nicedreamzapp/sitka/cad/renders/stoop_34.png

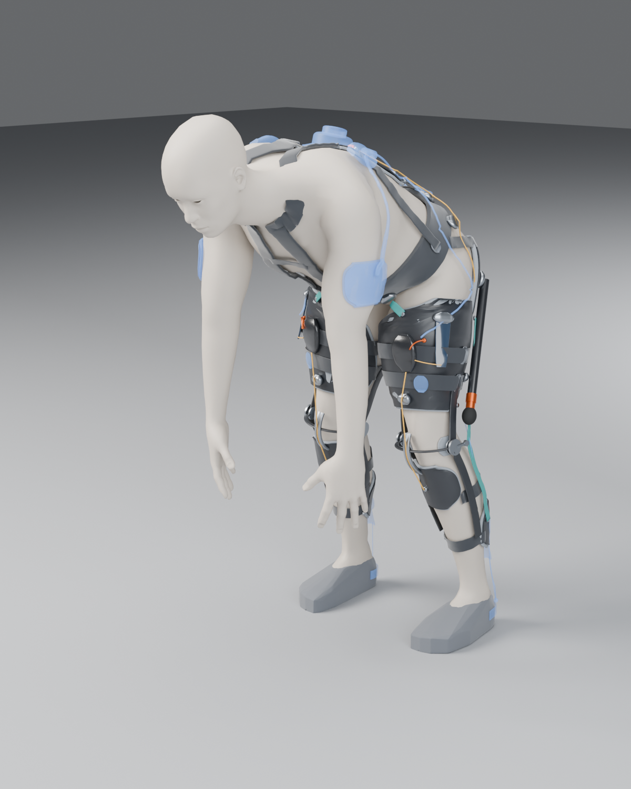
cad/renders/stoop_34.png
