nicedreamzapp/sitka/cad/renders/walk_34.png

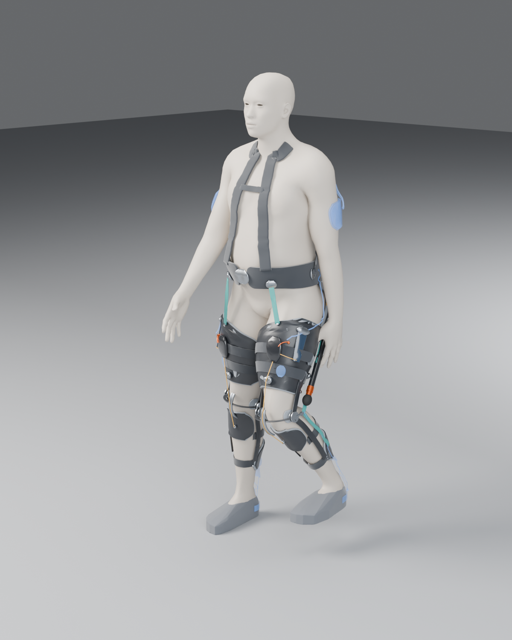
cad/renders/walk_34.png
