nicedreamzapp/sitka/cad/build/fit_report.txt

stand  strut_l: length 0.282 m (stowed)
stand  strut_r: length 0.282 m (stowed)
stand  T1 l: wrap 2 deg, phi 14..16, on arc: True
stand  T1 r: wrap 2 deg, phi 14..16, on arc: True
stand  CABLE calf_band_r: enters body by 3 mm
stand  PART knee_arc_l: into body 3.7 mm at (0.174, -0.065, 0.497)
stand  PART knee_arc_r: into body 3.7 mm at (-0.174, -0.065, 0.497)
walk   strut_l: length 0.282 m (stowed)
walk   strut_r: length 0.282 m (stowed)
walk   T1 l: wrap 59 deg, phi -15..44, on arc: True
walk   T1 r: wrap 10 deg, phi 10..20, on arc: True
walk   PART thigh_shell_l: into body 4.9 mm at (0.217, -0.01, 0.905)
walk   PART thigh_liner_l: into body 2.7 mm at (0.214, -0.02, 0.883)
run    strut_l: length 0.282 m (stowed)
run    strut_r: length 0.282 m (stowed)
run    T1 l: wrap 107 deg, phi -39..68, on arc: False
run    T1 r: wrap 42 deg, phi -6..35, on arc: True
run    FLOAT knee_arc_l: nearest skin 34 mm, at (0.145, -0.432, 0.705)
chair  strut_l: length 0.455 m (deployed)
chair  strut_r: length 0.455 m (deployed)
chair  T1 l: wrap 91 deg, phi -31..60, on arc: True
chair  T1 r: wrap 91 deg, phi -31..60, on arc: True
stoop  strut_l: length 0.282 m (stowed)
stoop  strut_r: length 0.282 m (stowed)
stoop  T1 l: wrap 24 deg, phi 3..27, on arc: True
stoop  T1 r: wrap 24 deg, phi 3..27, on arc: True
stoop  PART back_panel_liner: into body 3.8 mm at (-0.037, -0.302, 1.273)
stand  PANEL off the chest bone 0.5 deg / 0.4 mm, liner-gap change max 2.1 mm, spine link length error 0.00 mm
walk   PANEL off the chest bone 0.4 deg / 0.2 mm, liner-gap change max 2.4 mm, spine link length error 0.00 mm
run    PANEL off the chest bone 0.4 deg / 0.1 mm, liner-gap change max 2.7 mm, spine link length error 0.00 mm
chair  PANEL off the chest bone 0.4 deg / 0.3 mm, liner-gap change max 2.4 mm, spine link length error 0.00 mm
stoop  PANEL off the chest bone 2.8 deg / 43.0 mm, liner-gap change max 8.1 mm, spine link length error 0.01 mm
