nicedreamzapp/sitka/cad/renders/chair_34.png

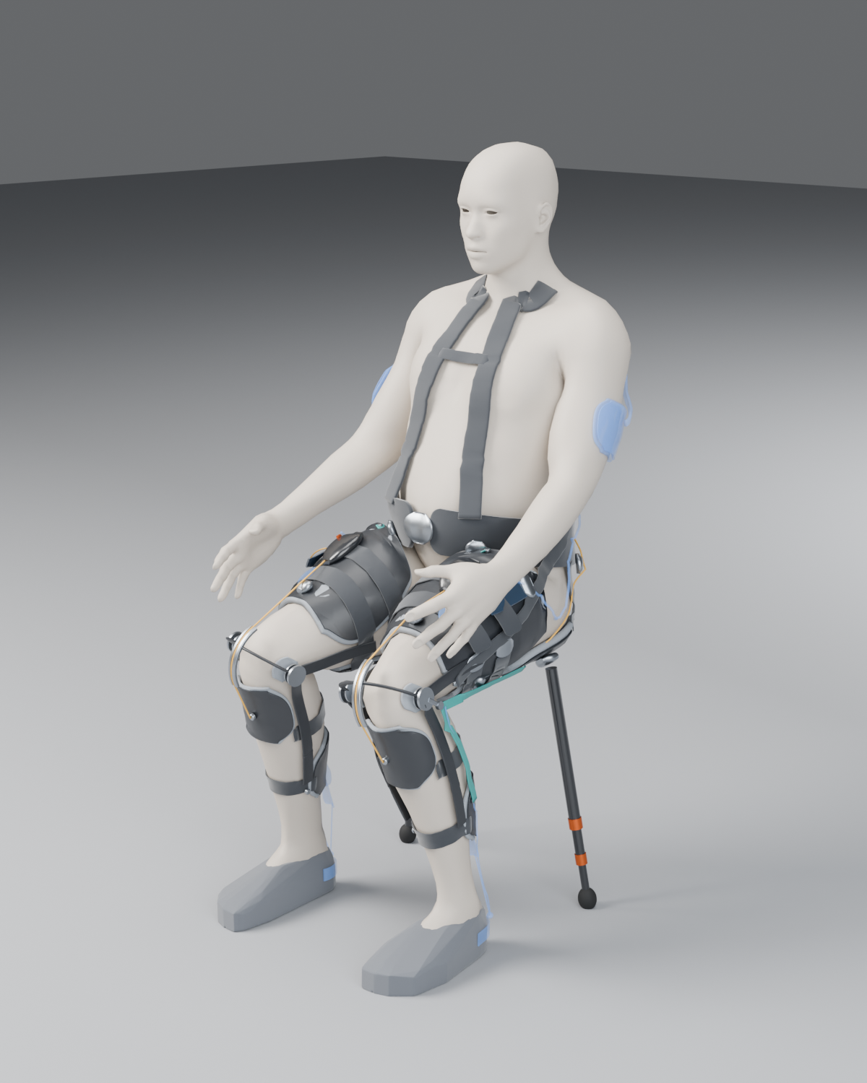
cad/renders/chair_34.png
