nicedreamzapp/sitka/cad/renders/chair_back.png

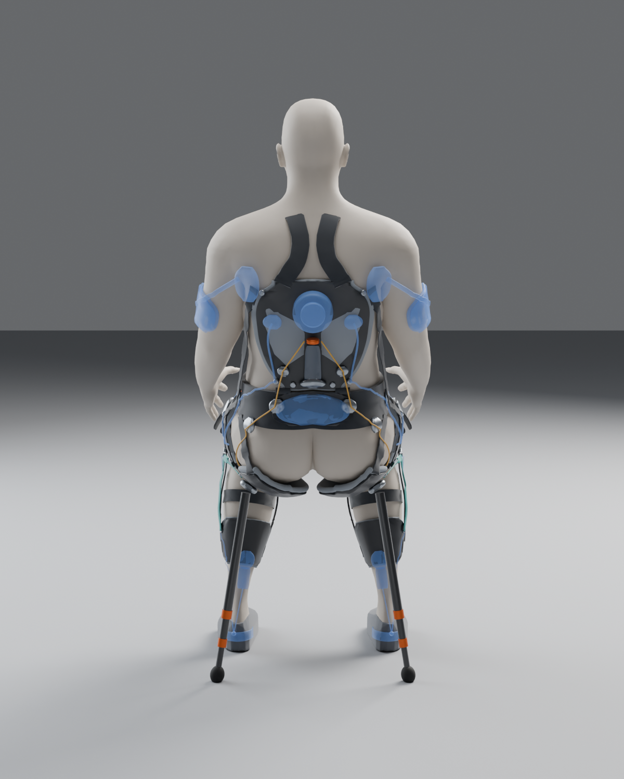
cad/renders/chair_back.png
