nicedreamzapp/sitka/cad/renders/chair_front.png

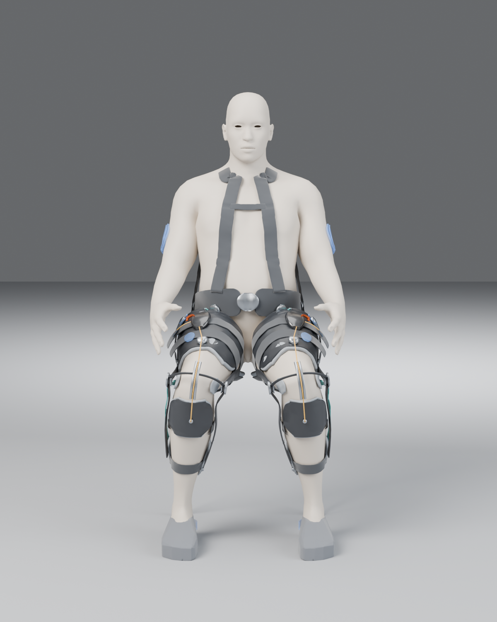
cad/renders/chair_front.png
