nicedreamzapp/sitka/cad/renders/chair_side.png

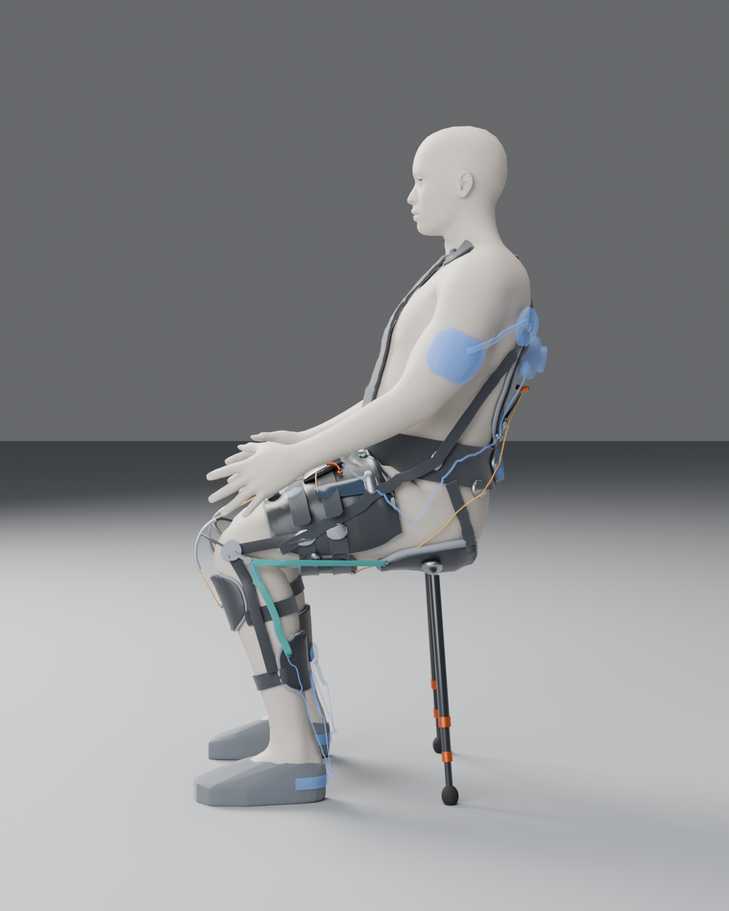
cad/renders/chair_side.png
