nicedreamzapp/sitka/cad/renders/run_34.png

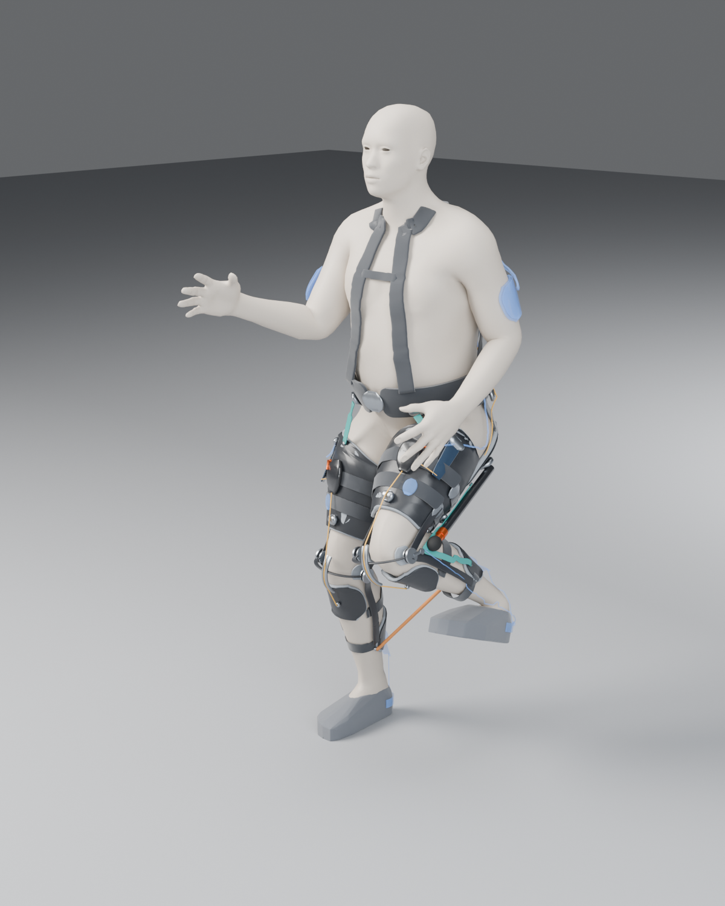
cad/renders/run_34.png
