nicedreamzapp/sitka/cad/renders/run_back.png

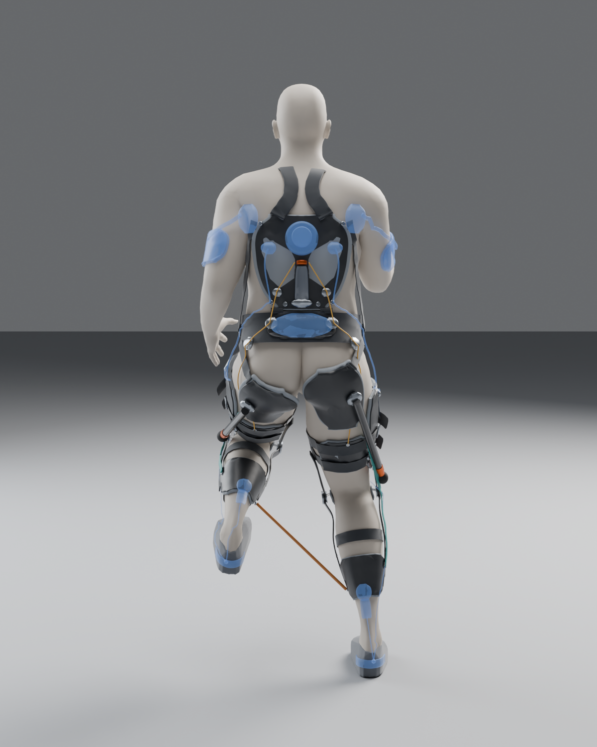
cad/renders/run_back.png
