nicedreamzapp/sitka/cad/renders/run_front.png

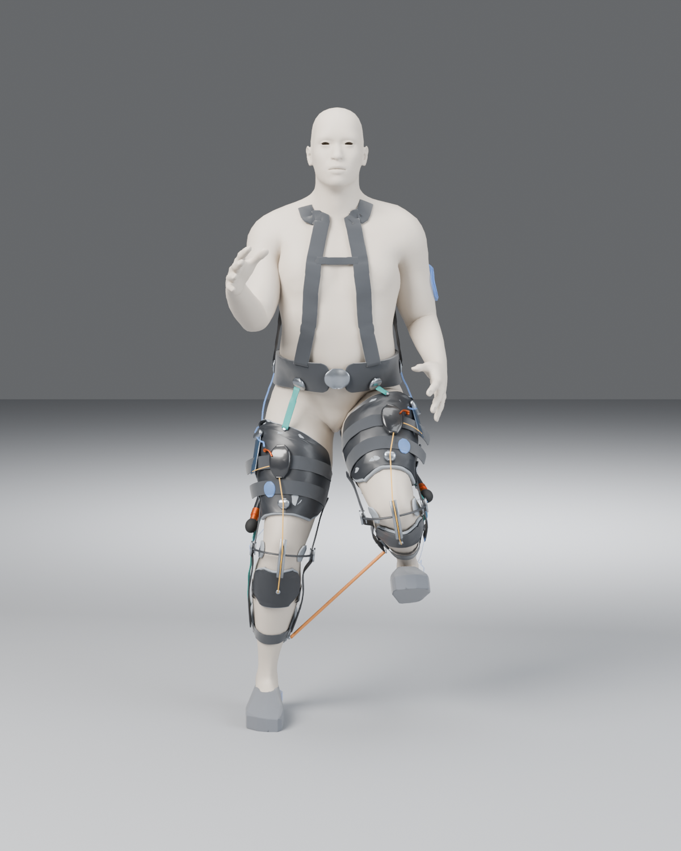
cad/renders/run_front.png
