nicedreamzapp/sitka/cad/renders/run_side.png

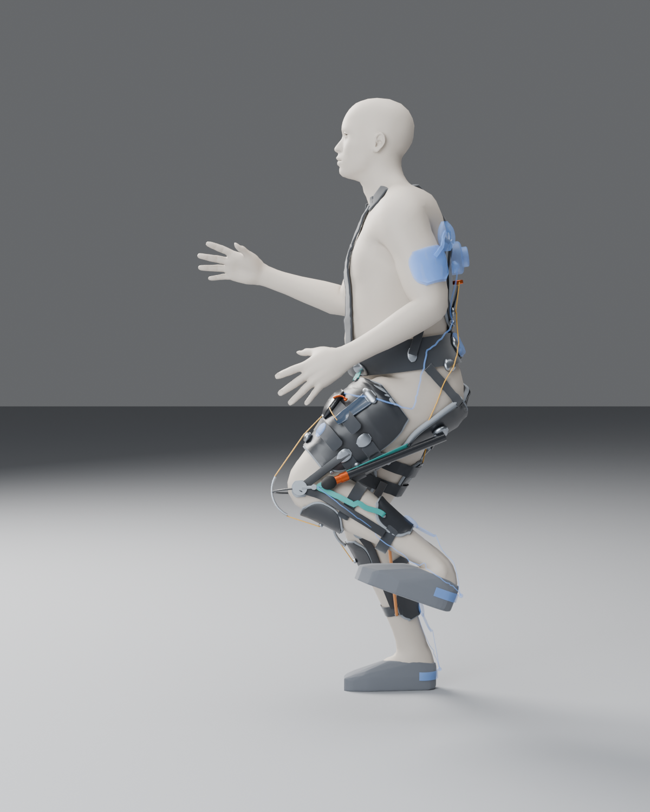
cad/renders/run_side.png
