nicedreamzapp/sitka/cad/renders/stand_34.png

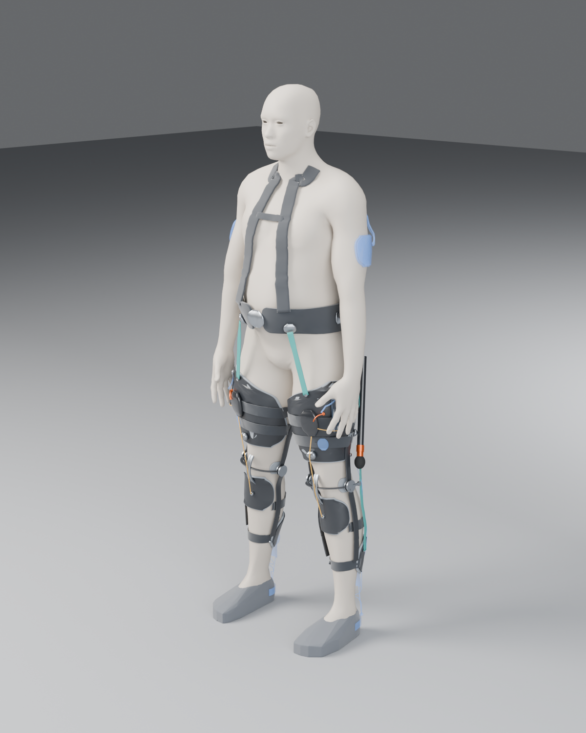
cad/renders/stand_34.png
