nicedreamzapp/sitka/cad/renders/stand_back.png

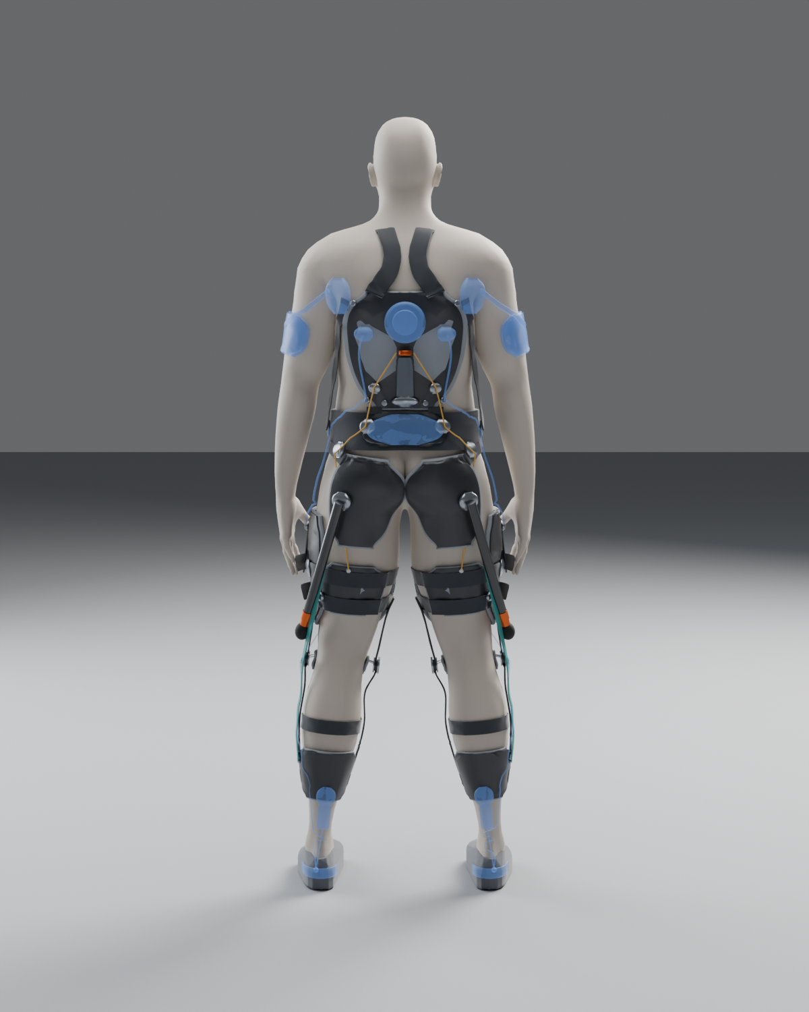
cad/renders/stand_back.png
