nicedreamzapp/sitka/cad/renders/stand_front.png

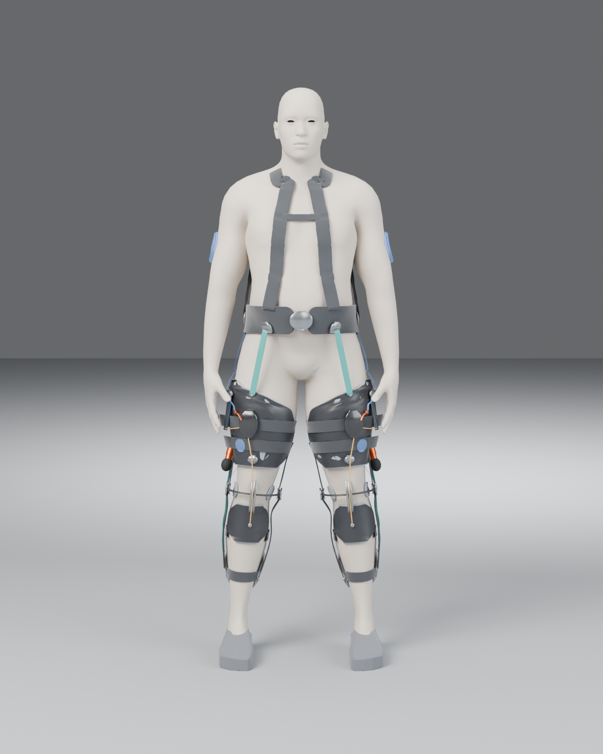
cad/renders/stand_front.png
