nicedreamzapp/sitka/cad/renders/stand_side.png

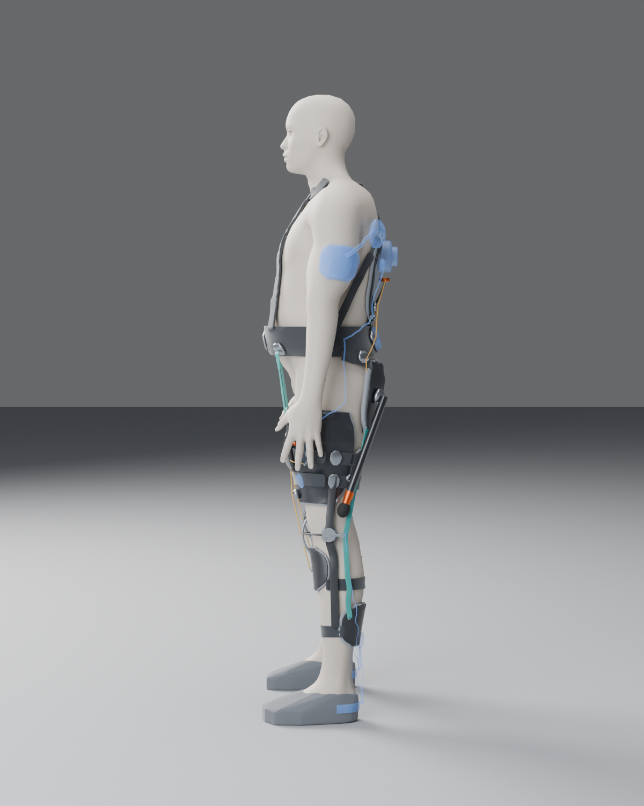
cad/renders/stand_side.png
