nicedreamzapp/sitka/cad/renders/stoop_back.png

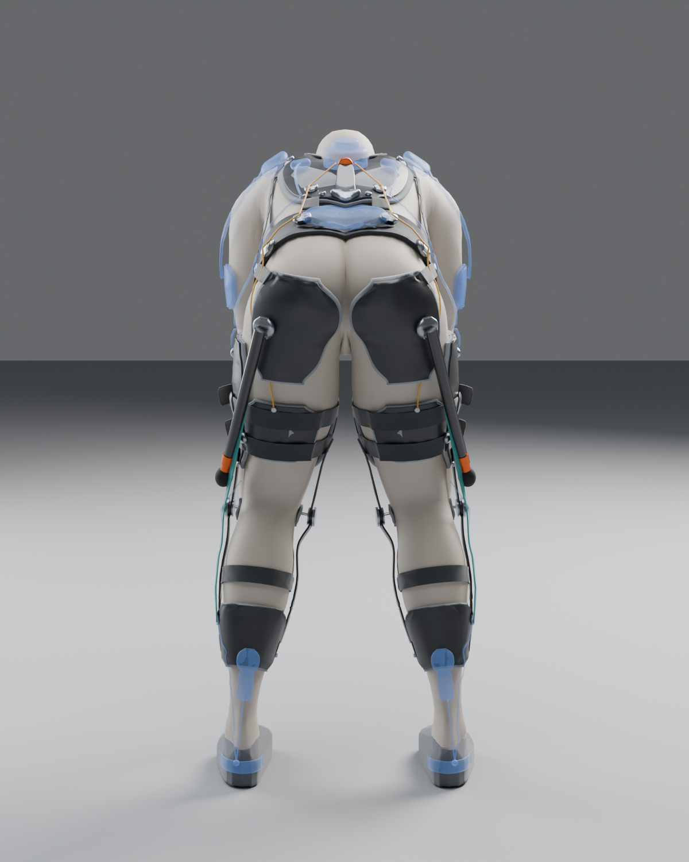
cad/renders/stoop_back.png
