nicedreamzapp/sitka/cad/renders/stoop_front.png

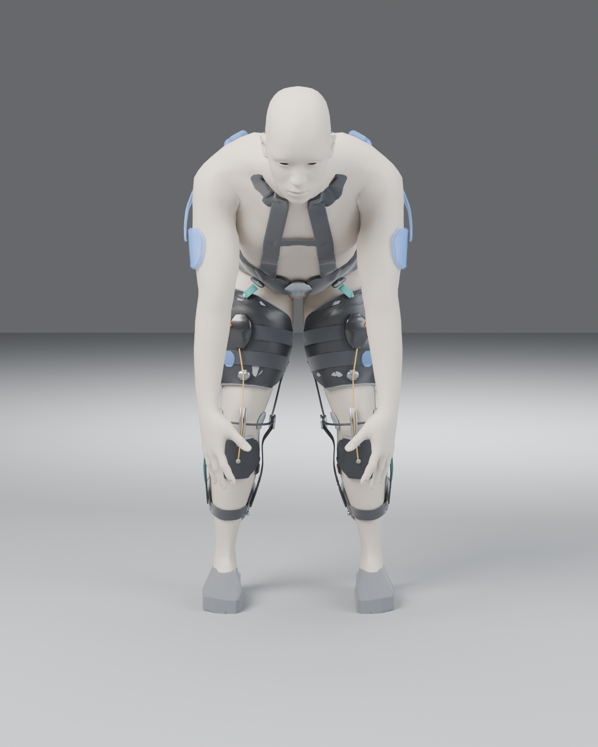
cad/renders/stoop_front.png
