nicedreamzapp/sitka/cad/renders/stoop_side.png

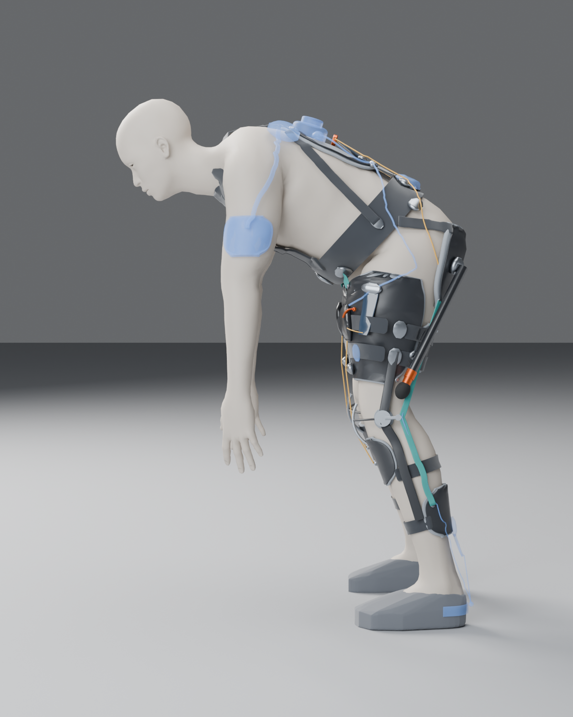
cad/renders/stoop_side.png
