nicedreamzapp/sitka/cad/renders/walk_front.png

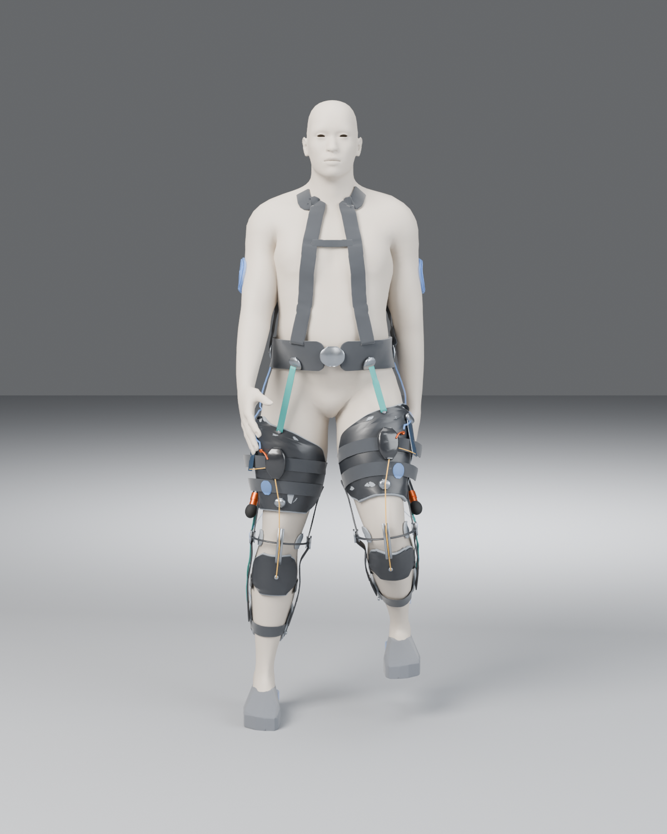
cad/renders/walk_front.png
