nicedreamzapp/sitka/cad/renders/walk_side.png

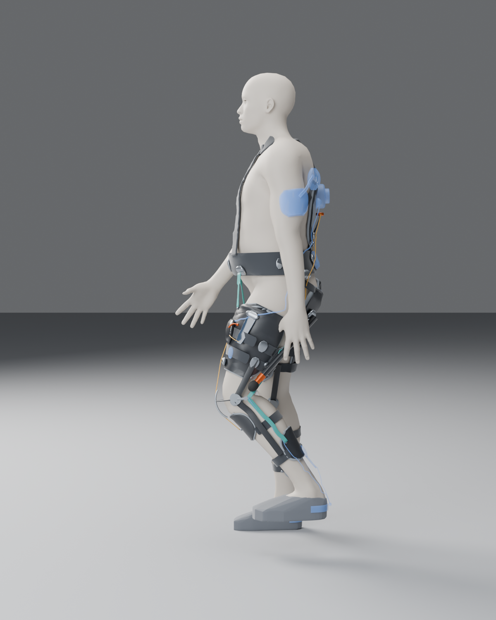
cad/renders/walk_side.png
