nicedreamzapp/sitka/docs/sitka_video_thumbnail.png

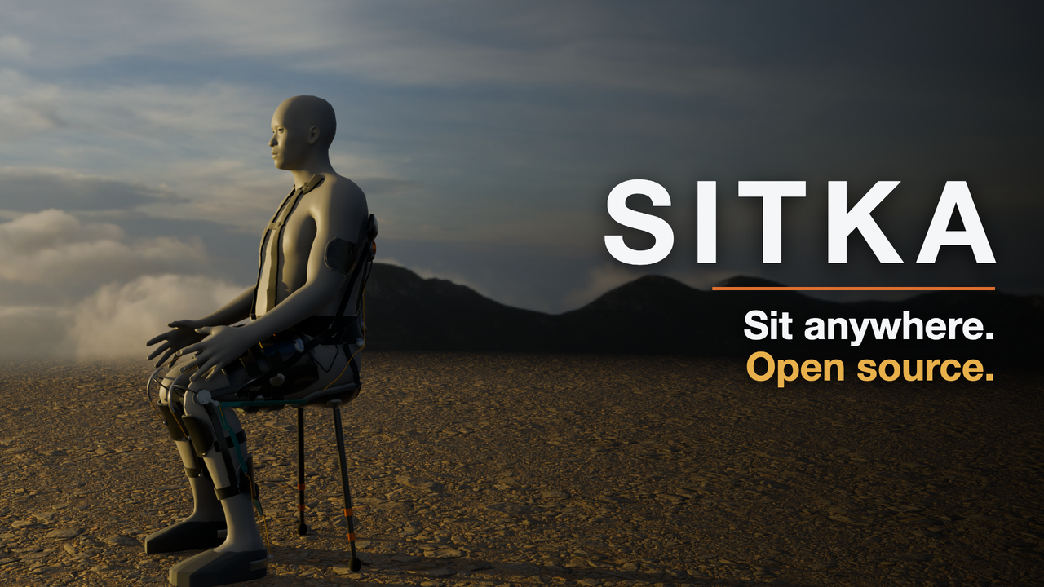
docs/sitka_video_thumbnail.png
