nicedreamzapp/sitka/PARTS_LIST.md

# Sitka parts list and cost (current design: kinetics-first, render two)

**Generated by `python3 parts_list.py` on 2026-10-22. Do not hand-edit; edit `parts_list.py`.** The same rows are in [parts.csv](parts.csv). The retired rigid v2 list is in [legacy/](legacy/PARTS_LIST_BOM.md).

Sources of truth: [KINETICS.md](KINETICS.md) (modules, tiers, loads), [TENDON_CONCEPT.md](TENDON_CONCEPT.md) (seat physics), and the build123d CAD in `cad/` (part names, and every printed and metal mass is the CAD solid volume times a density).

How to read it:

- **PRINT** = 3D-printed on a Bambu X1C / P1S class printer. **METAL** = cut or machined by a job shop. **BUY** = off the shelf, or made from bought stock (glass leaves, line, webbing).
- **EST** in a mass or cost column means an estimate, not a weighed part or a quote. Prices are USD, seen 2026-10-22 at the linked seller.
- Printed masses use 1.06 g/cm3 for PAHT-CF and 1.22 g/cm3 for TPU, with a fill factor per part (solid thin shells, 60 to 80% for chunky brackets, 15 to 25% for lattice pads). Printed cost is filament only, plus 15% for waste. Metal cost is a one-off job-shop guess.
- Prototype one prints the shells in PAHT-CF. The CAD and renders show carbon; a carbon layup (using the print as the plug) is the v2 weight and stiffness upgrade, not needed to prove the physics.
- Not included: the printer, tools, shipping, tax, your time, the bench rigs and the pressure-mapping liner (see the old `project_cost.mjs` for those).

## 1. Totals per tier

| Tier | What you get | Mass | Cost, prototype one | of which EST | Cost, batch of 10 sets (EST) | Earlier top-down target (KINETICS.md) |
|---|---|---|---|---|---|---|
| **Seat + Back starter (Dock + M1 + M2)** | Sit anywhere, stand-up help, passive lift | **6.66 kg** | **$2,850** | $2,214 | $2,071 | ~3.9 kg, ~$1,200 (Dock 0.7 + M1 2.9 + M2 0.35) |
| **B: Basic passive (+ Hip + running band)** | Adds the walking and running bands | **6.87 kg** | **$2,909** | $2,250 | $2,131 | ~4.4 kg, ~$1,300 |
| **S: Smart (+ EA clutches, sensors)** | Springs switch on at the right moment, fail open | **7.30 kg** | **$3,476** | $2,702 | $2,697 | ~4.7 kg, ~$1,900 |
| **P1: One motor** | Stairs, hills, heavy lifts | **9.29 kg** | **$4,750** | $3,225 | $3,906 | ~6.7 kg, ~$3,000 |
| **Full body (+ ankle, shoulder, couplings)** | Everything | **10.58 kg** | **$5,227** | $3,672 | $4,283 | ~9.4 kg, ~$4,100 |

Batch of 10 = metal parts at 45% of the one-off price (setup spread over 10 sets, EST); everything else unchanged.

## 2. Totals per module

| Module | Tier | Parts | Mass | Cost | of which EST | Printed PAHT-CF | Printed TPU | Print time (EST) |
|---|---|---|---|---|---|---|---|---|
| Dock (hub) | Basic | 40 | 2.15 kg | $554 | $486 | 504 g | 300 g | 49 h |
| Knee + Seat (M1) | Basic | 63 | 4.10 kg | $2,169 | $1,631 | 1039 g | 520 g | 95 h |
| Back / Lift (M2) | Basic | 15 | 0.41 kg | $126 | $97 | 188 g | 94 g | 17 h |
| Hip (M3) | Basic | 5 | 0.16 kg | $38 | $36 | 22 g | 0 g | 1 h |
| Couplings (bands) | Basic, Full body | 14 | 0.16 kg | $57 | $33 | 5 g | 0 g | 0 h |
| Smart-clutch upgrade | Smart | 21 | 0.44 kg | $567 | $452 | 0 g | 0 g | 2 h |
| One-motor power (P1) | Power (P1) | 17 | 1.99 kg | $1,275 | $523 | 2 g | 0 g | 0 h |
| Ankle (M4) | Full body | 13 | 0.53 kg | $252 | $244 | 55 g | 0 g | 4 h |
| Shoulder (M5) | Full body | 12 | 0.64 kg | $188 | $170 | 155 g | 32 g | 12 h |
| **All modules** | | 200 | **10.58 kg** | **$5,227** | $3,672 | 1970 g | 945 g | 181 h |

## 3. Did it reconcile with the README? No, and here is why

The README and KINETICS.md said the starter costs **about $1,300** and weighs **about 4.4 kg**. Counting every part in the CAD gives:

- **Seat + Back starter (Dock + Knee/Seat + Back/Lift): 6.66 kg, $2,850** for prototype one, about **$2,071** per set in a batch of 10 (EST).
- **Full body (every module, one motor): 10.58 kg, $5,227** for prototype one, about **$4,283** in a batch of 10.

Three honest reasons for the gap:

1. **The label was wrong.** The 4.4 kg / $1,300 figure in KINETICS.md is the Basic tier (Dock + Knee/Seat + Back/Lift + Hip + running band), not "Seat + Back". Seat + Back alone was about 3.9 kg / $1,200 in that same plan.
2. **The old numbers were top-down targets, this list is bottom-up.** KINETICS.md budgeted the padding at +0.15 kg and the Dock at 0.7 kg. The CAD's pads alone (graded lattice, gel and spacer mesh on every contact, sized for 15 kPa) come to about 1.2 kg, and a real padded belt, harness and webbing are another 1.1 kg.
3. **Prototype one pays one-off prices.** About $2,214 of the starter cost is estimate, mostly one-off CNC of the knee metal (hinges, arcs, spool, strut fork). The branded sprag clutches chosen for the power-off seat lock are a real price, about $300 a pair (budget ones are about $20 each, fine for the bench).

| Where the starter's mass is | Mass |
|---|---|
| Printed shells, cups and brackets (PAHT-CF) | 1.73 kg |
| Metal: hinges, arcs, arms, clamps, clevises, ports | 1.29 kg |
| Pads: TPU lattice, gel sheet, spacer mesh | 1.24 kg |
| Belt, harness, webbing, buckles | 1.22 kg |
| Struts (carbon tube, lock, foot) | 0.65 kg |
| Clutches, cleats, lines, leaves, fasteners | 0.52 kg |

**Path back down (EST, not designed yet):** carbon layup shells at 1.5 mm instead of 3 mm printed PAHT-CF (about -0.45 kg), lighter lattice or EVA in the short-hold pads (about -0.5 kg), pocketed metal (about -0.3 kg) and a lighter belt and harness (about -0.3 kg) would bring the starter to roughly **4.8 kg**. Batch pricing brings it to roughly **$1,900**. The README now quotes this list, not the old target.

## 4. Print vs metal vs buy

| Make | Parts (pieces) | Mass, full body | Cost, full body |
|---|---|---|---|
| **PRINT** | 62 | 2.98 kg | $259 |
| **METAL** | 38 | 1.53 kg | $1,715 |
| **BUY** | 100 | 6.08 kg | $3,253 |

**What must be metal, and the load that decides it.** The rule: anything the knee tendon load passes through, anything a line turns on, and anything that holds a spring root. Those parts see the 426 N sitting tension every sit, and they are sized for the **3.6 kN proof load** (the 190 Nm strut-lost catch times 1.5, from TENDON_CONCEPT.md). PAHT-CF creeps under constant load and a cable groove in plastic wears and cuts.

| Part | Module | Material | Why it must be metal (the load) |
|---|---|---|---|
| Cable ports, ball-end into keyhole (6 per Dock) | Dock (hub) | 17-4PH H900 stainless | carries the full tendon proof load of 3.6 kN |
| Spine link pivot brackets (panel and belt) | Dock (hub) | 7075-T6 aluminium | up to 770 N per link at the P1 lift peak |
| Hinge arms, thigh side | Knee + Seat (M1) | 7075-T6 aluminium | carries the knee couple, 34 Nm sitting and up to 190 Nm if the strut is lost (205 MPa, SF 2.5) |
| Hinge arms, shin side | Knee + Seat (M1) | 7075-T6 aluminium | same couple as the thigh arms |
| Geared bicentric knee hinge (hub pair per knee) | Knee + Seat (M1) | 7075-T6 aluminium | carries the arc reaction of 602 N sitting and about 3.4 kN in a strut-lost catch |
| 80 mm grooved arc (artificial kneecap) with its yoke | Knee + Seat (M1) | 7075-T6 aluminium | sees sqrt2 x T = 602 N sitting, 3.4 kN catch; a groove in plastic would creep and cut |
| Clutch spool, shaft and release dog | Knee + Seat (M1) | 7075-T6 aluminium | the tendon load passes straight through it |
| Tendon fairlead | Knee + Seat (M1) | 7075-T6 aluminium | metal preferred: 426 N line turning on it |
| Leaf root clamp with preload knob (250 to 400 N) | Knee + Seat (M1) | 7075-T6 aluminium | the leaf's root bending moment and the preload screw |
| Strut hinge under the sit bone: fork, 8 mm pin, cone spacers | Knee + Seat (M1) | 7075-T6 aluminium | the strut's 483 N push goes through it into the sit bone |
| Lift leaf root clamp + ON/OFF switch | Back / Lift (M2) | 7075-T6 aluminium | leaf root bending, 600 N total line pull |
| Hub drum, 25 mm spool | One-motor power (P1) | 7075-T6 aluminium | 720 N line pull at rated torque |
| Ankle clutch ratchet, pawl and spring set | Ankle (M4) | 17-4PH H900 stainless | the calf spring load passes through the pawl |
| Arm lever | Shoulder (M5) | 7075-T6 aluminium | arm support torque at the pivot |

**What prints:** every shell and pad (they spread pressure and do not carry the column), every housing and bracket where a metal pin or bearing takes the actual line load, and the jigs. The glute guide and heel clip are printed for prototype one but flagged: if they creep on the bench they become 7075.

**What you buy:** the carbon strut tubes, the sprag clutches, the line (Dyneema for the bench, Vectran or SK99 for wear, to keep creep under the 0.7 deg of sag per sit in TENDON_CONCEPT.md), the glass for the leaf springs, webbing, buckles, gel sheet, spacer mesh, the motor, cells and electronics.

## 5. Print time and filament (Bambu X1C / P1S class)

| Module | PAHT-CF | TPU 95A HF | PETG | Filament cost | Printer hours (EST) | Parts over 256 mm |
|---|---|---|---|---|---|---|
| Dock (hub) | 504 g | 300 g | 0 g | $68 | 49 h | back panel + pad (split or H2D) |
| Knee + Seat (M1) | 1039 g | 520 g | 0 g | $137 | 95 h | thigh shells + pads (split or H2D) |
| Back / Lift (M2) | 188 g | 94 g | 0 g | $25 | 17 h | none |
| Hip (M3) | 22 g | 0 g | 0 g | $2 | 1 h | none |
| Couplings (bands) | 5 g | 0 g | 0 g | $1 | 0 h | none |
| Smart-clutch upgrade | 0 g | 0 g | 60 g | $1 | 2 h | none |
| One-motor power (P1) | 2 g | 0 g | 0 g | $0 | 0 h | none |
| Ankle (M4) | 55 g | 0 g | 0 g | $6 | 4 h | none |
| Shoulder (M5) | 155 g | 32 g | 0 g | $18 | 12 h | none |
| **All** | **1970 g** | **945 g** | 60 g | **$259** | **181 h** | |

- **Seat + Back starter: about 1.7 kg of PAHT-CF and 0.9 kg of TPU, about 161 printer hours** (about a week on one printer). The whole body is about 181 hours.
- Hours are EST at about 15 g/h for PAHT-CF on strong settings and 20 g/h for TPU lattice.
- **Print sets** used in the tables:
  - **A (shell):** PAHT-CF (or PA12-CF), 0.4 hardened nozzle, 0.2 mm layers, wall printed solid (6 to 8 perimeters), filament dried 80 C for 8 h.
  - **B (bracket):** PAHT-CF, 0.2 mm, 5 walls, 40% gyroid, layers laid across the load, heat-set inserts.
  - **C (lattice pad):** TPU 95A HF, 0.2 mm, graded gyroid from about 12% at the skin to 25% at the shell, no supports, spacer mesh or gel glued on. KINETICS.md asks for 85A at the skin to 95A at the shell; prototype one grades the density on one material instead (VERIFY on the pressure map).
  - **D (PETG):** 0.2 mm, 3 walls, 20% infill (enclosures and jigs).
- **Too big for a 256 mm bed:** the thigh shells and pads (289 mm) and the back panel and pad (279 mm). Split them with a bolted lap joint, or print them whole on a larger bed (Bambu H2D class).
- STLs for every printed part are in `cad/stl/`. Shells are not exported as STL yet because the CAD marks them carbon; export them from `cad/step/` until the CAD gets a print variant.

## 6. The build story (prototype one)

1. **Scan and fit.** Scan the wearer's legs, hips and back with a phone. Fit the shells in `cad/parts/` to the scan and rebuild, so every pad lands where the physics says.
2. **Order the long-lead parts first:** the metal (send the STEP files from the release to three job shops), the sprag clutches, carbon tubes, line and gel sheet.
3. **Print** the shells, cups, pads and brackets while the metal is out (about 161 hours for the starter).
4. **Make the springs.** Laminate the glass leaves, then bench-test the sit leaf's force curve and 10^5 cycles before it goes on a person (gate 2 in KINETICS.md).
5. **Build one knee on the bench:** hinge, arms, arc and yoke, clutch in its housing, then splice the T1 line from the clutch over the arc to the anchor below the kneecap. **Proof-test it to 3.6 kN of line pull.** Then the second knee.
6. **Build the Dock:** belt, panel, harness, seat cups laced to the thigh cuffs, strut forks and rod ends, struts, the spine links and the Crazy Creek straps.
7. **First sits:** pressure-map the seat cup and the pad below the kneecap, then sit 10, 30 and 60 minutes with shifts (gate 1).
8. **Add the back:** lift leaf, whiffletree and the two lift lines to the thigh cuffs; stoop and squat lifts with 15 kg (gate 3).
9. **Then upgrade one module at a time:** hip bands and the running band, then the smart clutches (bench them wet and dry at 375 N first), then the motor, then ankle and shoulder.

Every gate before a part is worn is in [BUILD_RIGHT_FIRST_TIME.md](BUILD_RIGHT_FIRST_TIME.md).

## 7. Every part, by module

### Dock (hub): 2.15 kg, $554

| Part (plain name) | Technical / CAD | Qty | Make | Material | Process | Mass ea (g) | Unit | Line | Source |
|---|---|---|---|---|---|---|---|---|---|
| Back panel (carries the straps, ports and later the motor) | back_panel, 600 cm2 contoured plate | 1 | **PRINT** | PAHT-CF (or PA12-CF) | print set A (shell); 279 x 277 mm: print as two halves with a bolted lap joint on a 256 mm bed, one piece on an H2D | 250 EST | $27.27 | $27.27 | filament: [link](https://www.gigaparts.com/bambu-lab-paht-cf-black-carbon-fiber-reinforced-paht-3d-printer-filament-1-75mm-1kg-spool.html) |
| Back panel pad | back_panel_liner, spacer mesh + 6 mm lattice | 1 | **PRINT** | TPU 95A HF | print set C (lattice pad); split like the panel | 99 EST | $4.44 | $4.44 | filament: [link](https://3dprintingusa.com/collections/bambu-lab-tpu) |
| Lumbar plate (stiffens the belt at the spine) | lumbar_plate | 1 | **PRINT** | PAHT-CF (or PA12-CF) | print set A (shell) | 46 EST | $4.99 | $4.99 | filament: [link](https://www.gigaparts.com/bambu-lab-paht-cf-black-carbon-fiber-reinforced-paht-3d-printer-filament-1-75mm-1kg-spool.html) |
| Seat cup under each sit bone (242 cm2 seated footprint) | seat_cup_l/r, 16 x 19 cm seated, takes 614 N | 2 | **PRINT** | PAHT-CF (or PA12-CF) | print set A (shell); bench-proof at 1.5 x 614 N before wearing; v2 = carbon layup using the print as the plug | 100 EST | $10.88 | $21.77 | filament: [link](https://www.gigaparts.com/bambu-lab-paht-cf-black-carbon-fiber-reinforced-paht-3d-printer-filament-1-75mm-1kg-spool.html) |
| Seat cup cushion (gel + lattice; 25 kPa average, needs an air-cell insert under the sit bone) | seat_cup_liner_l/r, 15 mm graded lattice under a 3 mm gel sheet | 2 | **PRINT** | TPU 95A HF | print set C (lattice pad); air-cell insert under the sit bone to be proven on a pressure map (SEAT_SITBONE.md) | 100 EST | $4.50 | $9.00 | filament: [link](https://3dprintingusa.com/collections/bambu-lab-tpu) |
| Belt side clips | belt_sideclip_l/r | 2 | **PRINT** | PAHT-CF (or PA12-CF) | print set B (bracket) | 5 EST | $0.50 | $1.00 | filament: [link](https://www.gigaparts.com/bambu-lab-paht-cf-black-carbon-fiber-reinforced-paht-3d-printer-filament-1-75mm-1kg-spool.html) |
| Cable ports, ball-end into keyhole (6 per Dock) | port_knee/hip/shoulder_l/r, quick-release terminal, 3.6 kN proof | 6 | **METAL** | 17-4PH H900 stainless | waterjet or wire-EDM keyhole plate, then pocket; must be metal: carries the full tendon proof load of 3.6 kN | 8 EST | $18.00 EST | $108.00 | EST: one-off job-shop price, get 3 quotes |
| Hip belt, padded (backpack replacement belt) | hip_belt, 300 cm2 contact, < 10 kPa | 1 | **BUY** | nylon + EVA foam | off the shelf, e.g. a Granite Gear or Osprey replacement hip belt; add the side clips | 300 EST | $60.00 EST | $60.00 | EST: backpack replacement belts sell for about $40 to $80 |
| Belt buckle, aluminium cobra type | belt_buckle, 38 mm | 1 | **BUY** | aluminium | off the shelf (AustriAlpin Cobra style) | 55 EST | $30.00 EST | $30.00 | EST: cobra buckles sell for about $25 to $35 |
| Shoulder harness with sternum strap | harness_l/r + sternum_strap, 7 cm wide, 17 kPa at lift peak | 1 | **BUY** | nylon + spacer mesh | off the shelf backpack harness, sewn to the panel | 250 EST | $40.00 EST | $40.00 | EST: replacement backpack harness |
| Webbing: Crazy Creek straps | crazycreek_l/r (94 N at 10 deg); 25 mm polyester, low stretch | 1 | **BUY** | polyester webbing | about 3 m, cut, heat-sealed, bar-tacked | 80 EST | $20.00 EST | $20.00 | EST: polyester webbing about $1.5 to $3 per yard |
| Spine link pair, panel to belt (replaces the panel straps) | spine_link_l/r: 25 mm between centres, 11 mm carbon tube, M6 ball joint each end; 300 N per link passive lift, 770 N at the P1 peak | 2 | **BUY** | carbon tube + steel ball joints | tube bonded into two M6 ball joints (angle joints, DIN 71802 style) | 40 EST | $14.00 EST | $28.00 | EST: M6 ball joints about $4 to $8 each; rating VERIFY (typically several kN) |
| Spine link pivot brackets (panel and belt) | spine_pivot_panel_l/r + spine_pivot_belt_l/r, M6 pin each | 4 | **METAL** | 7075-T6 aluminium | CNC 7075 or a bought aluminium clevis bracket; must be metal: up to 770 N per link at the P1 lift peak | 9 EST | $15.00 EST | $60.00 | EST: one-off job-shop price, get 3 quotes |
| Seat-cup lacing kit: grommets, cord, webbing tab | cup_eyelets/cuff_eyelets/shell_eyelets (9 grommets per side), cup_lacing (3 mm cord), cup_bridge (18 mm tab) | 2 | **BUY** | brass grommets + polyester cord + webbing | set 9 mm grommets in the printed cup, cuff and shell; zigzag lace the cup to the cuff, bar-tack the tab | 30 EST | $9.00 EST | $18.00 | EST: grommet kit about $10, 3 mm cord about $0.30 per ft; 41 N per cord run at stand-up drag (SEAT_SITBONE.md) |
| Cam buckles and ladder locks for the Dock straps | 8 pieces | 8 | **BUY** | aluminium / acetal | off the shelf | 12 EST | $3.50 EST | $28.00 | EST |
| D-rings for the Crazy Creek strap at the thigh | dring_cc_l/r | 2 | **BUY** | aluminium | off the shelf, 25 mm | 6 EST | $1.50 EST | $3.00 | EST |
| Silicone gel sheet, 3 mm, fabric backed (seat cups) | skin layer of the seat-cup stack | 1 | **BUY** | silicone gel | Silipos Soft Sheer type sheet, cut to the cup outline | 120 EST | $60.00 EST | $60.00 | EST (no public price): [link](https://ortoped.ca/Silipos-Soft-Sheer-Sheeting/family-844) |
| 3D spacer mesh, 3 to 4 mm (all pad covers) | breathable skin layer for every pad | 1 | **BUY** | polyester spacer fabric | about 2 yd, sewn into washable covers | 150 EST | $16.00 EST | $16.00 | EST: about $5 to $8 per yd (eBay spacer-mesh listings) |
| Fasteners, heat-set inserts, thread-locker (Dock) | M4/M5 stainless, brass inserts | 1 | **BUY** | stainless / brass | kit | 60 EST | $15.00 EST | $15.00 | EST |
| **Subtotal** | | | | | | **2.15 kg** | | **$554** | |

### Knee + Seat (M1): 4.10 kg, $2,169

| Part (plain name) | Technical / CAD | Qty | Make | Material | Process | Mass ea (g) | Unit | Line | Source |
|---|---|---|---|---|---|---|---|---|---|
| Thigh shell, laced | thigh_shell_l/r, contoured from a 3D scan | 2 | **PRINT** | PAHT-CF (or PA12-CF) | print set A (shell); 289 mm long: split above the knee on a 256 mm bed, one piece on an H2D; v2 = carbon layup on the print as a plug | 313 EST | $34.18 | $68.35 | filament: [link](https://www.gigaparts.com/bambu-lab-paht-cf-black-carbon-fiber-reinforced-paht-3d-printer-filament-1-75mm-1kg-spool.html) |
| Thigh pad | thigh_liner_l/r, spacer mesh + 10 mm lattice | 2 | **PRINT** | TPU 95A HF | print set C (lattice pad); split like the shell | 166 EST | $7.45 | $14.89 | filament: [link](https://3dprintingusa.com/collections/bambu-lab-tpu) |
| Below-kneecap pad shell (PTB, 100 cm2) | ptb_shell_l/r, patellar-tendon-bearing pad | 2 | **PRINT** | PAHT-CF (or PA12-CF) | print set A (shell) | 73 EST | $7.95 | $15.90 | filament: [link](https://www.gigaparts.com/bambu-lab-paht-cf-black-carbon-fiber-reinforced-paht-3d-printer-filament-1-75mm-1kg-spool.html) |
| Calf pad shell (120 cm2) | calf_cuff_l/r | 2 | **PRINT** | PAHT-CF (or PA12-CF) | print set A (shell) | 77 EST | $8.45 | $16.89 | filament: [link](https://www.gigaparts.com/bambu-lab-paht-cf-black-carbon-fiber-reinforced-paht-3d-printer-filament-1-75mm-1kg-spool.html) |
| Shin pad (gel + lattice) | shin_liner_l/r, 12 mm lattice under 3 mm gel | 2 | **PRINT** | TPU 95A HF | print set C (lattice pad) | 39 EST | $1.74 | $3.49 | filament: [link](https://3dprintingusa.com/collections/bambu-lab-tpu) |
| Calf pad lattice | calf_liner_l/r | 2 | **PRINT** | TPU 95A HF | print set C (lattice pad) | 42 EST | $1.88 | $3.77 | filament: [link](https://3dprintingusa.com/collections/bambu-lab-tpu) |
| Knee side pads | condyle_pad_lat/med_l/r | 4 | **PRINT** | TPU 95A HF | print set C (lattice pad) | 6 EST | $0.29 | $1.15 | filament: [link](https://3dprintingusa.com/collections/bambu-lab-tpu) |
| Hinge arms, thigh side | thigh_arm_lat/med_l/r, 24 x 4.8 mm strip | 4 | **METAL** | 7075-T6 aluminium | laser cut flat from 0.190 in 7075-T6 (SendCutSend lists it), the CAD joggle taken up by a printed spacer at the shell; must be metal: carries the knee couple, 34 Nm sitting and up to 190 Nm if the strut is lost (205 MPa, SF 2.5) | 61 EST | $22.00 EST | $88.00 | EST: one-off job-shop price, get 3 quotes |
| Hinge arms, shin side | shin_arm_lat/med_l/r, 24 x 4.8 mm strip | 4 | **METAL** | 7075-T6 aluminium | laser cut flat from 0.190 in 7075-T6, same as the thigh arms; must be metal: same couple as the thigh arms | 95 EST | $26.00 EST | $104.00 | EST: one-off job-shop price, get 3 quotes |
| Geared bicentric knee hinge (hub pair per knee) | knee_hub_lat/med_l/r, two geared plates + cover | 4 | **METAL** | 7075-T6 aluminium | CNC 7075, gear segments milled or wire-EDM; must be metal: carries the arc reaction of 602 N sitting and about 3.4 kN in a strut-lost catch | 23 EST | $70.00 EST | $280.00 | EST: one-off job-shop price, get 3 quotes |
| 80 mm grooved arc (artificial kneecap) with its yoke | knee_arc_l/r + knee_yoke_l/r, r = 80 mm, 93 deg sector | 2 | **METAL** | 7075-T6 aluminium | CNC 7075 as one piece, groove polished for the line; must be metal: sees sqrt2 x T = 602 N sitting, 3.4 kN catch; a groove in plastic would creep and cut | 78 EST | $160.00 EST | $320.00 | EST: one-off job-shop price, get 3 quotes |
| Cam clutch housing + mode lever mount | knee_manifold_l/r, WALK / SIT-LIFT / FREE | 2 | **PRINT** | PAHT-CF (or PA12-CF) | print set B (bracket); the housing only positions the clutch; the load path is the metal spool, shaft and pins | 49 EST | $5.39 | $10.78 | filament: [link](https://www.gigaparts.com/bambu-lab-paht-cf-black-carbon-fiber-reinforced-paht-3d-printer-filament-1-75mm-1kg-spool.html) |
| One-way sprag clutch (the power-off seat lock) | CSK20-PP, 20 x 47 x 14 mm, 50 Nm rated | 2 | **BUY** | bearing steel | off the shelf, pressed into a 7075 spool of 14 mm radius: 50 Nm = 3.57 kN line pull, right at the 3.6 kN proof, so proof-test or step up to CSK25 | 110 EST | $150.00 | $300.00 | [link](https://uk.rs-online.com/web/p/sprag-clutch-bearings/1465256) |
| Clutch spool, shaft and release dog | inside knee_manifold: spool r = 14 mm, the mode lever frees or grounds the outer race | 2 | **METAL** | 7075-T6 aluminium | CNC 7075 spool, 17-4PH shaft and dog; must be metal: the tendon load passes straight through it | 60 EST | $70.00 EST | $140.00 | EST: one-off job-shop price, get 3 quotes |
| Mode lever | mode_lever_l/r | 2 | **PRINT** | PAHT-CF (or PA12-CF) | print set B (bracket) | 2 EST | $0.18 | $0.35 | filament: [link](https://www.gigaparts.com/bambu-lab-paht-cf-black-carbon-fiber-reinforced-paht-3d-printer-filament-1-75mm-1kg-spool.html) |
| Tendon fairlead | tendon_fairlead_l/r, turns T1 onto the arc | 2 | **METAL** | 7075-T6 aluminium | CNC 7075 with a polished radius (or a printed body with a stainless sheave); metal preferred: 426 N line turning on it | 19 EST | $35.00 EST | $70.00 | EST: one-off job-shop price, get 3 quotes |
| Sit leaf spring (350 N near-constant, 44 J) | sit_leaf_l/r, tapered glass leaf, 126 mm stroke | 2 | **BUY** | unidirectional E-glass laminate (bow-limb glass) | laminate 5 to 6 strips of 0.030 in bow glass with epoxy, taper-ground, bench-tested to 10^5 cycles | 34 EST | $15.00 EST | $30.00 | glass strips: [link](https://bigjimsbowcompany.com/?p=8861) ($13 to $15 per 72 in strip); leaf price EST |
| Leaf root clamp with preload knob (250 to 400 N) | sit_leaf_root_l/r | 2 | **METAL** | 7075-T6 aluminium | CNC 7075; must be metal: the leaf's root bending moment and the preload screw | 27 EST | $40.00 EST | $80.00 | EST: one-off job-shop price, get 3 quotes |
| Telescoping carbon strut, 5 sections, one-way lock, rubber foot | strut_tube0..4 24/21/18/15/12 x 1.2 mm, 0.28 m stowed to 0.87 m; 483 N, buckles at 2.8 kN at 0.65 m | 2 | **BUY** | roll-wrapped 3K carbon tube | five tubes cut to 0.20 m, bushed, four twist-lock collars, pivoting rubber cane tip; stowed short so it clears the calf in a running swing | 290 EST | $95.00 EST | $190.00 | tubes about $10 to $20 each ([link](https://aws.robu.in/?p=894416) lists 24 x 22 x 1000 mm); cane tip $18.95 (legacy list); locks EST |
| Strut hinge under the sit bone: fork, 8 mm pin, cone spacers | strut_fork_l/r + strut_hingepin_l/r; fold about the pin, 9 deg splay in the rod end | 2 | **METAL** | 7075-T6 aluminium | CNC 7075 fork on the cup, 17-4PH pin; must be metal: the strut's 483 N push goes through it into the sit bone | 48 EST | $60.00 EST | $120.00 | EST: one-off job-shop price, get 3 quotes |
| High-misalignment rod end on the strut top | strut_rodend_l/r, 8 mm bore, +-16 deg (the gate checks the swing stays inside it) | 2 | **BUY** | steel / PTFE liner | threaded into the top tube's bonded insert | 35 EST | $25.00 EST | $50.00 | EST: high-misalignment rod ends about $15 to $35 (VERIFY angle and load) |
| Strut stow clips, top (on the cup) and bottom (on the cuff) | strut_clip_hi_l/r + strut_clip_l/r, C-saddles | 4 | **PRINT** | PAHT-CF (or PA12-CF) | print set B (bracket) | 3 EST | $0.32 | $1.27 | filament: [link](https://www.gigaparts.com/bambu-lab-paht-cf-black-carbon-fiber-reinforced-paht-3d-printer-filament-1-75mm-1kg-spool.html) |
| Knee seat tendon T1 + backup strap line | t1_tendon_l/r: 1/8 in (3.2 mm) 12-strand Dyneema; production: Vectran or SK99 (low creep) | 1 | **BUY** | Dyneema SK75 (bench) / Vectran | spliced eyes; about 25 ft covers T1, the backup lines and practice splices | 15 EST | $11.75 | $11.75 | [link](https://www.fisheriessupply.com/samson-rope-blue-amsteel-blue/872007006030) ($0.47/ft, 1/8 in) |
| Backup strap cleat (catches if the clutch slips) | own cleat, set 3 mm slacker than T1, nylon line for a soft catch | 2 | **BUY** | aluminium + composite | Harken 150 Cam-Matic on 6 mm nylon double braid; VERIFY its working load against the 1.2 kN catch | 30 EST | $44.95 | $89.90 | [link](https://defender.com/en_us/harken-150-standard-cam-matic-cleat) |
| Tendon anchor below the kneecap | shin_anchor_l/r, 3.6 kN proof | 2 | **BUY** | 316 stainless | off the shelf stainless pad eye, through-bolted with a backing plate | 12 EST | $12.00 EST | $24.00 | EST: small marine pad eyes $8 to $15 |
| Thigh and shin straps + buckles | thigh_strap0/1, shin_strap0/1, thigh_buckle0/1 (L and R) | 2 | **BUY** | nylon webbing + aluminium cam buckles | 38 mm webbing, cut and bar-tacked; lacing for the shells | 90 EST | $25.00 EST | $50.00 | EST |
| Silicone gel sheet, 3 mm (below-kneecap pads) | skin layer on the shear-loaded pads | 1 | **BUY** | silicone gel | cut to the PTB pad outline | 60 EST | $60.00 EST | $60.00 | EST (no public price): [link](https://ortoped.ca/Silipos-Soft-Sheer-Sheeting/family-844) |
| Fasteners, inserts, bushings (knee) | M4/M5 12.9 and stainless, oilite bushings | 1 | **BUY** | steel / bronze | kit | 80 EST | $25.00 EST | $25.00 | EST |
| **Subtotal** | | | | | | **4.10 kg** | | **$2,169** | |

### Back / Lift (M2): 0.41 kg, $126

| Part (plain name) | Technical / CAD | Qty | Make | Material | Process | Mass ea (g) | Unit | Line | Source |
|---|---|---|---|---|---|---|---|---|---|
| Lift leaf spring (3.1 N/mm, slack below 35 deg) | m2_leaf, tapered glass leaf at the panel | 1 | **BUY** | unidirectional E-glass laminate | laminated like the sit leaf; 300 N per side at a 90 deg stoop | 34 EST | $15.00 EST | $15.00 | glass strips: [link](https://bigjimsbowcompany.com/?p=8861); leaf price EST |
| Lift leaf root clamp + ON/OFF switch | m2_leaf_root; OFF when sitting | 1 | **METAL** | 7075-T6 aluminium | CNC 7075; must be metal: leaf root bending, 600 N total line pull | 31 EST | $45.00 EST | $45.00 | EST: one-off job-shop price, get 3 quotes |
| Whiffletree (floating pulley, equal left/right share) | whiffletree | 1 | **BUY** | aluminium + stainless | small sailing block, about 20 mm sheave | 25 EST | $25.00 EST | $25.00 | EST: micro blocks $15 to $35 |
| Lumbar standoff | lumbar_standoff_l/r | 2 | **PRINT** | PAHT-CF (or PA12-CF) | print set B (bracket); line runs over a 6 mm stainless pin pressed in, not over the plastic | 11 EST | $1.16 | $2.33 | filament: [link](https://www.gigaparts.com/bambu-lab-paht-cf-black-carbon-fiber-reinforced-paht-3d-printer-filament-1-75mm-1kg-spool.html) |
| Glute guide (100 mm lever) | glute_guide_l/r, takes the lift tendon wrap | 2 | **PRINT** | PAHT-CF (or PA12-CF) | print set B (bracket); stainless pin insert; bench-proof at 1.2 kN (the P1 peak is 800 N per side): VERIFY, CNC 7075 if it creeps | 11 EST | $1.17 | $2.35 | filament: [link](https://www.gigaparts.com/bambu-lab-paht-cf-black-carbon-fiber-reinforced-paht-3d-printer-filament-1-75mm-1kg-spool.html) |
| Panel line guides | panel_guide_l/r | 2 | **PRINT** | PAHT-CF (or PA12-CF) | print set B (bracket) | 4 EST | $0.43 | $0.86 | filament: [link](https://www.gigaparts.com/bambu-lab-paht-cf-black-carbon-fiber-reinforced-paht-3d-printer-filament-1-75mm-1kg-spool.html) |
| Posterior thigh cuff (lift anchor, 200 cm2) | thigh_cuff_l/r | 2 | **PRINT** | PAHT-CF (or PA12-CF) | print set A (shell) | 69 EST | $7.52 | $15.04 | filament: [link](https://www.gigaparts.com/bambu-lab-paht-cf-black-carbon-fiber-reinforced-paht-3d-printer-filament-1-75mm-1kg-spool.html) |
| Thigh cuff pad | thigh_cuff_liner_l/r, gel + 12 mm lattice | 2 | **PRINT** | TPU 95A HF | print set C (lattice pad) | 47 EST | $2.10 | $4.20 | filament: [link](https://3dprintingusa.com/collections/bambu-lab-tpu) |
| Lift tendon T3 line | t3_tendon_l/r, 1/8 in Dyneema, about 1 m each | 1 | **BUY** | Dyneema SK75 | spliced eyes | 10 EST | $3.76 | $3.76 | [link](https://www.fisheriessupply.com/samson-rope-blue-amsteel-blue/872007006030) |
| Stainless roller pins and D-rings | 6 mm pins for the standoffs, dring_t3_l/r | 1 | **BUY** | 316 stainless / aluminium | off the shelf | 30 EST | $12.00 EST | $12.00 | EST |
| **Subtotal** | | | | | | **0.41 kg** | | **$126** | |

### Hip (M3): 0.16 kg, $38

| Part (plain name) | Technical / CAD | Qty | Make | Material | Process | Mass ea (g) | Unit | Line | Source |
|---|---|---|---|---|---|---|---|---|---|
| Hip-flexor standoff (60 mm lever) | m3_standoff_l/r | 2 | **PRINT** | PAHT-CF (or PA12-CF) | print set B (bracket); stainless pin insert | 11 EST | $1.22 | $2.44 | filament: [link](https://www.gigaparts.com/bambu-lab-paht-cf-black-carbon-fiber-reinforced-paht-3d-printer-filament-1-75mm-1kg-spool.html) |
| Hip-flexor spring element (14 N/mm, 300 N at 20 deg) | m3_band_l/r: webbing in series with a steel extension spring | 2 | **BUY** | music-wire spring + polyester webbing | a 14 N/mm, 30 mm-travel extension spring sewn into a 20 mm webbing band; latex is far too soft for this rate | 60 EST | $15.00 EST | $30.00 | EST: industrial extension springs $5 to $12 |
| D-rings and slides for the hip bands | dring_m3_l/r | 1 | **BUY** | aluminium | off the shelf | 15 EST | $6.00 EST | $6.00 | EST |
| **Subtotal** | | | | | | **0.16 kg** | | **$38** | |

### Couplings (bands): 0.16 kg, $57

| Part (plain name) | Technical / CAD | Qty | Make | Material | Process | Mass ea (g) | Unit | Line | Source |
|---|---|---|---|---|---|---|---|---|---|
| Running band (shoe to shoe or shin to shin, RUN only) | running_band, latex tube about 0.25 m, Simpson 2019 exotendon | 1 | **BUY** | latex tubing | cut to length, knotted or crimped to the clips; tune stiffness on the treadmill | 50 EST | $21.00 | $21.00 | [link](https://www.walmart.com/ip/20969124) (TheraBand heavy tubing, 25 ft, about $21) |
| Running band clips | runband_clip_l/r | 2 | **PRINT** | PAHT-CF (or PA12-CF) | print set B (bracket) | 0 EST | $0.06 | $0.12 | filament: [link](https://www.gigaparts.com/bambu-lab-paht-cf-black-carbon-fiber-reinforced-paht-3d-printer-filament-1-75mm-1kg-spool.html) |
| Hamstring band (hip + knee coupling, 3 N/mm) | hamstring_band_l/r, 126 N at 42 mm, OFF in SIT | 2 | **BUY** | latex (speargun-type rubber) + webbing | cut to length and tuned; a TheraBand strand is about 50 times too soft | 40 EST | $12.00 EST | $24.00 | EST: speargun rubber about $3 to $5 per ft |
| Band guide 40 mm behind the knee axis | knee_guide_l/r, with a 623 bearing pulley | 2 | **PRINT** | PAHT-CF (or PA12-CF) | print set B (bracket) | 2 EST | $0.21 | $0.42 | filament: [link](https://www.gigaparts.com/bambu-lab-paht-cf-black-carbon-fiber-reinforced-paht-3d-printer-filament-1-75mm-1kg-spool.html) |
| Coupling D-rings | dring_ham_l/r, dring_ham_calf_l/r | 4 | **BUY** | aluminium | off the shelf | 3 EST | $1.50 EST | $6.00 | EST |
| Calf band line (knee + ankle, needs M4) | calf_band_l/r, from a D-ring on the thigh cuff (dring_calf_l/r) | 1 | **BUY** | Dyneema SK75 | spliced | 5 EST | $2.82 | $2.82 | [link](https://www.fisheriessupply.com/samson-rope-blue-amsteel-blue/872007006030) |
| Calf band D-rings on the thigh cuff | dring_calf_l/r | 2 | **BUY** | aluminium | off the shelf, riveted to the cuff | 6 EST | $1.50 EST | $3.00 | EST |
| **Subtotal** | | | | | | **0.16 kg** | | **$57** | |

### Smart-clutch upgrade: 0.44 kg, $567

| Part (plain name) | Technical / CAD | Qty | Make | Material | Process | Mass ea (g) | Unit | Line | Source |
|---|---|---|---|---|---|---|---|---|---|
| Electroadhesive stance clutch (fails open) | ea_clutch_l/r, about 8 electrode pairs for 375 N at SF 2, 26 g element | 2 | **BUY** | PET film electrodes, dielectric film | built from film to the Diller/Collins ICRA 2016 recipe; bench-test wet and dry at 375 N | 30 EST | $100.00 EST | $200.00 | EST: KINETICS.md target of about $200 a pair |
| Stance leaf (15.6 N/mm, 330 N breakaway stop) | T1b branch | 2 | **BUY** | glass laminate | laminated like the sit leaf | 25 EST | $15.00 EST | $30.00 | EST |
| High-voltage driver for the EA clutches | about 300 V, mW level | 1 | **BUY** | electronics | small HV DC-DC module + switching | 30 EST | $90.00 EST | $90.00 | EST |
| Microcontroller, Teensy 4.1 | 600 MHz, native CAN | 1 | **BUY** | electronics | off the shelf | 10 | $31.50 | $31.50 | [link](https://www.sparkfun.com/teensy-4-1.html) (legacy list price) |
| Shank IMU, Adafruit BNO085 | gait phase | 2 | **BUY** | electronics | off the shelf | 5 | $29.50 | $59.00 | [link](https://www.adafruit.com/product/4754) (legacy list price) |
| Insole pressure sensors, Interlink FSR 402 | 4 per foot | 8 | **BUY** | electronics | taped into a thin insole | 2 | $2.99 | $23.92 | [link](https://www.interlinkelectronics.com/products/fsr-model-402) (legacy list price) |
| Tendon load cell + HX711 | reads T1 tension, coaches the recline (warns at about 500 N) | 2 | **BUY** | electronics | inline mini load cell | 25 EST | $35.00 EST | $70.00 | EST |
| Small battery, 1 cell 21700 (16 Wh) + charger board | Molicel P45B | 1 | **BUY** | Li-ion | with a protection/charge board | 90 EST | $20.75 EST | $20.75 | [link](https://www.batteryjunction.com/molicel-inr21700-p45b) ($8.75) + board EST |
| Wiring, connectors, haptic buzzers | JST-GH, braided sleeve, 2 haptic discs | 1 | **BUY** | electronics | kit | 60 EST | $40.00 EST | $40.00 | EST |
| Controller enclosure | on the back panel, about 60 g | 1 | **PRINT** | PETG | print set D (PETG) | 60 EST | $1.38 EST | $1.38 | filament: EST (Bambu PETG HF, about $20/kg) |
| **Subtotal** | | | | | | **0.44 kg** | | **$567** | |

### One-motor power (P1): 1.99 kg, $1,275

| Part (plain name) | Technical / CAD | Qty | Make | Material | Process | Mass ea (g) | Unit | Line | Source |
|---|---|---|---|---|---|---|---|---|---|
| Motor, CubeMars AK10-9 V3 (one, on the back) | p1_motor, 9:1 QDD, 18 Nm rated, CAN | 1 | **BUY** | actuator | off the shelf | 960 EST | $698.90 | $698.90 | [link](https://aifitlab.com/collections/cubemars-motor/products/cubemars-ak10-9-v3-0-motor) ($698.90, motor; $935 with driver at OpenELAB) |
| Hub drum, 25 mm spool | p1_drum | 1 | **METAL** | 7075-T6 aluminium | CNC 7075; must be metal: 720 N line pull at rated torque | 71 EST | $120.00 EST | $120.00 | EST: one-off job-shop price, get 3 quotes |
| Dog clutches pick left, right or both (solenoid + steel dogs) | p1_dogclutch_l/r | 2 | **BUY** | 17-4PH dogs + bistable solenoid | CNC dogs (EST $60) + Intertec ITS-LX-2218 latching solenoid (about $54) | 80 EST | $114.00 EST | $228.00 | solenoid: [link](https://rapidonline.com/intertec-its-lx-2218-12vdc-10mm-4n-de-energised-20n-bi-directional-solenoid-50-2909); dogs EST |
| Bowden end stop on the clutch housing | bowden_stop_l/r, the housing ferrule seats in it | 2 | **PRINT** | PAHT-CF (or PA12-CF) | print set B (bracket); brass ferrule cup pressed in | 1 EST | $0.11 | $0.22 | filament: [link](https://www.gigaparts.com/bambu-lab-paht-cf-black-carbon-fiber-reinforced-paht-3d-printer-filament-1-75mm-1kg-spool.html) |
| Bowden cables, hub to knee manifold | bowden_l/r, efficiency 0.68 to 0.79, 551 N motor side | 2 | **BUY** | PTFE-lined housing + 7x19 stainless inner | motorcycle-clutch style housing, swaged ends | 80 EST | $30.00 EST | $60.00 | EST |
| Battery, 97 Wh (under the FAA 100 Wh line), 6S1P Molicel P45B | p1_battery | 6 | **BUY** | Li-ion 21700 cell | spot-welded pack | 70 | $8.75 | $52.50 | [link](https://www.batteryjunction.com/molicel-inr21700-p45b) ($8.75 each) |
| 6S BMS, nickel strip, pack case, fuse | for the 97 Wh pack | 1 | **BUY** | electronics | kit + printed case | 100 EST | $25.00 EST | $25.00 | EST |
| 6S balance charger | one-time | 1 | **BUY** | electronics | off the shelf | 0 EST | $45.00 EST | $45.00 | EST (legacy list) |
| CAN transceiver + power wiring + E-stop | SN65HVD230, XT30, big red stop on the belt | 1 | **BUY** | electronics | kit | 120 EST | $45.00 EST | $45.00 | EST |
| **Subtotal** | | | | | | **1.99 kg** | | **$1,275** | |

### Ankle (M4): 0.53 kg, $252

| Part (plain name) | Technical / CAD | Qty | Make | Material | Process | Mass ea (g) | Unit | Line | Source |
|---|---|---|---|---|---|---|---|---|---|
| Heel clip | m4_heelclip_l/r | 2 | **PRINT** | PAHT-CF (or PA12-CF) | print set B (bracket); prototype only; CNC 7075 if the bench shows creep under the 15 to 25 Nm ankle torque | 13 EST | $1.40 | $2.80 | filament: [link](https://www.gigaparts.com/bambu-lab-paht-cf-black-carbon-fiber-reinforced-paht-3d-printer-filament-1-75mm-1kg-spool.html) |
| Ankle clutch housing (Collins type, no power) | m4_clutch_l/r | 2 | **PRINT** | PAHT-CF (or PA12-CF) | print set B (bracket) | 15 EST | $1.60 | $3.20 | filament: [link](https://www.gigaparts.com/bambu-lab-paht-cf-black-carbon-fiber-reinforced-paht-3d-printer-filament-1-75mm-1kg-spool.html) |
| Ankle clutch ratchet, pawl and spring set | inside m4_clutch: engages at foot-flat, releases at push-off | 2 | **METAL** | 17-4PH H900 stainless | CNC / wire-EDM 17-4PH; must be metal: the calf spring load passes through the pawl | 35 EST | $60.00 EST | $120.00 | EST: one-off job-shop price, get 3 quotes |
| Calf spring leaf | m4_spring_l/r | 2 | **BUY** | unidirectional E-glass laminate | laminated like the sit leaf | 12 EST | $10.00 EST | $20.00 | EST |
| Ankle frame, shin pad to heel clip (not in the CAD yet) | carbon strip pair per side, after the Collins 2015 device | 2 | **BUY** | carbon strip or 7075 strip | cut from 3 mm carbon plate, bonded and bolted | 150 EST | $40.00 EST | $80.00 | EST: the CAD shows only the clip, clutch and leaf; Collins' whole device was about 0.4 to 0.5 kg per leg |
| Ankle cable | m4_cable_l/r | 1 | **BUY** | Dyneema SK75 | spliced | 5 EST | $1.88 | $1.88 | [link](https://www.fisheriessupply.com/samson-rope-blue-amsteel-blue/872007006030) |
| Ankle straps, heel-counter strap, fasteners |  | 2 | **BUY** | nylon webbing | sewn | 40 EST | $12.00 EST | $24.00 | EST |
| **Subtotal** | | | | | | **0.53 kg** | | **$252** | |

### Shoulder (M5): 0.64 kg, $188

| Part (plain name) | Technical / CAD | Qty | Make | Material | Process | Mass ea (g) | Unit | Line | Source |
|---|---|---|---|---|---|---|---|---|---|
| Shoulder spring cassette housing | m5_cassette_l/r | 2 | **PRINT** | PAHT-CF (or PA12-CF) | print set B (bracket) | 41 EST | $4.43 | $8.86 | filament: [link](https://www.gigaparts.com/bambu-lab-paht-cf-black-carbon-fiber-reinforced-paht-3d-printer-filament-1-75mm-1kg-spool.html) |
| Cassette spring set (Paexo-style arm support) | springs + cam + bearings inside m5_cassette | 2 | **BUY** | spring steel | off-the-shelf compression or torsion springs, tuned per wearer | 150 EST | $45.00 EST | $90.00 | EST |
| Arm lever | m5_lever_l/r, 12 x 6 mm | 2 | **METAL** | 7075-T6 aluminium | laser-cut 7075 strip with a bearing at the pivot; must be metal: arm support torque at the pivot | 45 EST | $30.00 EST | $60.00 | EST: one-off job-shop price, get 3 quotes |
| Arm cuff | m5_armcuff_l/r | 2 | **PRINT** | PAHT-CF (or PA12-CF) | print set A (shell) | 37 EST | $4.01 | $8.02 | filament: [link](https://www.gigaparts.com/bambu-lab-paht-cf-black-carbon-fiber-reinforced-paht-3d-printer-filament-1-75mm-1kg-spool.html) |
| Arm cuff pad | m5_armliner_l/r | 2 | **PRINT** | TPU 95A HF | print set C (lattice pad) | 16 EST | $0.73 | $1.46 | filament: [link](https://3dprintingusa.com/collections/bambu-lab-tpu) |
| Arm straps and fasteners |  | 2 | **BUY** | nylon webbing | sewn | 30 EST | $10.00 EST | $20.00 | EST |
| **Subtotal** | | | | | | **0.64 kg** | | **$188** | |
