nicedreamzapp/sitka/parts.csv

module | tier | name | technical | qty | make | material | process | mass_each_g | mass_line_g | mass_est | unit_usd | line_usd | cost_est | source | cad
Dock (hub) | Basic | Back panel (carries the straps, ports and later the motor) | back_panel, 600 cm2 contoured plate | 1 | PRINT | PAHT-CF (or PA12-CF) | PAHT-CF, 0.4 hardened nozzle, 0.2 mm layers, wall printed solid (6 to 8 perimeters), dried 80 C 8 h; 279 x 277 mm: print as two halves with a bolted lap joint on a 256 mm bed, one piece on an H2D | 249.6 | 249.6 | EST | 27.27 | 27.27 |  | filament: https://www.gigaparts.com/bambu-lab-paht-cf-black-carbon-fiber-reinforced-paht-3d-printer-filament-1-75mm-1kg-spool.html | back_panel
Dock (hub) | Basic | Back panel pad | back_panel_liner, spacer mesh + 6 mm lattice | 1 | PRINT | TPU 95A HF | TPU 95A HF, 0.2 mm, graded gyroid (about 12% at the skin to 25% at the shell), no supports; spacer mesh or gel glued on; split like the panel | 99.1 | 99.1 | EST | 4.44 | 4.44 |  | filament: https://3dprintingusa.com/collections/bambu-lab-tpu | back_panel_liner
Dock (hub) | Basic | Lumbar plate (stiffens the belt at the spine) | lumbar_plate | 1 | PRINT | PAHT-CF (or PA12-CF) | PAHT-CF, 0.4 hardened nozzle, 0.2 mm layers, wall printed solid (6 to 8 perimeters), dried 80 C 8 h | 45.7 | 45.7 | EST | 4.99 | 4.99 |  | filament: https://www.gigaparts.com/bambu-lab-paht-cf-black-carbon-fiber-reinforced-paht-3d-printer-filament-1-75mm-1kg-spool.html | lumbar_plate
Dock (hub) | Basic | Seat cup under each sit bone (242 cm2 seated footprint) | seat_cup_l/r, 16 x 19 cm seated, takes 614 N | 2 | PRINT | PAHT-CF (or PA12-CF) | PAHT-CF, 0.4 hardened nozzle, 0.2 mm layers, wall printed solid (6 to 8 perimeters), dried 80 C 8 h; bench-proof at 1.5 x 614 N before wearing; v2 = carbon layup using the print as the plug | 99.6 | 199.3 | EST | 10.88 | 21.77 |  | filament: https://www.gigaparts.com/bambu-lab-paht-cf-black-carbon-fiber-reinforced-paht-3d-printer-filament-1-75mm-1kg-spool.html | seat_cup
Dock (hub) | Basic | Seat cup cushion (gel + lattice; 25 kPa average, needs an air-cell insert under the sit bone) | seat_cup_liner_l/r, 15 mm graded lattice under a 3 mm gel sheet | 2 | PRINT | TPU 95A HF | TPU 95A HF, 0.2 mm, graded gyroid (about 12% at the skin to 25% at the shell), no supports; spacer mesh or gel glued on; air-cell insert under the sit bone to be proven on a pressure map (SEAT_SITBONE.md) | 100.3 | 200.6 | EST | 4.5 | 9.0 |  | filament: https://3dprintingusa.com/collections/bambu-lab-tpu | seat_cup_liner
Dock (hub) | Basic | Belt side clips | belt_sideclip_l/r | 2 | PRINT | PAHT-CF (or PA12-CF) | PAHT-CF, 0.4 hardened nozzle, 0.2 mm, 5 walls, 40% gyroid, layers laid across the load, heat-set inserts | 4.6 | 9.1 | EST | 0.5 | 1.0 |  | filament: https://www.gigaparts.com/bambu-lab-paht-cf-black-carbon-fiber-reinforced-paht-3d-printer-filament-1-75mm-1kg-spool.html | belt_sideclip
Dock (hub) | Basic | Cable ports, ball-end into keyhole (6 per Dock) | port_knee/hip/shoulder_l/r, quick-release terminal, 3.6 kN proof | 6 | METAL | 17-4PH H900 stainless | waterjet or wire-EDM keyhole plate, then pocket; must be metal: carries the full tendon proof load of 3.6 kN | 7.7 | 46.3 | EST | 18 | 108 | EST | EST: one-off job-shop price, get 3 quotes | port_knee
Dock (hub) | Basic | Hip belt, padded (backpack replacement belt) | hip_belt, 300 cm2 contact, < 10 kPa | 1 | BUY | nylon + EVA foam | off the shelf, e.g. a Granite Gear or Osprey replacement hip belt; add the side clips | 300 | 300 | EST | 60 | 60 | EST | EST: backpack replacement belts sell for about $40 to $80
Dock (hub) | Basic | Belt buckle, aluminium cobra type | belt_buckle, 38 mm | 1 | BUY | aluminium | off the shelf (AustriAlpin Cobra style) | 55 | 55 | EST | 30 | 30 | EST | EST: cobra buckles sell for about $25 to $35
Dock (hub) | Basic | Shoulder harness with sternum strap | harness_l/r + sternum_strap, 7 cm wide, 17 kPa at lift peak | 1 | BUY | nylon + spacer mesh | off the shelf backpack harness, sewn to the panel | 250 | 250 | EST | 40 | 40 | EST | EST: replacement backpack harness
Dock (hub) | Basic | Webbing: Crazy Creek straps | crazycreek_l/r (94 N at 10 deg); 25 mm polyester, low stretch | 1 | BUY | polyester webbing | about 3 m, cut, heat-sealed, bar-tacked | 80 | 80 | EST | 20 | 20 | EST | EST: polyester webbing about $1.5 to $3 per yard
Dock (hub) | Basic | Spine link pair, panel to belt (replaces the panel straps) | spine_link_l/r: 25 mm between centres, 11 mm carbon tube, M6 ball joint each end; 300 N per link passive lift, 770 N at the P1 peak | 2 | BUY | carbon tube + steel ball joints | tube bonded into two M6 ball joints (angle joints, DIN 71802 style) | 40 | 80 | EST | 14 | 28 | EST | EST: M6 ball joints about $4 to $8 each; rating VERIFY (typically several kN) | spine_link
Dock (hub) | Basic | Spine link pivot brackets (panel and belt) | spine_pivot_panel_l/r + spine_pivot_belt_l/r, M6 pin each | 4 | METAL | 7075-T6 aluminium | CNC 7075 or a bought aluminium clevis bracket; must be metal: up to 770 N per link at the P1 lift peak | 9.2 | 36.9 | EST | 15 | 60 | EST | EST: one-off job-shop price, get 3 quotes | spine_pivot_panel
Dock (hub) | Basic | Seat-cup lacing kit: grommets, cord, webbing tab | cup_eyelets/cuff_eyelets/shell_eyelets (9 grommets per side), cup_lacing (3 mm cord), cup_bridge (18 mm tab) | 2 | BUY | brass grommets + polyester cord + webbing | set 9 mm grommets in the printed cup, cuff and shell; zigzag lace the cup to the cuff, bar-tack the tab | 30 | 60 | EST | 9 | 18 | EST | EST: grommet kit about $10, 3 mm cord about $0.30 per ft; 41 N per cord run at stand-up drag (SEAT_SITBONE.md) | cup_eyelets, cuff_eyelets, shell_eyelets, cup_lacing, cup_bridge
Dock (hub) | Basic | Cam buckles and ladder locks for the Dock straps | 8 pieces | 8 | BUY | aluminium / acetal | off the shelf | 12 | 96 | EST | 3.5 | 28.0 | EST | EST
Dock (hub) | Basic | D-rings for the Crazy Creek strap at the thigh | dring_cc_l/r | 2 | BUY | aluminium | off the shelf, 25 mm | 6 | 12 | EST | 1.5 | 3.0 | EST | EST
Dock (hub) | Basic | Silicone gel sheet, 3 mm, fabric backed (seat cups) | skin layer of the seat-cup stack | 1 | BUY | silicone gel | Silipos Soft Sheer type sheet, cut to the cup outline | 120 | 120 | EST | 60 | 60 | EST | EST (no public price): https://ortoped.ca/Silipos-Soft-Sheer-Sheeting/family-844
Dock (hub) | Basic | 3D spacer mesh, 3 to 4 mm (all pad covers) | breathable skin layer for every pad | 1 | BUY | polyester spacer fabric | about 2 yd, sewn into washable covers | 150 | 150 | EST | 16 | 16 | EST | EST: about $5 to $8 per yd (eBay spacer-mesh listings)
Dock (hub) | Basic | Fasteners, heat-set inserts, thread-locker (Dock) | M4/M5 stainless, brass inserts | 1 | BUY | stainless / brass | kit | 60 | 60 | EST | 15 | 15 | EST | EST
Knee + Seat (M1) | Basic | Thigh shell, laced | thigh_shell_l/r, contoured from a 3D scan | 2 | PRINT | PAHT-CF (or PA12-CF) | PAHT-CF, 0.4 hardened nozzle, 0.2 mm layers, wall printed solid (6 to 8 perimeters), dried 80 C 8 h; 289 mm long: split above the knee on a 256 mm bed, one piece on an H2D; v2 = carbon layup on the print as a plug | 312.9 | 625.7 | EST | 34.18 | 68.35 |  | filament: https://www.gigaparts.com/bambu-lab-paht-cf-black-carbon-fiber-reinforced-paht-3d-printer-filament-1-75mm-1kg-spool.html | thigh_shell
Knee + Seat (M1) | Basic | Thigh pad | thigh_liner_l/r, spacer mesh + 10 mm lattice | 2 | PRINT | TPU 95A HF | TPU 95A HF, 0.2 mm, graded gyroid (about 12% at the skin to 25% at the shell), no supports; spacer mesh or gel glued on; split like the shell | 166.0 | 332.0 | EST | 7.45 | 14.89 |  | filament: https://3dprintingusa.com/collections/bambu-lab-tpu | thigh_liner
Knee + Seat (M1) | Basic | Below-kneecap pad shell (PTB, 100 cm2) | ptb_shell_l/r, patellar-tendon-bearing pad | 2 | PRINT | PAHT-CF (or PA12-CF) | PAHT-CF, 0.4 hardened nozzle, 0.2 mm layers, wall printed solid (6 to 8 perimeters), dried 80 C 8 h | 72.8 | 145.6 | EST | 7.95 | 15.9 |  | filament: https://www.gigaparts.com/bambu-lab-paht-cf-black-carbon-fiber-reinforced-paht-3d-printer-filament-1-75mm-1kg-spool.html | ptb_shell
Knee + Seat (M1) | Basic | Calf pad shell (120 cm2) | calf_cuff_l/r | 2 | PRINT | PAHT-CF (or PA12-CF) | PAHT-CF, 0.4 hardened nozzle, 0.2 mm layers, wall printed solid (6 to 8 perimeters), dried 80 C 8 h | 77.3 | 154.6 | EST | 8.45 | 16.89 |  | filament: https://www.gigaparts.com/bambu-lab-paht-cf-black-carbon-fiber-reinforced-paht-3d-printer-filament-1-75mm-1kg-spool.html | calf_cuff
Knee + Seat (M1) | Basic | Shin pad (gel + lattice) | shin_liner_l/r, 12 mm lattice under 3 mm gel | 2 | PRINT | TPU 95A HF | TPU 95A HF, 0.2 mm, graded gyroid (about 12% at the skin to 25% at the shell), no supports; spacer mesh or gel glued on | 38.9 | 77.8 | EST | 1.74 | 3.49 |  | filament: https://3dprintingusa.com/collections/bambu-lab-tpu | shin_liner
Knee + Seat (M1) | Basic | Calf pad lattice | calf_liner_l/r | 2 | PRINT | TPU 95A HF | TPU 95A HF, 0.2 mm, graded gyroid (about 12% at the skin to 25% at the shell), no supports; spacer mesh or gel glued on | 42.0 | 84.0 | EST | 1.88 | 3.77 |  | filament: https://3dprintingusa.com/collections/bambu-lab-tpu | calf_liner
Knee + Seat (M1) | Basic | Knee side pads | condyle_pad_lat/med_l/r | 4 | PRINT | TPU 95A HF | TPU 95A HF, 0.2 mm, graded gyroid (about 12% at the skin to 25% at the shell), no supports; spacer mesh or gel glued on | 6.4 | 25.7 | EST | 0.29 | 1.15 |  | filament: https://3dprintingusa.com/collections/bambu-lab-tpu | condyle_pad_lat
Knee + Seat (M1) | Basic | Hinge arms, thigh side | thigh_arm_lat/med_l/r, 24 x 4.8 mm strip | 4 | METAL | 7075-T6 aluminium | laser cut flat from 0.190 in 7075-T6 (SendCutSend lists it), the CAD joggle taken up by a printed spacer at the shell; must be metal: carries the knee couple, 34 Nm sitting and up to 190 Nm if the strut is lost (205 MPa, SF 2.5) | 60.8 | 243.4 | EST | 22 | 88 | EST | EST: one-off job-shop price, get 3 quotes | thigh_arm_lat
Knee + Seat (M1) | Basic | Hinge arms, shin side | shin_arm_lat/med_l/r, 24 x 4.8 mm strip | 4 | METAL | 7075-T6 aluminium | laser cut flat from 0.190 in 7075-T6, same as the thigh arms; must be metal: same couple as the thigh arms | 95.1 | 380.3 | EST | 26 | 104 | EST | EST: one-off job-shop price, get 3 quotes | shin_arm_lat
Knee + Seat (M1) | Basic | Geared bicentric knee hinge (hub pair per knee) | knee_hub_lat/med_l/r, two geared plates + cover | 4 | METAL | 7075-T6 aluminium | CNC 7075, gear segments milled or wire-EDM; must be metal: carries the arc reaction of 602 N sitting and about 3.4 kN in a strut-lost catch | 23.2 | 92.9 | EST | 70 | 280 | EST | EST: one-off job-shop price, get 3 quotes | knee_hub_lat
Knee + Seat (M1) | Basic | 80 mm grooved arc (artificial kneecap) with its yoke | knee_arc_l/r + knee_yoke_l/r, r = 80 mm, 93 deg sector | 2 | METAL | 7075-T6 aluminium | CNC 7075 as one piece, groove polished for the line; must be metal: sees sqrt2 x T = 602 N sitting, 3.4 kN catch; a groove in plastic would creep and cut | 78.1 | 156.2 | EST | 160 | 320 | EST | EST: one-off job-shop price, get 3 quotes | knee_arc + knee_yoke
Knee + Seat (M1) | Basic | Cam clutch housing + mode lever mount | knee_manifold_l/r, WALK / SIT-LIFT / FREE | 2 | PRINT | PAHT-CF (or PA12-CF) | PAHT-CF, 0.4 hardened nozzle, 0.2 mm, 5 walls, 40% gyroid, layers laid across the load, heat-set inserts; the housing only positions the clutch; the load path is the metal spool, shaft and pins | 49.4 | 98.7 | EST | 5.39 | 10.78 |  | filament: https://www.gigaparts.com/bambu-lab-paht-cf-black-carbon-fiber-reinforced-paht-3d-printer-filament-1-75mm-1kg-spool.html | knee_manifold
Knee + Seat (M1) | Basic | One-way sprag clutch (the power-off seat lock) | CSK20-PP, 20 x 47 x 14 mm, 50 Nm rated | 2 | BUY | bearing steel | off the shelf, pressed into a 7075 spool of 14 mm radius: 50 Nm = 3.57 kN line pull, right at the 3.6 kN proof, so proof-test or step up to CSK25 | 110 | 220 | EST | 150 | 300 |  | https://uk.rs-online.com/web/p/sprag-clutch-bearings/1465256
Knee + Seat (M1) | Basic | Clutch spool, shaft and release dog | inside knee_manifold: spool r = 14 mm, the mode lever frees or grounds the outer race | 2 | METAL | 7075-T6 aluminium | CNC 7075 spool, 17-4PH shaft and dog; must be metal: the tendon load passes straight through it | 60 | 120 | EST | 70 | 140 | EST | EST: one-off job-shop price, get 3 quotes | (inside knee_manifold)
Knee + Seat (M1) | Basic | Mode lever | mode_lever_l/r | 2 | PRINT | PAHT-CF (or PA12-CF) | PAHT-CF, 0.4 hardened nozzle, 0.2 mm, 5 walls, 40% gyroid, layers laid across the load, heat-set inserts | 1.6 | 3.2 | EST | 0.18 | 0.35 |  | filament: https://www.gigaparts.com/bambu-lab-paht-cf-black-carbon-fiber-reinforced-paht-3d-printer-filament-1-75mm-1kg-spool.html | mode_lever
Knee + Seat (M1) | Basic | Tendon fairlead | tendon_fairlead_l/r, turns T1 onto the arc | 2 | METAL | 7075-T6 aluminium | CNC 7075 with a polished radius (or a printed body with a stainless sheave); metal preferred: 426 N line turning on it | 18.9 | 37.8 | EST | 35 | 70 | EST | EST: one-off job-shop price, get 3 quotes | tendon_fairlead
Knee + Seat (M1) | Basic | Sit leaf spring (350 N near-constant, 44 J) | sit_leaf_l/r, tapered glass leaf, 126 mm stroke | 2 | BUY | unidirectional E-glass laminate (bow-limb glass) | laminate 5 to 6 strips of 0.030 in bow glass with epoxy, taper-ground, bench-tested to 10^5 cycles | 33.8 | 67.6 | EST | 15 | 30 | EST | glass strips: https://bigjimsbowcompany.com/?p=8861 ($13 to $15 per 72 in strip); leaf price EST | sit_leaf
Knee + Seat (M1) | Basic | Leaf root clamp with preload knob (250 to 400 N) | sit_leaf_root_l/r | 2 | METAL | 7075-T6 aluminium | CNC 7075; must be metal: the leaf's root bending moment and the preload screw | 26.7 | 53.5 | EST | 40 | 80 | EST | EST: one-off job-shop price, get 3 quotes | sit_leaf_root
Knee + Seat (M1) | Basic | Telescoping carbon strut, 5 sections, one-way lock, rubber foot | strut_tube0..4 24/21/18/15/12 x 1.2 mm, 0.28 m stowed to 0.87 m; 483 N, buckles at 2.8 kN at 0.65 m | 2 | BUY | roll-wrapped 3K carbon tube | five tubes cut to 0.20 m, bushed, four twist-lock collars, pivoting rubber cane tip; stowed short so it clears the calf in a running swing | 290 | 580 | EST | 95 | 190 | EST | tubes about $10 to $20 each (https://aws.robu.in/?p=894416 lists 24 x 22 x 1000 mm); cane tip $18.95 (legacy list); locks EST | strut_tube0-4, strut_collar0-3, strut_foot
Knee + Seat (M1) | Basic | Strut hinge under the sit bone: fork, 8 mm pin, cone spacers | strut_fork_l/r + strut_hingepin_l/r; fold about the pin, 9 deg splay in the rod end | 2 | METAL | 7075-T6 aluminium | CNC 7075 fork on the cup, 17-4PH pin; must be metal: the strut's 483 N push goes through it into the sit bone | 48.1 | 96.2 | EST | 60 | 120 | EST | EST: one-off job-shop price, get 3 quotes | strut_fork + strut_hingepin
Knee + Seat (M1) | Basic | High-misalignment rod end on the strut top | strut_rodend_l/r, 8 mm bore, +-16 deg (the gate checks the swing stays inside it) | 2 | BUY | steel / PTFE liner | threaded into the top tube's bonded insert | 35 | 70 | EST | 25 | 50 | EST | EST: high-misalignment rod ends about $15 to $35 (VERIFY angle and load) | strut_rodend
Knee + Seat (M1) | Basic | Strut stow clips, top (on the cup) and bottom (on the cuff) | strut_clip_hi_l/r + strut_clip_l/r, C-saddles | 4 | PRINT | PAHT-CF (or PA12-CF) | PAHT-CF, 0.4 hardened nozzle, 0.2 mm, 5 walls, 40% gyroid, layers laid across the load, heat-set inserts | 2.9 | 11.6 | EST | 0.32 | 1.27 |  | filament: https://www.gigaparts.com/bambu-lab-paht-cf-black-carbon-fiber-reinforced-paht-3d-printer-filament-1-75mm-1kg-spool.html | strut_clip
Knee + Seat (M1) | Basic | Knee seat tendon T1 + backup strap line | t1_tendon_l/r: 1/8 in (3.2 mm) 12-strand Dyneema; production: Vectran or SK99 (low creep) | 1 | BUY | Dyneema SK75 (bench) / Vectran | spliced eyes; about 25 ft covers T1, the backup lines and practice splices | 15 | 15 | EST | 11.75 | 11.75 |  | https://www.fisheriessupply.com/samson-rope-blue-amsteel-blue/872007006030 ($0.47/ft, 1/8 in) | t1_tendon
Knee + Seat (M1) | Basic | Backup strap cleat (catches if the clutch slips) | own cleat, set 3 mm slacker than T1, nylon line for a soft catch | 2 | BUY | aluminium + composite | Harken 150 Cam-Matic on 6 mm nylon double braid; VERIFY its working load against the 1.2 kN catch | 30 | 60 | EST | 44.95 | 89.9 |  | https://defender.com/en_us/harken-150-standard-cam-matic-cleat
Knee + Seat (M1) | Basic | Tendon anchor below the kneecap | shin_anchor_l/r, 3.6 kN proof | 2 | BUY | 316 stainless | off the shelf stainless pad eye, through-bolted with a backing plate | 12 | 24 | EST | 12 | 24 | EST | EST: small marine pad eyes $8 to $15 | shin_anchor
Knee + Seat (M1) | Basic | Thigh and shin straps + buckles | thigh_strap0/1, shin_strap0/1, thigh_buckle0/1 (L and R) | 2 | BUY | nylon webbing + aluminium cam buckles | 38 mm webbing, cut and bar-tacked; lacing for the shells | 90 | 180 | EST | 25 | 50 | EST | EST
Knee + Seat (M1) | Basic | Silicone gel sheet, 3 mm (below-kneecap pads) | skin layer on the shear-loaded pads | 1 | BUY | silicone gel | cut to the PTB pad outline | 60 | 60 | EST | 60 | 60 | EST | EST (no public price): https://ortoped.ca/Silipos-Soft-Sheer-Sheeting/family-844
Knee + Seat (M1) | Basic | Fasteners, inserts, bushings (knee) | M4/M5 12.9 and stainless, oilite bushings | 1 | BUY | steel / bronze | kit | 80 | 80 | EST | 25 | 25 | EST | EST
Back / Lift (M2) | Basic | Lift leaf spring (3.1 N/mm, slack below 35 deg) | m2_leaf, tapered glass leaf at the panel | 1 | BUY | unidirectional E-glass laminate | laminated like the sit leaf; 300 N per side at a 90 deg stoop | 33.9 | 33.9 | EST | 15 | 15 | EST | glass strips: https://bigjimsbowcompany.com/?p=8861; leaf price EST | m2_leaf
Back / Lift (M2) | Basic | Lift leaf root clamp + ON/OFF switch | m2_leaf_root; OFF when sitting | 1 | METAL | 7075-T6 aluminium | CNC 7075; must be metal: leaf root bending, 600 N total line pull | 31.0 | 31.0 | EST | 45 | 45 | EST | EST: one-off job-shop price, get 3 quotes | m2_leaf_root
Back / Lift (M2) | Basic | Whiffletree (floating pulley, equal left/right share) | whiffletree | 1 | BUY | aluminium + stainless | small sailing block, about 20 mm sheave | 25 | 25 | EST | 25 | 25 | EST | EST: micro blocks $15 to $35 | whiffletree
Back / Lift (M2) | Basic | Lumbar standoff | lumbar_standoff_l/r | 2 | PRINT | PAHT-CF (or PA12-CF) | PAHT-CF, 0.4 hardened nozzle, 0.2 mm, 5 walls, 40% gyroid, layers laid across the load, heat-set inserts; line runs over a 6 mm stainless pin pressed in, not over the plastic | 10.7 | 21.3 | EST | 1.16 | 2.33 |  | filament: https://www.gigaparts.com/bambu-lab-paht-cf-black-carbon-fiber-reinforced-paht-3d-printer-filament-1-75mm-1kg-spool.html | lumbar_standoff
Back / Lift (M2) | Basic | Glute guide (100 mm lever) | glute_guide_l/r, takes the lift tendon wrap | 2 | PRINT | PAHT-CF (or PA12-CF) | PAHT-CF, 0.4 hardened nozzle, 0.2 mm, 5 walls, 40% gyroid, layers laid across the load, heat-set inserts; stainless pin insert; bench-proof at 1.2 kN (the P1 peak is 800 N per side): VERIFY, CNC 7075 if it creeps | 10.7 | 21.5 | EST | 1.17 | 2.35 |  | filament: https://www.gigaparts.com/bambu-lab-paht-cf-black-carbon-fiber-reinforced-paht-3d-printer-filament-1-75mm-1kg-spool.html | glute_guide
Back / Lift (M2) | Basic | Panel line guides | panel_guide_l/r | 2 | PRINT | PAHT-CF (or PA12-CF) | PAHT-CF, 0.4 hardened nozzle, 0.2 mm, 5 walls, 40% gyroid, layers laid across the load, heat-set inserts | 3.9 | 7.9 | EST | 0.43 | 0.86 |  | filament: https://www.gigaparts.com/bambu-lab-paht-cf-black-carbon-fiber-reinforced-paht-3d-printer-filament-1-75mm-1kg-spool.html | panel_guide
Back / Lift (M2) | Basic | Posterior thigh cuff (lift anchor, 200 cm2) | thigh_cuff_l/r | 2 | PRINT | PAHT-CF (or PA12-CF) | PAHT-CF, 0.4 hardened nozzle, 0.2 mm layers, wall printed solid (6 to 8 perimeters), dried 80 C 8 h | 68.8 | 137.7 | EST | 7.52 | 15.04 |  | filament: https://www.gigaparts.com/bambu-lab-paht-cf-black-carbon-fiber-reinforced-paht-3d-printer-filament-1-75mm-1kg-spool.html | thigh_cuff
Back / Lift (M2) | Basic | Thigh cuff pad | thigh_cuff_liner_l/r, gel + 12 mm lattice | 2 | PRINT | TPU 95A HF | TPU 95A HF, 0.2 mm, graded gyroid (about 12% at the skin to 25% at the shell), no supports; spacer mesh or gel glued on | 46.8 | 93.6 | EST | 2.1 | 4.2 |  | filament: https://3dprintingusa.com/collections/bambu-lab-tpu | thigh_cuff_liner
Back / Lift (M2) | Basic | Lift tendon T3 line | t3_tendon_l/r, 1/8 in Dyneema, about 1 m each | 1 | BUY | Dyneema SK75 | spliced eyes | 10 | 10 | EST | 3.76 | 3.76 |  | https://www.fisheriessupply.com/samson-rope-blue-amsteel-blue/872007006030 | t3_tendon
Back / Lift (M2) | Basic | Stainless roller pins and D-rings | 6 mm pins for the standoffs, dring_t3_l/r | 1 | BUY | 316 stainless / aluminium | off the shelf | 30 | 30 | EST | 12 | 12 | EST | EST
Hip (M3) | Basic | Hip-flexor standoff (60 mm lever) | m3_standoff_l/r | 2 | PRINT | PAHT-CF (or PA12-CF) | PAHT-CF, 0.4 hardened nozzle, 0.2 mm, 5 walls, 40% gyroid, layers laid across the load, heat-set inserts; stainless pin insert | 11.2 | 22.3 | EST | 1.22 | 2.44 |  | filament: https://www.gigaparts.com/bambu-lab-paht-cf-black-carbon-fiber-reinforced-paht-3d-printer-filament-1-75mm-1kg-spool.html | m3_standoff
Hip (M3) | Basic | Hip-flexor spring element (14 N/mm, 300 N at 20 deg) | m3_band_l/r: webbing in series with a steel extension spring | 2 | BUY | music-wire spring + polyester webbing | a 14 N/mm, 30 mm-travel extension spring sewn into a 20 mm webbing band; latex is far too soft for this rate | 60 | 120 | EST | 15 | 30 | EST | EST: industrial extension springs $5 to $12 | m3_band
Hip (M3) | Basic | D-rings and slides for the hip bands | dring_m3_l/r | 1 | BUY | aluminium | off the shelf | 15 | 15 | EST | 6 | 6 | EST | EST
Couplings (bands) | Basic | Running band (shoe to shoe or shin to shin, RUN only) | running_band, latex tube about 0.25 m, Simpson 2019 exotendon | 1 | BUY | latex tubing | cut to length, knotted or crimped to the clips; tune stiffness on the treadmill | 50 | 50 | EST | 21 | 21 |  | https://www.walmart.com/ip/20969124 (TheraBand heavy tubing, 25 ft, about $21) | running_band
Couplings (bands) | Basic | Running band clips | runband_clip_l/r | 2 | PRINT | PAHT-CF (or PA12-CF) | PAHT-CF, 0.4 hardened nozzle, 0.2 mm, 5 walls, 40% gyroid, layers laid across the load, heat-set inserts | 0.5 | 1.1 | EST | 0.06 | 0.12 |  | filament: https://www.gigaparts.com/bambu-lab-paht-cf-black-carbon-fiber-reinforced-paht-3d-printer-filament-1-75mm-1kg-spool.html | runband_clip
Couplings (bands) | Full body | Hamstring band (hip + knee coupling, 3 N/mm) | hamstring_band_l/r, 126 N at 42 mm, OFF in SIT | 2 | BUY | latex (speargun-type rubber) + webbing | cut to length and tuned; a TheraBand strand is about 50 times too soft | 40 | 80 | EST | 12 | 24 | EST | EST: speargun rubber about $3 to $5 per ft | hamstring_band
Couplings (bands) | Full body | Band guide 40 mm behind the knee axis | knee_guide_l/r, with a 623 bearing pulley | 2 | PRINT | PAHT-CF (or PA12-CF) | PAHT-CF, 0.4 hardened nozzle, 0.2 mm, 5 walls, 40% gyroid, layers laid across the load, heat-set inserts | 1.9 | 3.9 | EST | 0.21 | 0.42 |  | filament: https://www.gigaparts.com/bambu-lab-paht-cf-black-carbon-fiber-reinforced-paht-3d-printer-filament-1-75mm-1kg-spool.html | knee_guide
Couplings (bands) | Full body | Coupling D-rings | dring_ham_l/r, dring_ham_calf_l/r | 4 | BUY | aluminium | off the shelf | 3 | 12 | EST | 1.5 | 6.0 | EST | EST
Couplings (bands) | Full body | Calf band line (knee + ankle, needs M4) | calf_band_l/r, from a D-ring on the thigh cuff (dring_calf_l/r) | 1 | BUY | Dyneema SK75 | spliced | 5 | 5 | EST | 2.82 | 2.82 |  | https://www.fisheriessupply.com/samson-rope-blue-amsteel-blue/872007006030 | calf_band
Couplings (bands) | Full body | Calf band D-rings on the thigh cuff | dring_calf_l/r | 2 | BUY | aluminium | off the shelf, riveted to the cuff | 6 | 12 | EST | 1.5 | 3.0 | EST | EST | dring_calf
Smart-clutch upgrade | Smart | Electroadhesive stance clutch (fails open) | ea_clutch_l/r, about 8 electrode pairs for 375 N at SF 2, 26 g element | 2 | BUY | PET film electrodes, dielectric film | built from film to the Diller/Collins ICRA 2016 recipe; bench-test wet and dry at 375 N | 30 | 60 | EST | 100 | 200 | EST | EST: KINETICS.md target of about $200 a pair | ea_clutch
Smart-clutch upgrade | Smart | Stance leaf (15.6 N/mm, 330 N breakaway stop) | T1b branch | 2 | BUY | glass laminate | laminated like the sit leaf | 25 | 50 | EST | 15 | 30 | EST | EST
Smart-clutch upgrade | Smart | High-voltage driver for the EA clutches | about 300 V, mW level | 1 | BUY | electronics | small HV DC-DC module + switching | 30 | 30 | EST | 90 | 90 | EST | EST
Smart-clutch upgrade | Smart | Microcontroller, Teensy 4.1 | 600 MHz, native CAN | 1 | BUY | electronics | off the shelf | 10 | 10 |  | 31.5 | 31.5 |  | https://www.sparkfun.com/teensy-4-1.html (legacy list price)
Smart-clutch upgrade | Smart | Shank IMU, Adafruit BNO085 | gait phase | 2 | BUY | electronics | off the shelf | 5 | 10 |  | 29.5 | 59.0 |  | https://www.adafruit.com/product/4754 (legacy list price)
Smart-clutch upgrade | Smart | Insole pressure sensors, Interlink FSR 402 | 4 per foot | 8 | BUY | electronics | taped into a thin insole | 2 | 16 |  | 2.99 | 23.92 |  | https://www.interlinkelectronics.com/products/fsr-model-402 (legacy list price)
Smart-clutch upgrade | Smart | Tendon load cell + HX711 | reads T1 tension, coaches the recline (warns at about 500 N) | 2 | BUY | electronics | inline mini load cell | 25 | 50 | EST | 35 | 70 | EST | EST
Smart-clutch upgrade | Smart | Small battery, 1 cell 21700 (16 Wh) + charger board | Molicel P45B | 1 | BUY | Li-ion | with a protection/charge board | 90 | 90 | EST | 20.75 | 20.75 | EST | https://www.batteryjunction.com/molicel-inr21700-p45b ($8.75) + board EST
Smart-clutch upgrade | Smart | Wiring, connectors, haptic buzzers | JST-GH, braided sleeve, 2 haptic discs | 1 | BUY | electronics | kit | 60 | 60 | EST | 40 | 40 | EST | EST
Smart-clutch upgrade | Smart | Controller enclosure | on the back panel, about 60 g | 1 | PRINT | PETG | PETG, 0.2 mm, 3 walls, 20% infill | 60 | 60 | EST | 1.38 | 1.38 | EST | filament: EST (Bambu PETG HF, about $20/kg)
One-motor power (P1) | Power (P1) | Motor, CubeMars AK10-9 V3 (one, on the back) | p1_motor, 9:1 QDD, 18 Nm rated, CAN | 1 | BUY | actuator | off the shelf | 960 | 960 | EST | 698.9 | 698.9 |  | https://aifitlab.com/collections/cubemars-motor/products/cubemars-ak10-9-v3-0-motor ($698.90, motor; $935 with driver at OpenELAB) | p1_motor
One-motor power (P1) | Power (P1) | Hub drum, 25 mm spool | p1_drum | 1 | METAL | 7075-T6 aluminium | CNC 7075; must be metal: 720 N line pull at rated torque | 70.6 | 70.6 | EST | 120 | 120 | EST | EST: one-off job-shop price, get 3 quotes | p1_drum
One-motor power (P1) | Power (P1) | Dog clutches pick left, right or both (solenoid + steel dogs) | p1_dogclutch_l/r | 2 | BUY | 17-4PH dogs + bistable solenoid | CNC dogs (EST $60) + Intertec ITS-LX-2218 latching solenoid (about $54) | 80 | 160 | EST | 114 | 228 | EST | solenoid: https://rapidonline.com/intertec-its-lx-2218-12vdc-10mm-4n-de-energised-20n-bi-directional-solenoid-50-2909; dogs EST | p1_dogclutch
One-motor power (P1) | Power (P1) | Bowden end stop on the clutch housing | bowden_stop_l/r, the housing ferrule seats in it | 2 | PRINT | PAHT-CF (or PA12-CF) | PAHT-CF, 0.4 hardened nozzle, 0.2 mm, 5 walls, 40% gyroid, layers laid across the load, heat-set inserts; brass ferrule cup pressed in | 1.0 | 2.0 | EST | 0.11 | 0.22 |  | filament: https://www.gigaparts.com/bambu-lab-paht-cf-black-carbon-fiber-reinforced-paht-3d-printer-filament-1-75mm-1kg-spool.html | bowden_stop
One-motor power (P1) | Power (P1) | Bowden cables, hub to knee manifold | bowden_l/r, efficiency 0.68 to 0.79, 551 N motor side | 2 | BUY | PTFE-lined housing + 7x19 stainless inner | motorcycle-clutch style housing, swaged ends | 80 | 160 | EST | 30 | 60 | EST | EST | bowden
One-motor power (P1) | Power (P1) | Battery, 97 Wh (under the FAA 100 Wh line), 6S1P Molicel P45B | p1_battery | 6 | BUY | Li-ion 21700 cell | spot-welded pack | 70 | 420 |  | 8.75 | 52.5 |  | https://www.batteryjunction.com/molicel-inr21700-p45b ($8.75 each) | p1_battery
One-motor power (P1) | Power (P1) | 6S BMS, nickel strip, pack case, fuse | for the 97 Wh pack | 1 | BUY | electronics | kit + printed case | 100 | 100 | EST | 25 | 25 | EST | EST
One-motor power (P1) | Power (P1) | 6S balance charger | one-time | 1 | BUY | electronics | off the shelf | 0 | 0 | EST | 45 | 45 | EST | EST (legacy list)
One-motor power (P1) | Power (P1) | CAN transceiver + power wiring + E-stop | SN65HVD230, XT30, big red stop on the belt | 1 | BUY | electronics | kit | 120 | 120 | EST | 45 | 45 | EST | EST
Ankle (M4) | Full body | Heel clip | m4_heelclip_l/r | 2 | PRINT | PAHT-CF (or PA12-CF) | PAHT-CF, 0.4 hardened nozzle, 0.2 mm, 5 walls, 40% gyroid, layers laid across the load, heat-set inserts; prototype only; CNC 7075 if the bench shows creep under the 15 to 25 Nm ankle torque | 12.8 | 25.7 | EST | 1.4 | 2.8 |  | filament: https://www.gigaparts.com/bambu-lab-paht-cf-black-carbon-fiber-reinforced-paht-3d-printer-filament-1-75mm-1kg-spool.html | m4_heelclip
Ankle (M4) | Full body | Ankle clutch housing (Collins type, no power) | m4_clutch_l/r | 2 | PRINT | PAHT-CF (or PA12-CF) | PAHT-CF, 0.4 hardened nozzle, 0.2 mm, 5 walls, 40% gyroid, layers laid across the load, heat-set inserts | 14.6 | 29.3 | EST | 1.6 | 3.2 |  | filament: https://www.gigaparts.com/bambu-lab-paht-cf-black-carbon-fiber-reinforced-paht-3d-printer-filament-1-75mm-1kg-spool.html | m4_clutch
Ankle (M4) | Full body | Ankle clutch ratchet, pawl and spring set | inside m4_clutch: engages at foot-flat, releases at push-off | 2 | METAL | 17-4PH H900 stainless | CNC / wire-EDM 17-4PH; must be metal: the calf spring load passes through the pawl | 35 | 70 | EST | 60 | 120 | EST | EST: one-off job-shop price, get 3 quotes | (inside m4_clutch)
Ankle (M4) | Full body | Calf spring leaf | m4_spring_l/r | 2 | BUY | unidirectional E-glass laminate | laminated like the sit leaf | 12.3 | 24.5 | EST | 10 | 20 | EST | EST | m4_spring
Ankle (M4) | Full body | Ankle frame, shin pad to heel clip (not in the CAD yet) | carbon strip pair per side, after the Collins 2015 device | 2 | BUY | carbon strip or 7075 strip | cut from 3 mm carbon plate, bonded and bolted | 150 | 300 | EST | 40 | 80 | EST | EST: the CAD shows only the clip, clutch and leaf; Collins' whole device was about 0.4 to 0.5 kg per leg
Ankle (M4) | Full body | Ankle cable | m4_cable_l/r | 1 | BUY | Dyneema SK75 | spliced | 5 | 5 | EST | 1.88 | 1.88 |  | https://www.fisheriessupply.com/samson-rope-blue-amsteel-blue/872007006030 | m4_cable
Ankle (M4) | Full body | Ankle straps, heel-counter strap, fasteners |  | 2 | BUY | nylon webbing | sewn | 40 | 80 | EST | 12 | 24 | EST | EST
Shoulder (M5) | Full body | Shoulder spring cassette housing | m5_cassette_l/r | 2 | PRINT | PAHT-CF (or PA12-CF) | PAHT-CF, 0.4 hardened nozzle, 0.2 mm, 5 walls, 40% gyroid, layers laid across the load, heat-set inserts | 40.6 | 81.1 | EST | 4.43 | 8.86 |  | filament: https://www.gigaparts.com/bambu-lab-paht-cf-black-carbon-fiber-reinforced-paht-3d-printer-filament-1-75mm-1kg-spool.html | m5_cassette
Shoulder (M5) | Full body | Cassette spring set (Paexo-style arm support) | springs + cam + bearings inside m5_cassette | 2 | BUY | spring steel | off-the-shelf compression or torsion springs, tuned per wearer | 150 | 300 | EST | 45 | 90 | EST | EST
Shoulder (M5) | Full body | Arm lever | m5_lever_l/r, 12 x 6 mm | 2 | METAL | 7075-T6 aluminium | laser-cut 7075 strip with a bearing at the pivot; must be metal: arm support torque at the pivot | 45 | 90 | EST | 30 | 60 | EST | EST: one-off job-shop price, get 3 quotes | m5_lever
Shoulder (M5) | Full body | Arm cuff | m5_armcuff_l/r | 2 | PRINT | PAHT-CF (or PA12-CF) | PAHT-CF, 0.4 hardened nozzle, 0.2 mm layers, wall printed solid (6 to 8 perimeters), dried 80 C 8 h | 36.7 | 73.5 | EST | 4.01 | 8.02 |  | filament: https://www.gigaparts.com/bambu-lab-paht-cf-black-carbon-fiber-reinforced-paht-3d-printer-filament-1-75mm-1kg-spool.html | m5_armcuff
Shoulder (M5) | Full body | Arm cuff pad | m5_armliner_l/r | 2 | PRINT | TPU 95A HF | TPU 95A HF, 0.2 mm, graded gyroid (about 12% at the skin to 25% at the shell), no supports; spacer mesh or gel glued on | 16.2 | 32.5 | EST | 0.73 | 1.46 |  | filament: https://3dprintingusa.com/collections/bambu-lab-tpu | m5_armliner
Shoulder (M5) | Full body | Arm straps and fasteners |  | 2 | BUY | nylon webbing | sewn | 30 | 60 | EST | 10 | 20 | EST | EST
