nicedreamzapp/sitka/cad/stl/strut_clip_hi_l.stl

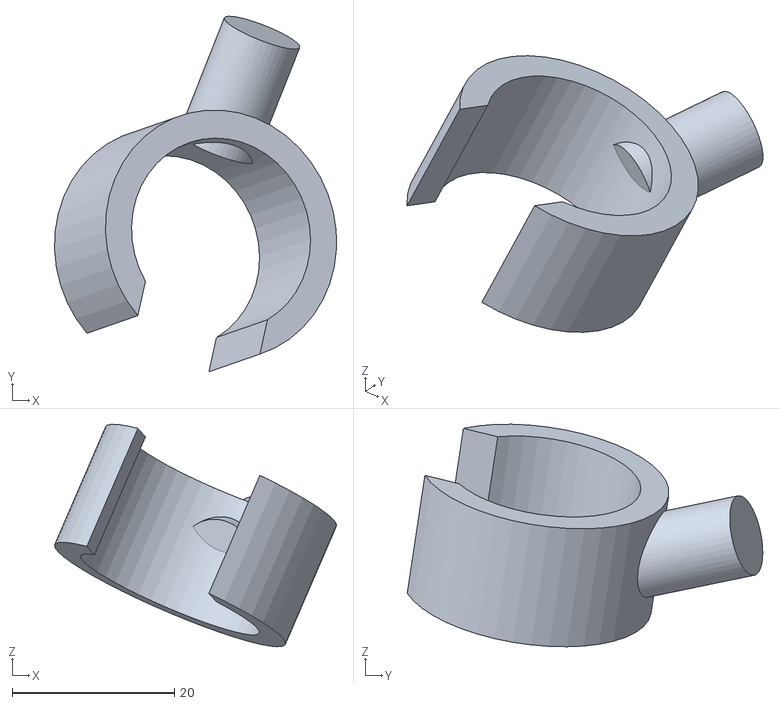
[picture p21: CAD file, 2026-10-30]
cad/stl/strut_clip_hi_l.stl
34.8 x 43.8 x 27.4
