nicedreamzapp/sitka/cad/stl/condyle_pad_lat_r.stl

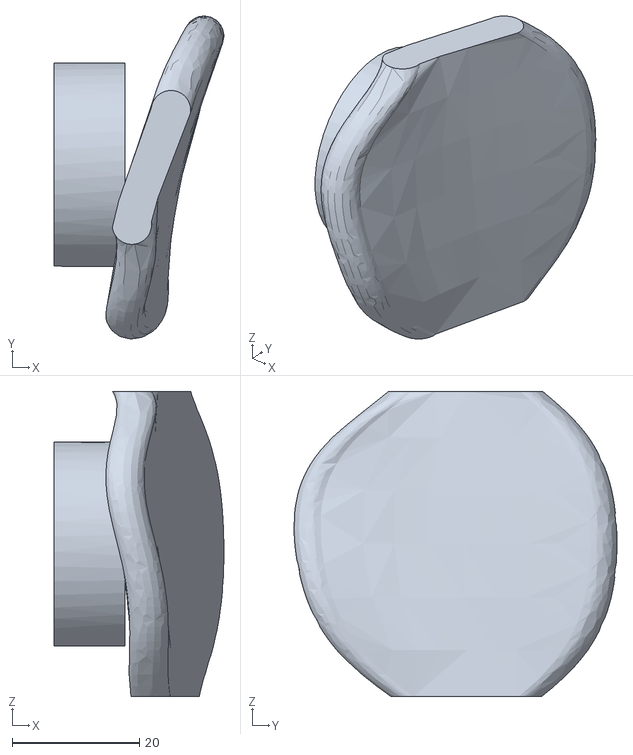
[picture p22: CAD file, 2026-10-30]
cad/stl/condyle_pad_lat_r.stl
26.7 x 50.8 x 48.0
