nicedreamzapp/sitka/cad/stl/condyle_pad_med_l.stl

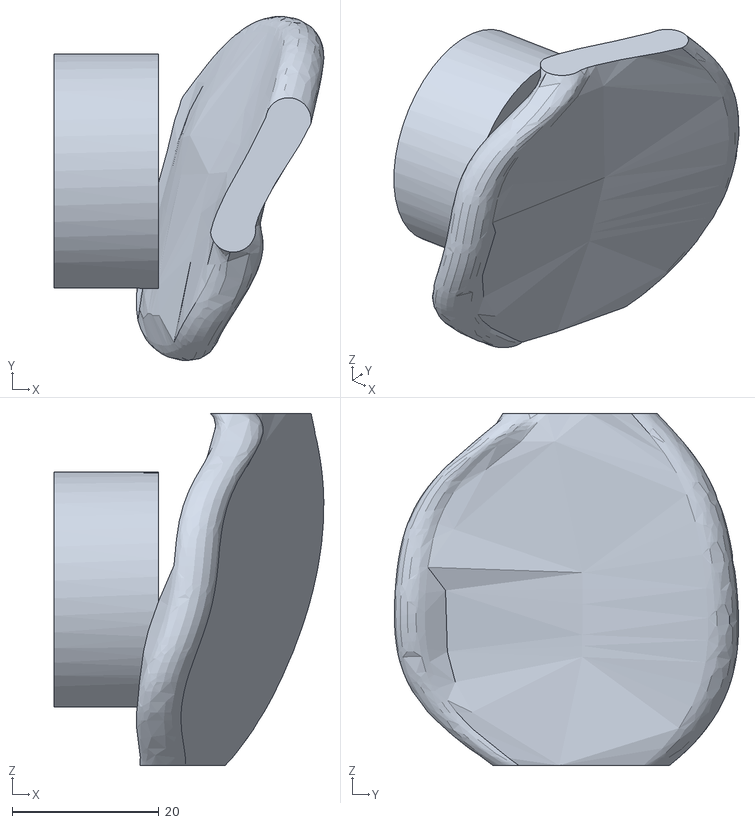
[picture p23: CAD file, 2026-10-30]
cad/stl/condyle_pad_med_l.stl
36.8 x 46.9 x 48.0
