nicedreamzapp/sitka/cad/stl/dring_t3_r.stl

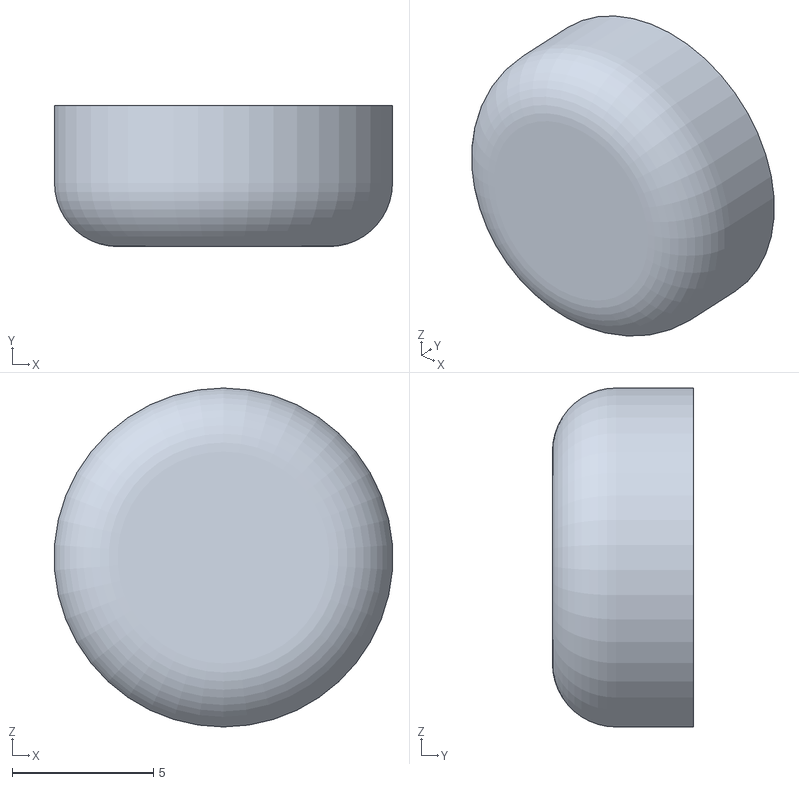
[picture p24: CAD file, 2026-10-30]
cad/stl/dring_t3_r.stl
12.0 x 5.00 x 12.0
