nicedreamzapp/sitka/cad/stl/dring_cc_l.stl

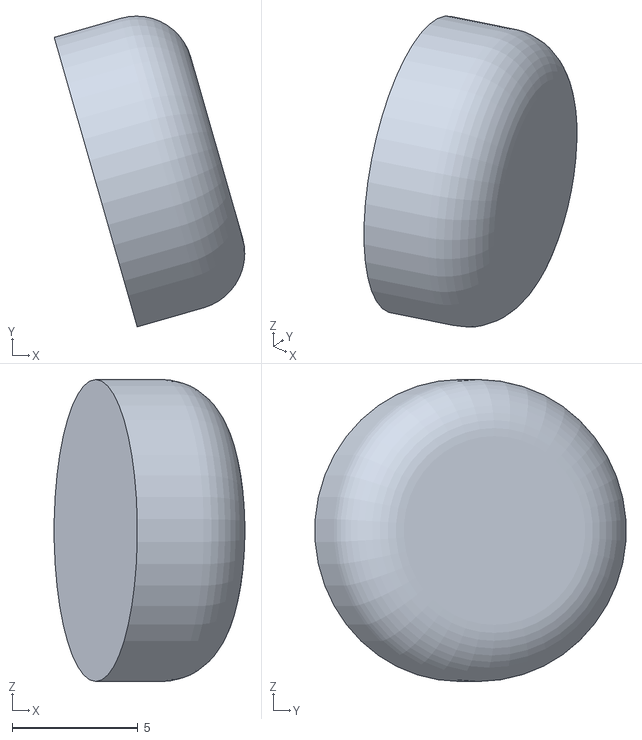
[picture p25: CAD file, 2026-10-30]
cad/stl/dring_cc_l.stl
7.57 x 12.3 x 12.0
