nicedreamzapp/sitka/cad/stl/strut_fork_l.stl

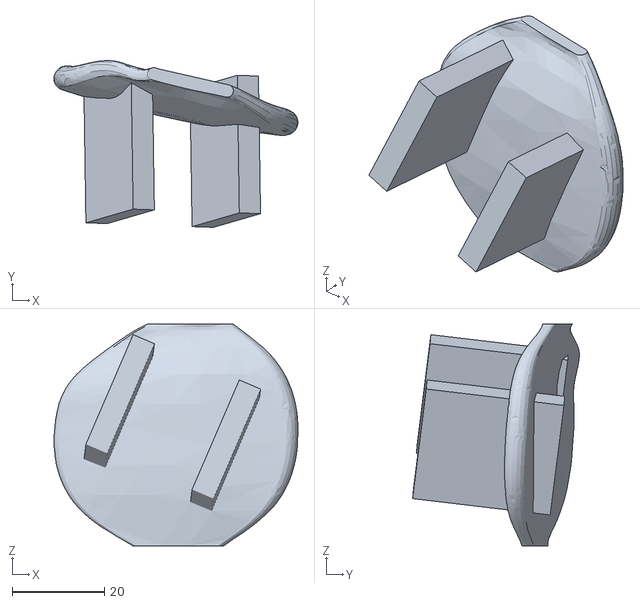
[picture p26: CAD file, 2026-10-30]
cad/stl/strut_fork_l.stl
52.8 x 36.1 x 48.0
