nicedreamzapp/sitka/cad/stl/seat_cup_liner_l.stl

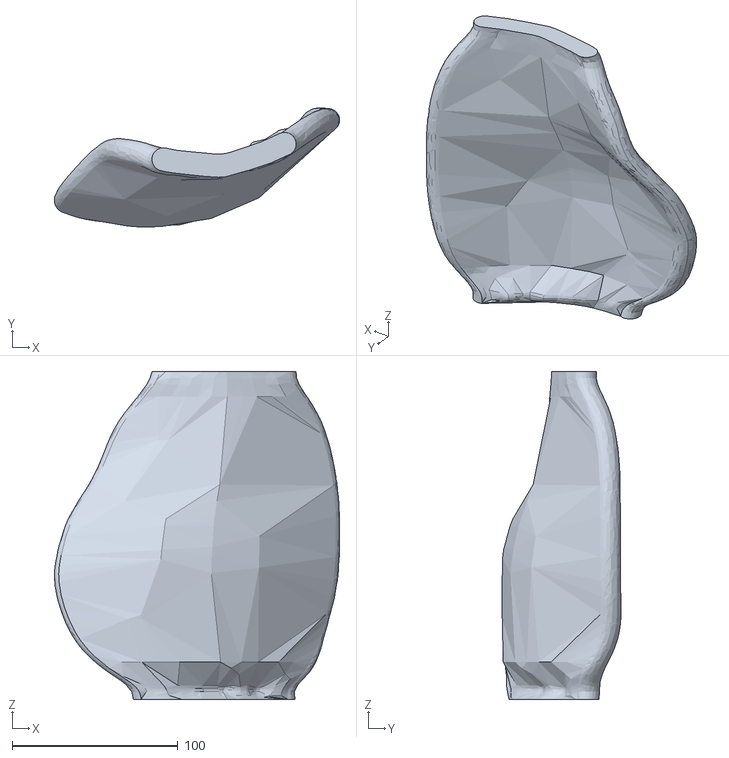
[picture p27: CAD file, 2026-10-30]
cad/stl/seat_cup_liner_l.stl
172.2 x 72.0 x 198.0
