nicedreamzapp/sitka/cad/stl/strut_hingepin_r.stl

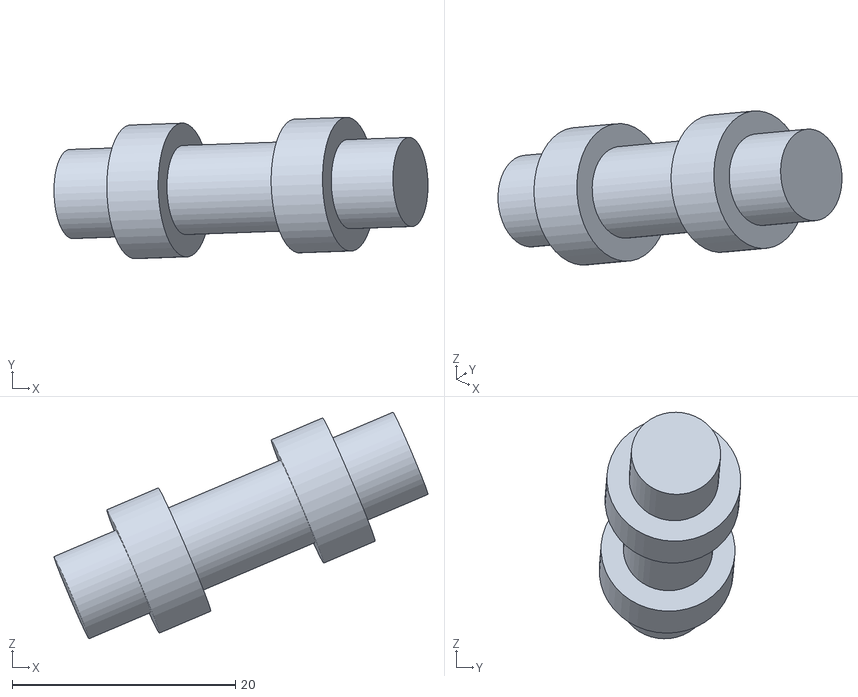
[picture p28: CAD file, 2026-10-30]
cad/stl/strut_hingepin_r.stl
33.5 x 12.6 x 20.3
