nicedreamzapp/sitka/cad/stl/strut_clip_l.stl

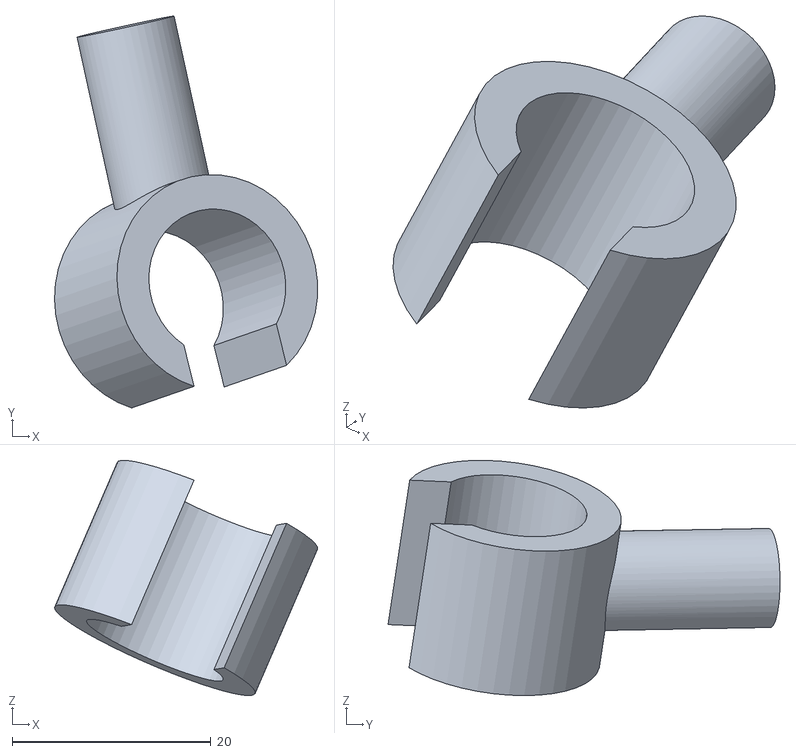
[picture p29: CAD file, 2026-10-30]
cad/stl/strut_clip_l.stl
26.5 x 39.5 x 23.7
