nicedreamzapp/sitka/cad/stl/port_shoulder_r.stl

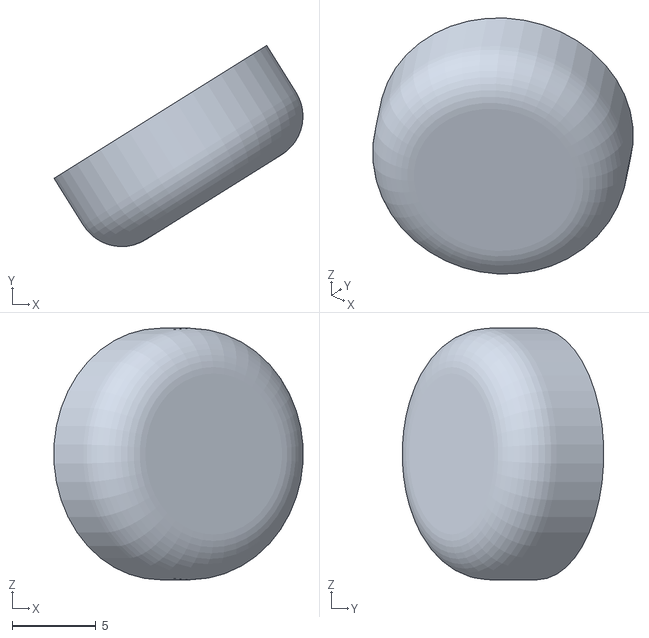
[picture p30: CAD file, 2026-10-30]
cad/stl/port_shoulder_r.stl
14.8 x 12.0 x 15.0
