nicedreamzapp/sitka/cad/stl/m5_cassette_l.stl

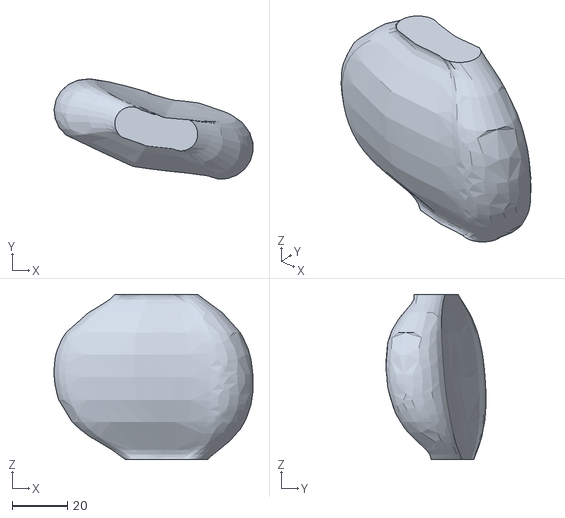
[picture p31: CAD file, 2026-10-30]
cad/stl/m5_cassette_l.stl
72.2 x 36.3 x 60.0
