nicedreamzapp/sitka/cad/stl/strut_fork_r.stl

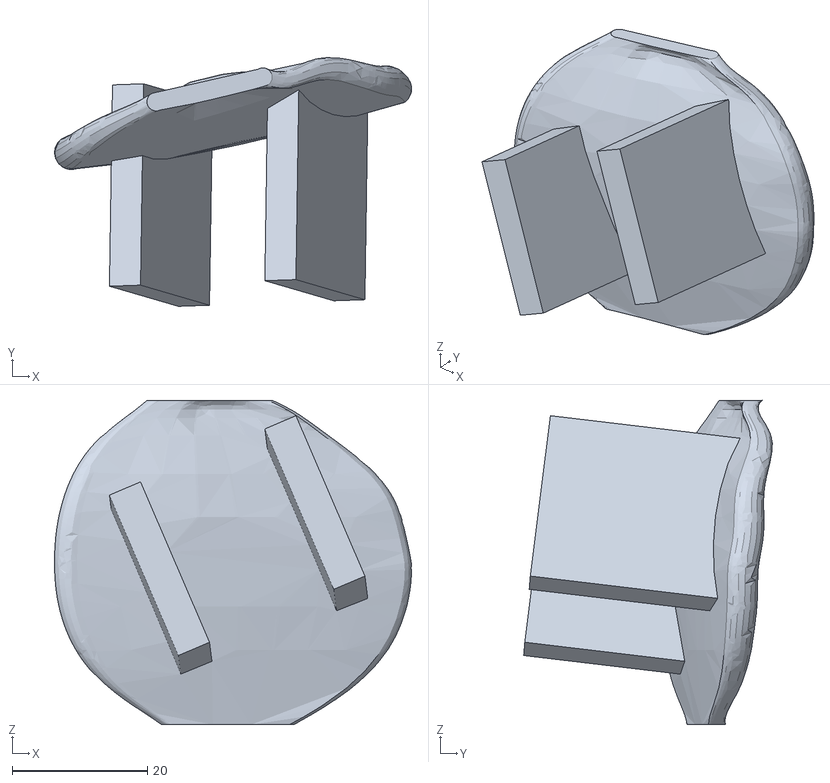
[picture p32: CAD file, 2026-10-30]
cad/stl/strut_fork_r.stl
52.8 x 36.8 x 48.0
