nicedreamzapp/sitka/cad/stl/m3_standoff_r.stl

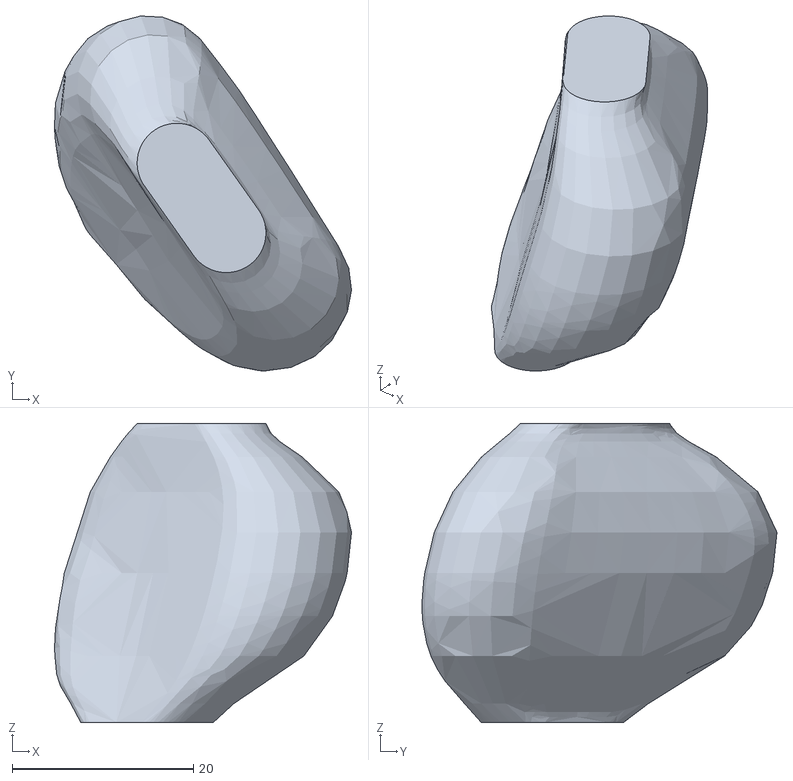
[picture p33: CAD file, 2026-10-30]
cad/stl/m3_standoff_r.stl
32.8 x 39.2 x 33.0
