nicedreamzapp/sitka/cad/stl/dring_ham_r.stl

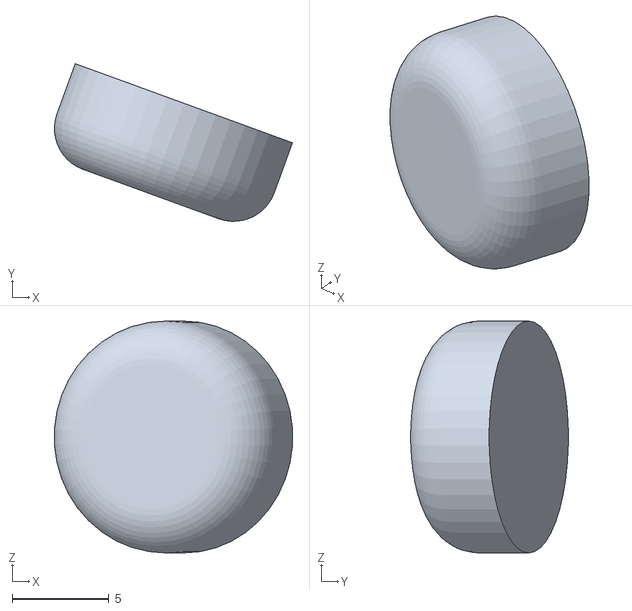
[picture p34: CAD file, 2026-10-30]
cad/stl/dring_ham_r.stl
12.3 x 8.15 x 12.0
