nicedreamzapp/sitka/cad/stl/dring_calf_l.stl

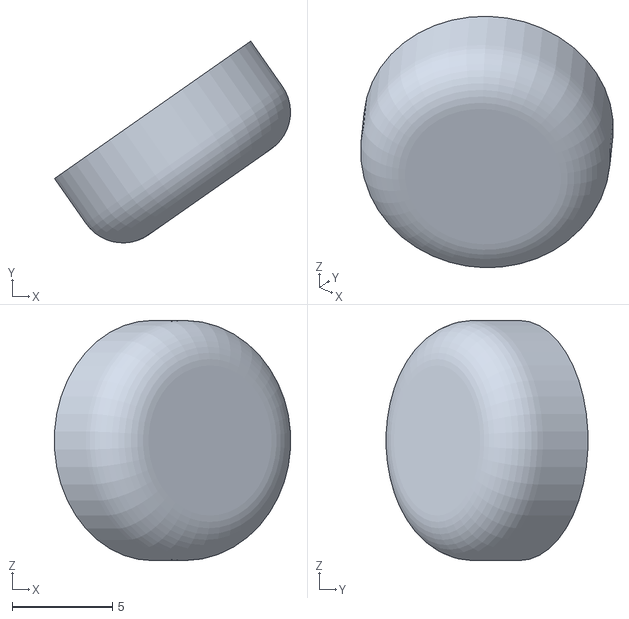
[picture p35: CAD file, 2026-10-30]
cad/stl/dring_calf_l.stl
11.8 x 10.1 x 12.0
