nicedreamzapp/sitka/cad/stl/bowden_stop_r.stl

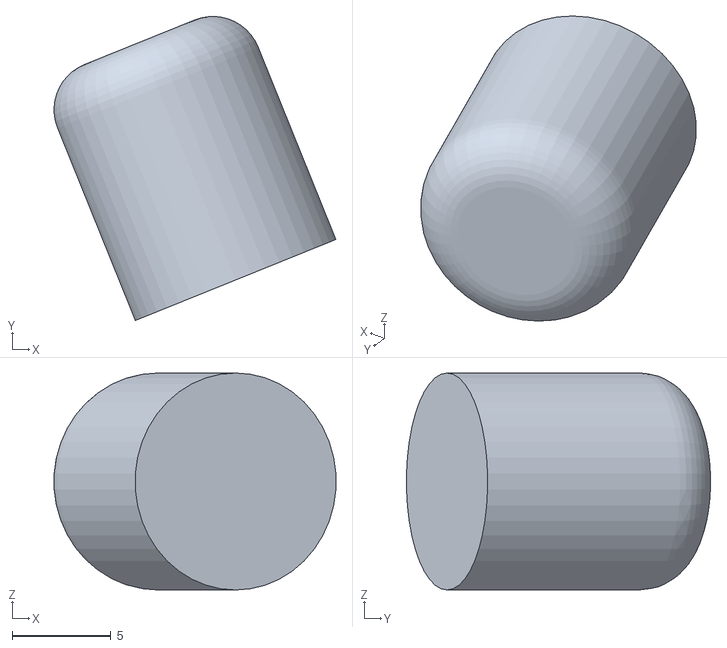
[picture p36: CAD file, 2026-10-30]
cad/stl/bowden_stop_r.stl
14.3 x 15.4 x 11.0
