nicedreamzapp/sitka/cad/stl/thigh_liner_l.stl

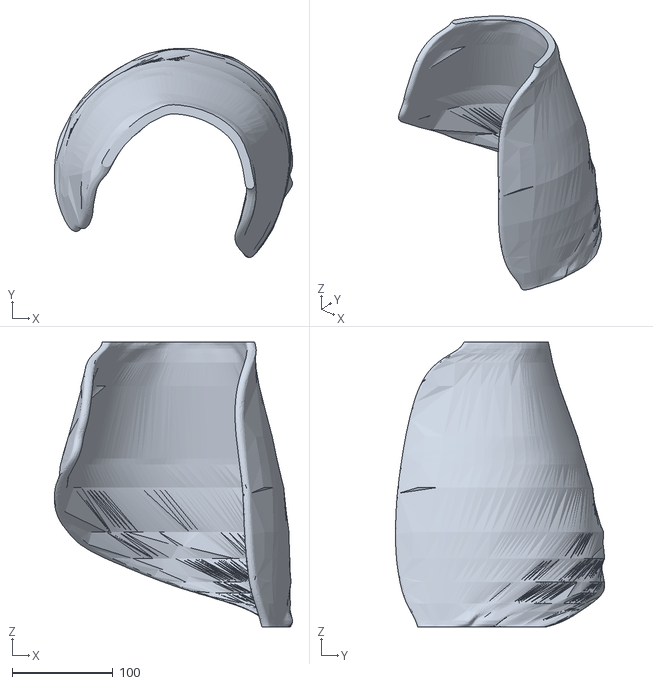
[picture p37: CAD file, 2026-10-30]
cad/stl/thigh_liner_l.stl
236.8 x 207.8 x 283.0
