nicedreamzapp/sitka/cad/stl/seat_cup_liner_r.stl

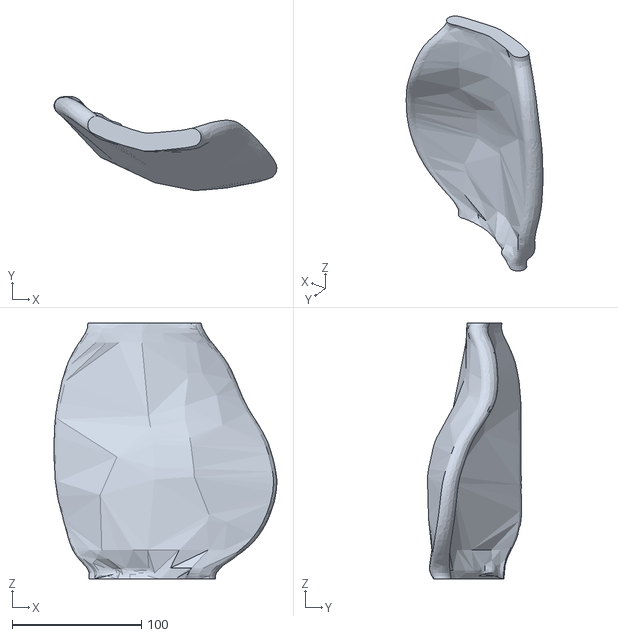
[picture p38: CAD file, 2026-10-30]
cad/stl/seat_cup_liner_r.stl
172.3 x 72.9 x 198.0
