nicedreamzapp/sitka/cad/stl/calf_liner_l.stl

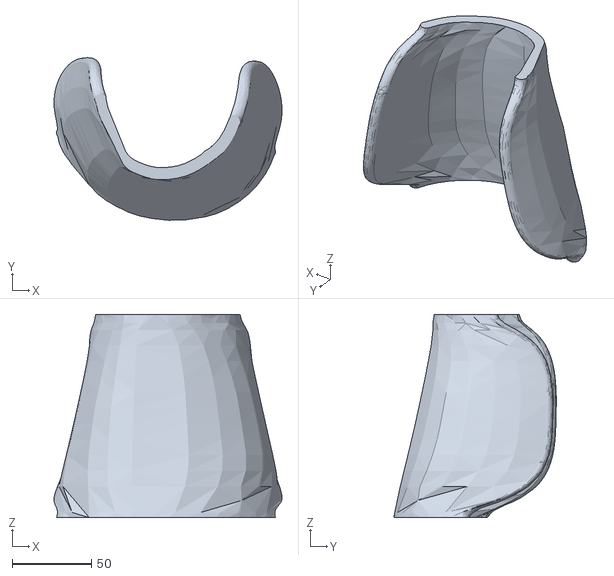
[picture p39: CAD file, 2026-10-30]
cad/stl/calf_liner_l.stl
143.5 x 102.3 x 128.0
