nicedreamzapp/sitka/cad/stl/runband_clip_r.stl

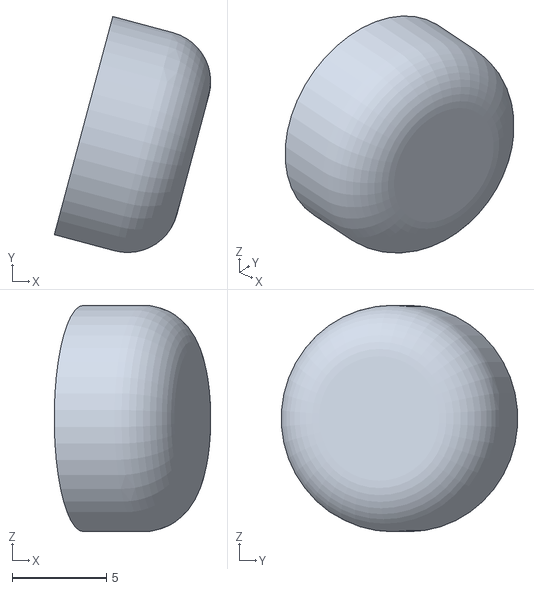
[picture p40: CAD file, 2026-10-30]
cad/stl/runband_clip_r.stl
8.29 x 12.5 x 12.0
