nicedreamzapp/sitka/cad/stl/condyle_pad_lat_l.stl

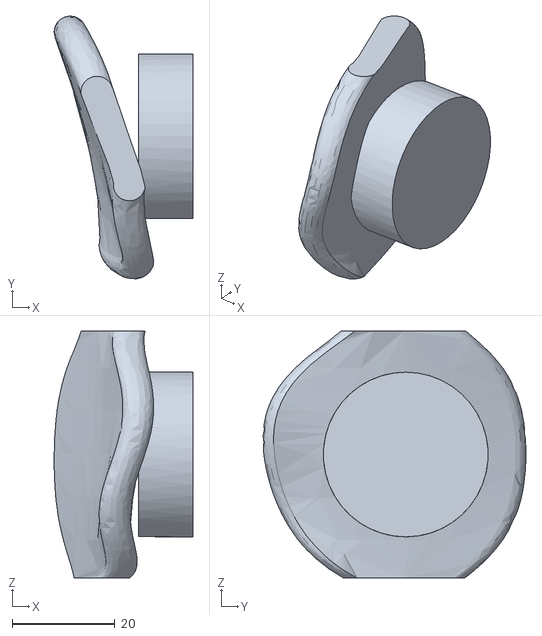
[picture p41: CAD file, 2026-10-30]
cad/stl/condyle_pad_lat_l.stl
27.0 x 51.1 x 48.0
