nicedreamzapp/sitka/cad/stl/thigh_cuff_liner_l.stl

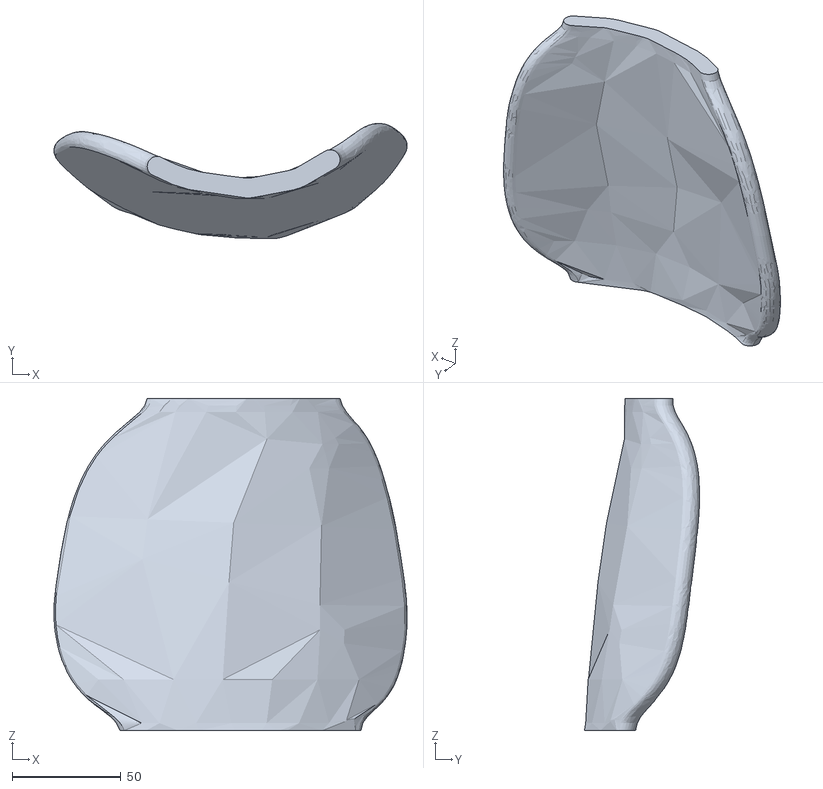
[picture p42: CAD file, 2026-10-30]
cad/stl/thigh_cuff_liner_l.stl
162.5 x 53.0 x 153.0
