nicedreamzapp/sitka/cad/stl/dring_m3_r.stl

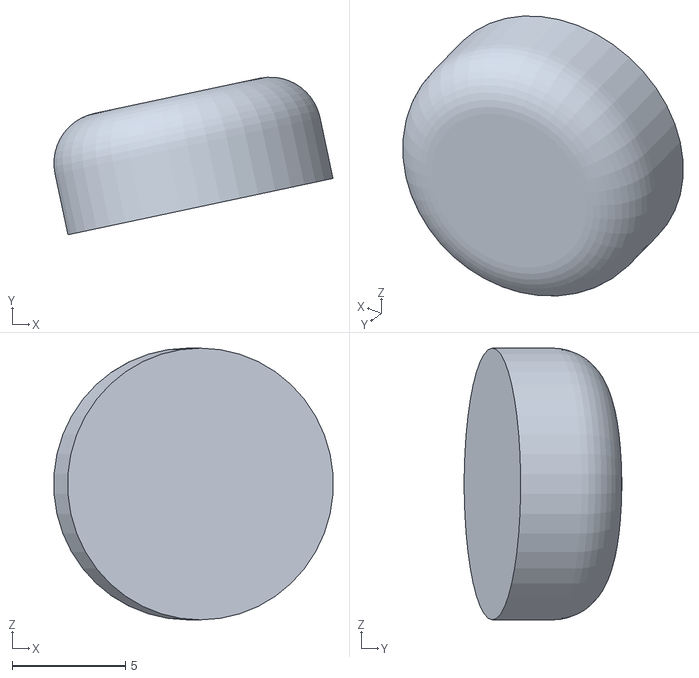
[picture p43: CAD file, 2026-10-30]
cad/stl/dring_m3_r.stl
12.3 x 6.96 x 12.0
