nicedreamzapp/sitka/cad/stl/shin_liner_l.stl

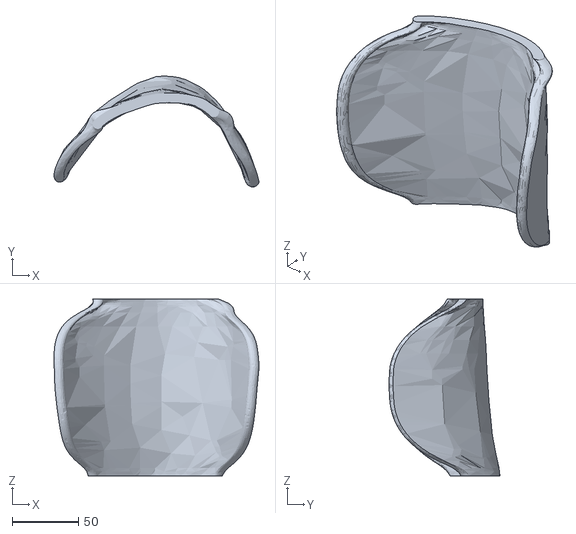
[picture p44: CAD file, 2026-10-30]
cad/stl/shin_liner_l.stl
154.3 x 83.4 x 133.0
