nicedreamzapp/sitka/cad/stl/condyle_pad_med_r.stl

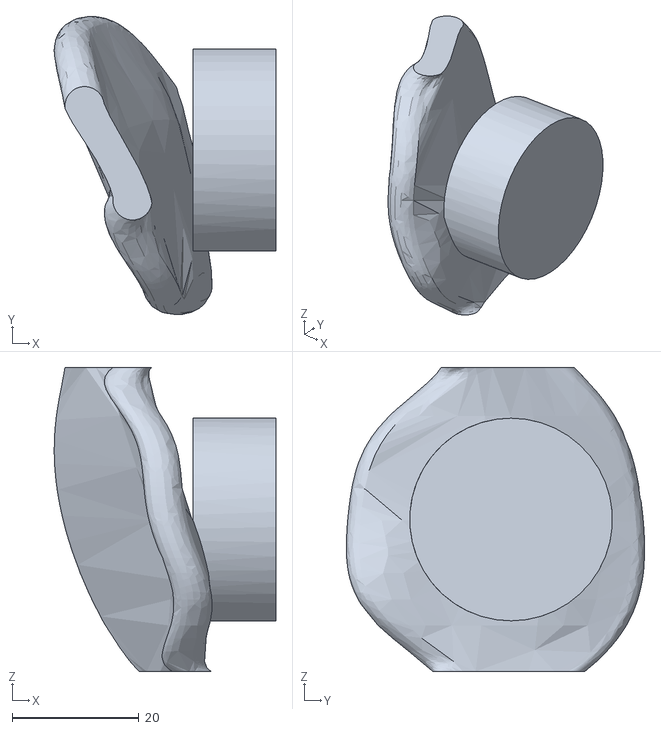
[picture p45: CAD file, 2026-10-30]
cad/stl/condyle_pad_med_r.stl
35.0 x 47.1 x 48.0
