nicedreamzapp/sitka/cad/stl/back_panel_liner.stl

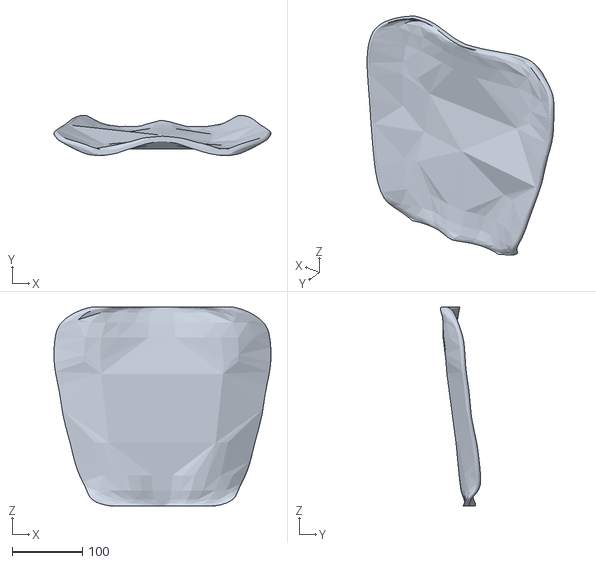
[picture p46: CAD file, 2026-10-30]
cad/stl/back_panel_liner.stl
308.7 x 57.5 x 283.0
