nicedreamzapp/sitka/cad/stl/calf_liner_r.stl

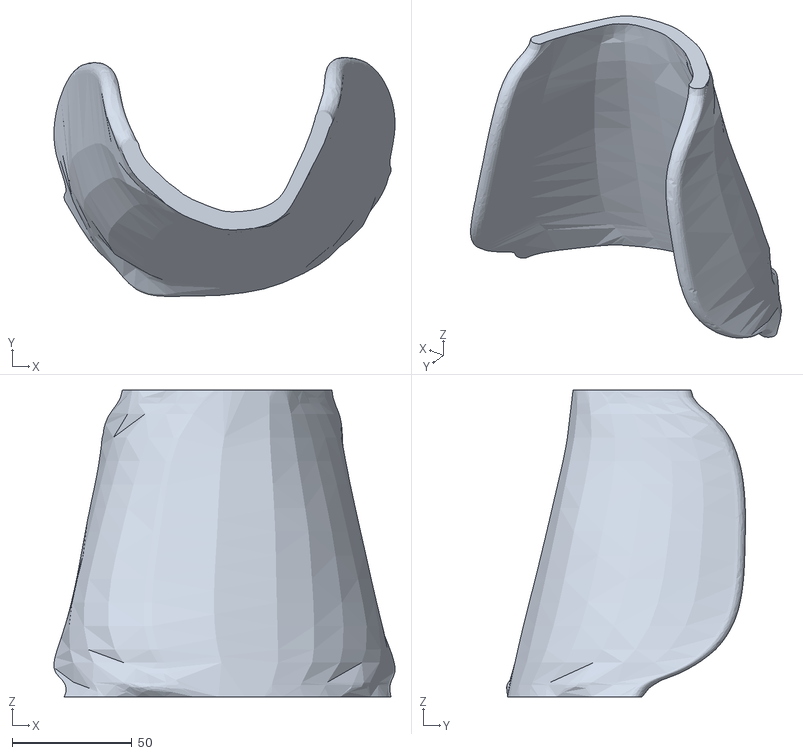
[picture p47: CAD file, 2026-10-30]
cad/stl/calf_liner_r.stl
142.4 x 99.7 x 128.0
