nicedreamzapp/sitka/cad/stl/thigh_buckle1_r.stl

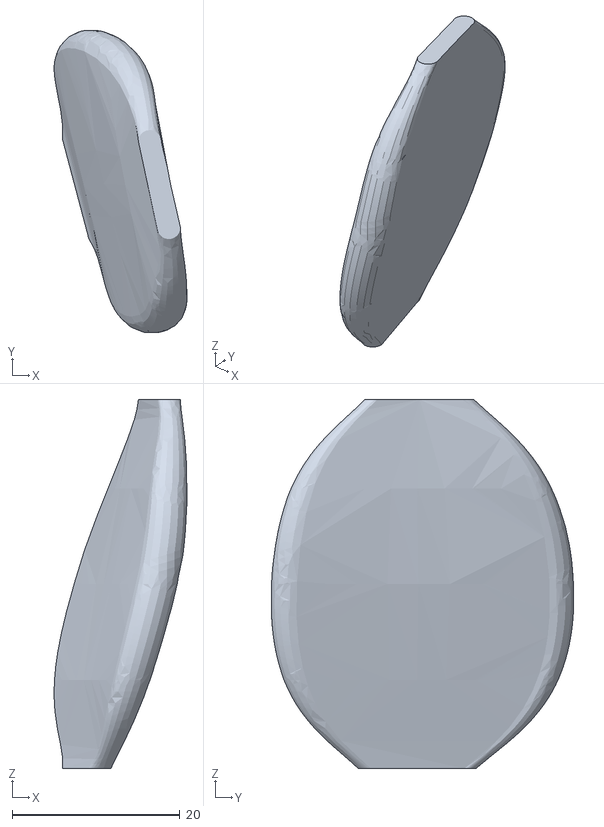
[picture p48: CAD file, 2026-10-22]
cad/stl/thigh_buckle1_r.stl
15.8 x 36.1 x 44.0
