nicedreamzapp/sitka/cad/stl/glute_guide_r.stl

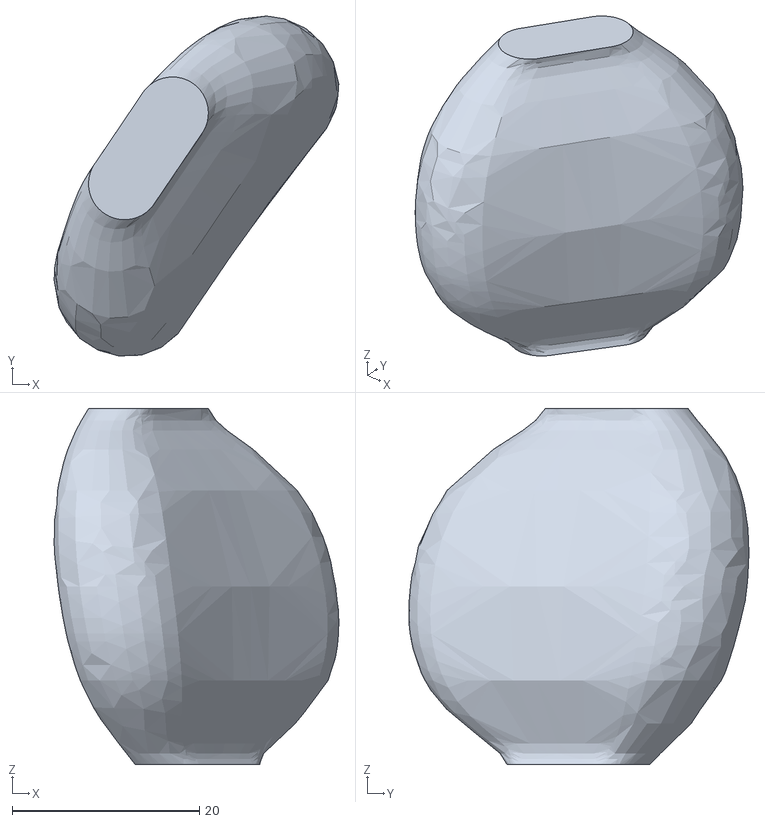
[picture p49: CAD file, 2026-10-22]
cad/stl/glute_guide_r.stl
30.4 x 36.3 x 38.0
