nicedreamzapp/sitka/cad/stl/m4_spring_l.stl

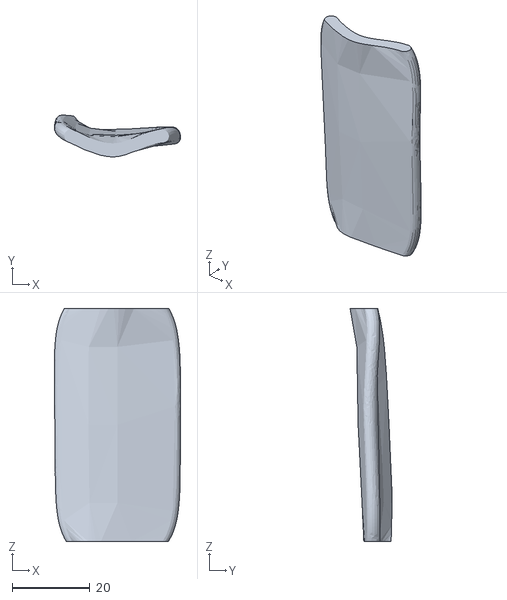
[picture p50: CAD file, 2026-10-22]
cad/stl/m4_spring_l.stl
32.5 x 10.8 x 60.0
