nicedreamzapp/sitka/cad/stl/m4_spring_r.stl

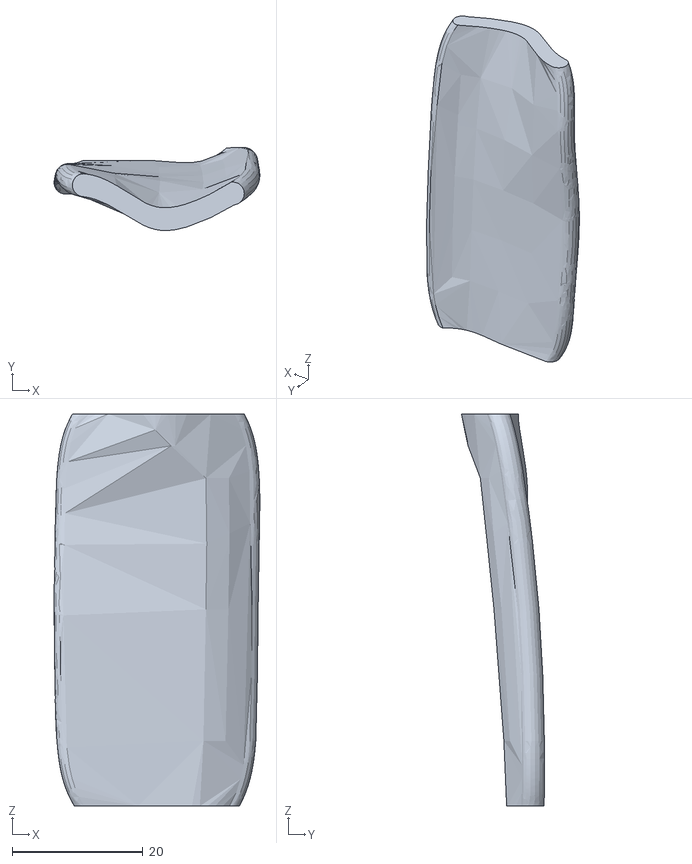
[picture p51: CAD file, 2026-10-22]
cad/stl/m4_spring_r.stl
31.5 x 12.7 x 60.0
