nicedreamzapp/sitka/cad/stl/thigh_buckle0_r.stl

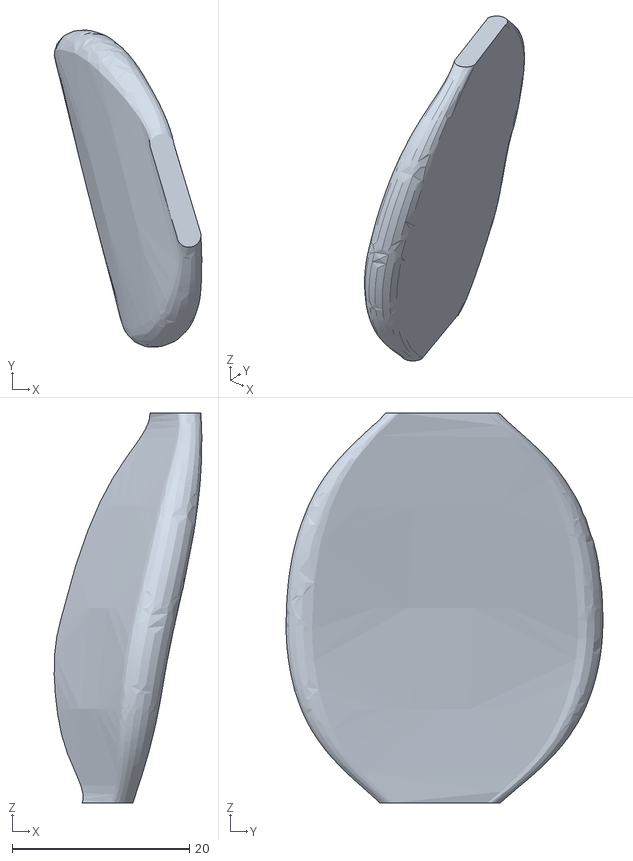
[picture p52: CAD file, 2026-10-22]
cad/stl/thigh_buckle0_r.stl
16.7 x 35.7 x 44.0
