nicedreamzapp/sitka/cad/stl/panel_guide_l.stl

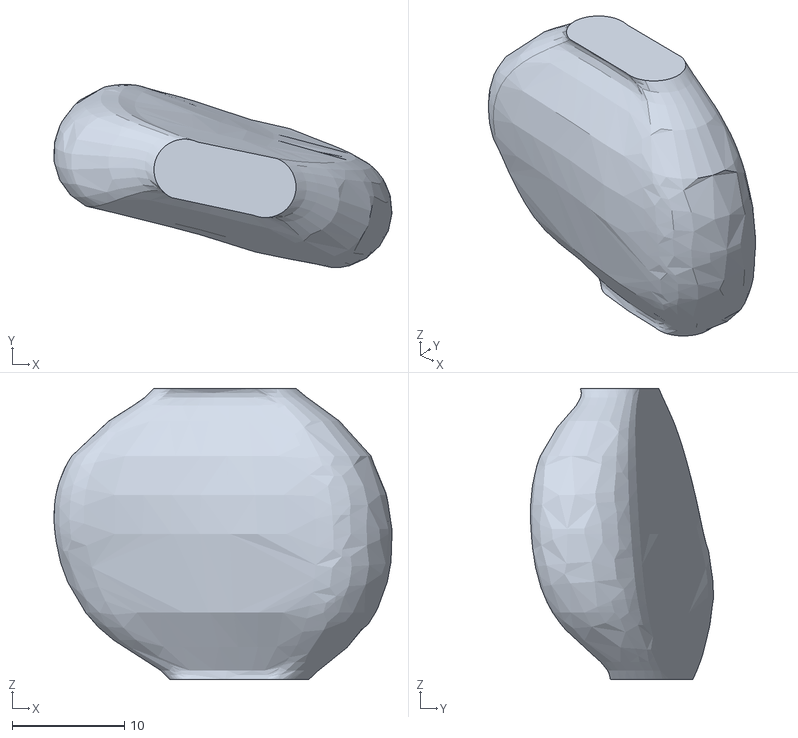
[picture p53: CAD file, 2026-10-22]
cad/stl/panel_guide_l.stl
30.2 x 16.3 x 26.0
