nicedreamzapp/sitka/cad/stl/m5_armcuff_r.stl

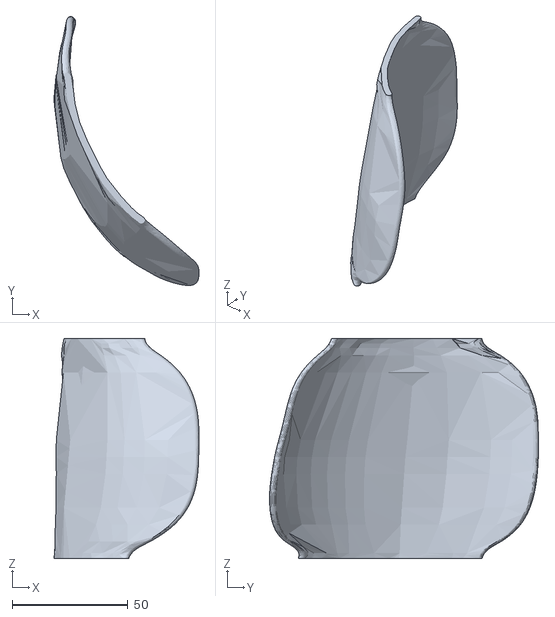
[picture p54: CAD file, 2026-10-22]
cad/stl/m5_armcuff_r.stl
62.6 x 116.1 x 95.0
