nicedreamzapp/sitka/cad/stl/knee_manifold_r.stl

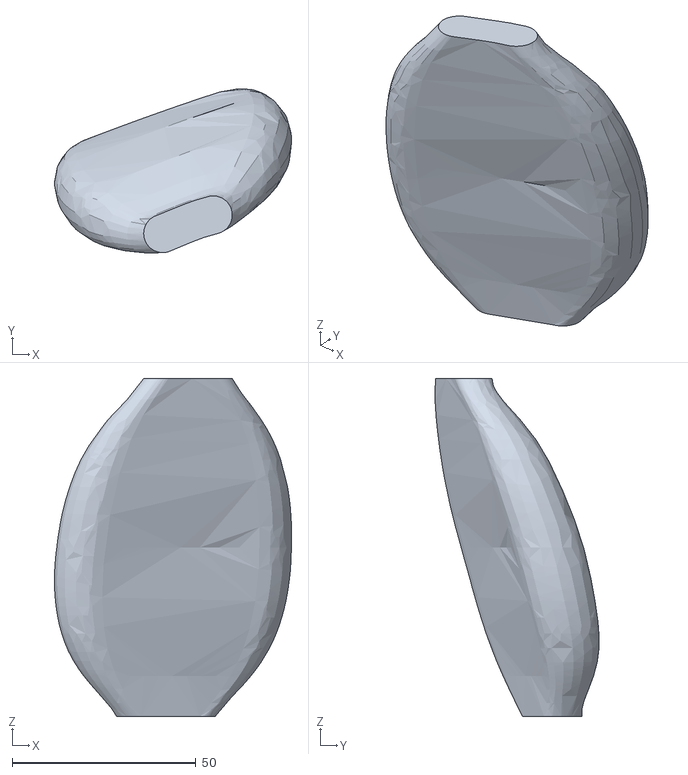
[picture p55: CAD file, 2026-10-22]
cad/stl/knee_manifold_r.stl
64.6 x 44.7 x 92.0
