nicedreamzapp/sitka/cad/stl/belt_sideclip_l.stl

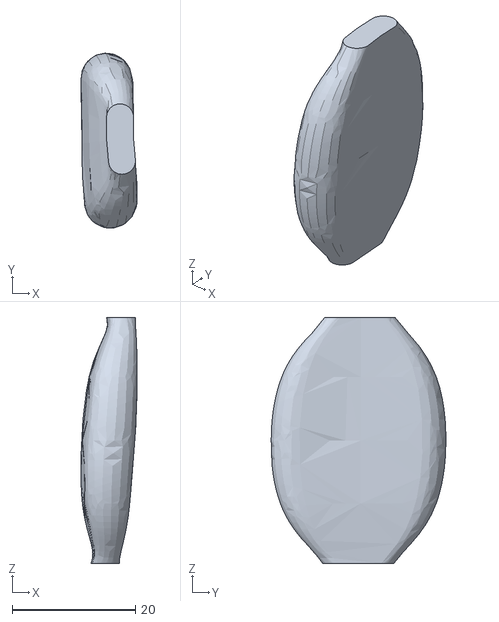
[picture p56: CAD file, 2026-10-22]
cad/stl/belt_sideclip_l.stl
9.15 x 28.4 x 40.0
