nicedreamzapp/sitka/cad/stl/thigh_buckle1_l.stl

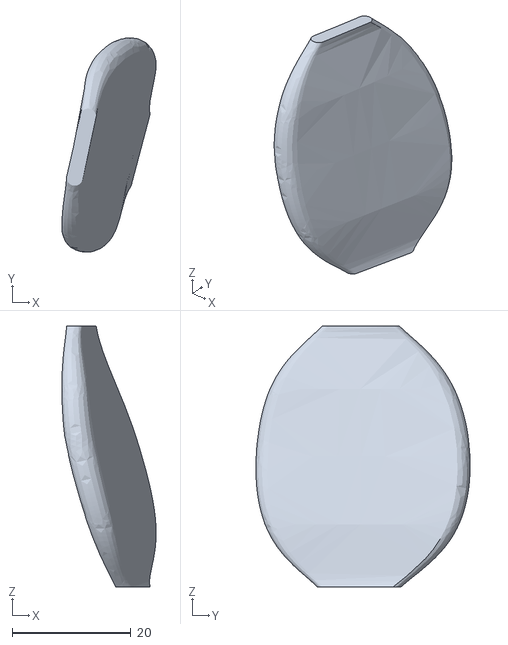
[picture p57: CAD file, 2026-10-22]
cad/stl/thigh_buckle1_l.stl
15.9 x 36.1 x 44.0
