nicedreamzapp/sitka/cad/stl/port_hip_r.stl

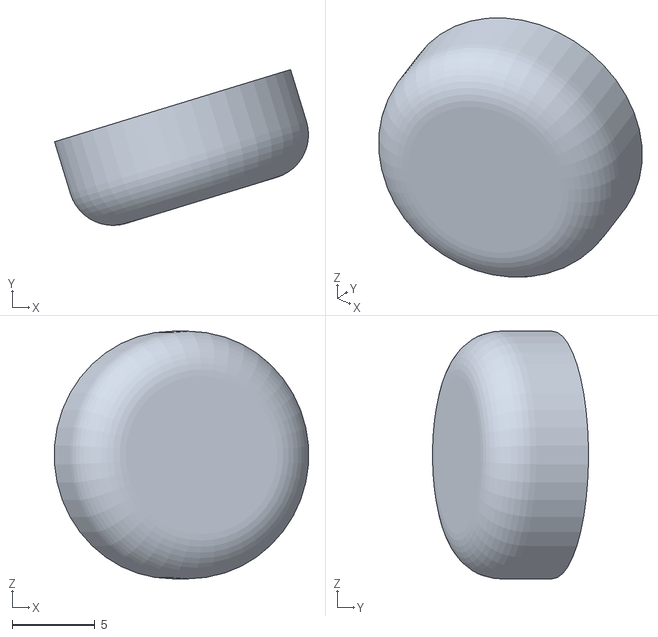
[picture p58: CAD file, 2026-10-22]
cad/stl/port_hip_r.stl
15.4 x 9.44 x 15.0
