nicedreamzapp/sitka/cad/stl/mode_lever_r.stl

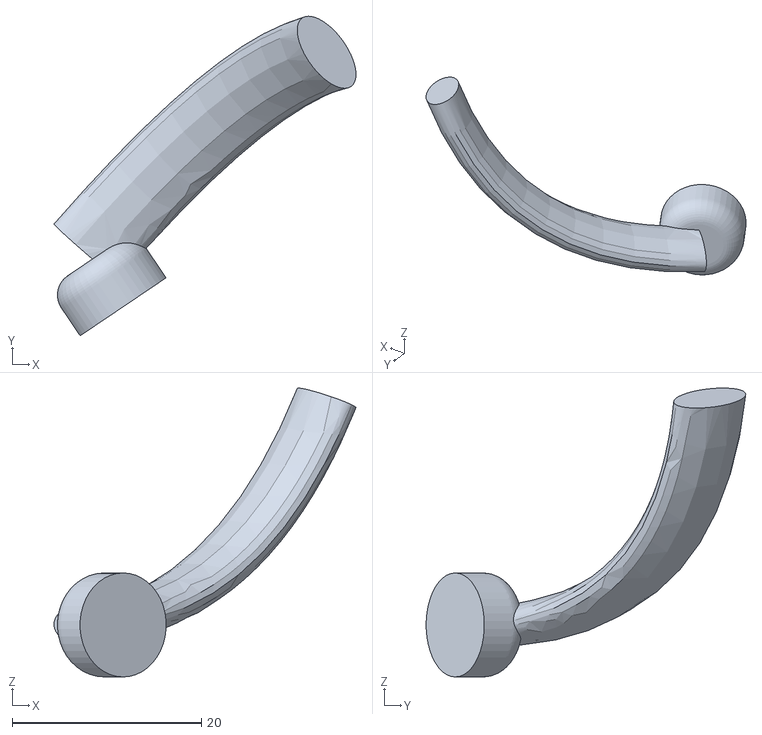
[picture p59: CAD file, 2026-10-22]
cad/stl/mode_lever_r.stl
31.9 x 33.8 x 30.6
