nicedreamzapp/sitka/cad/stl/knee_guide_l.stl

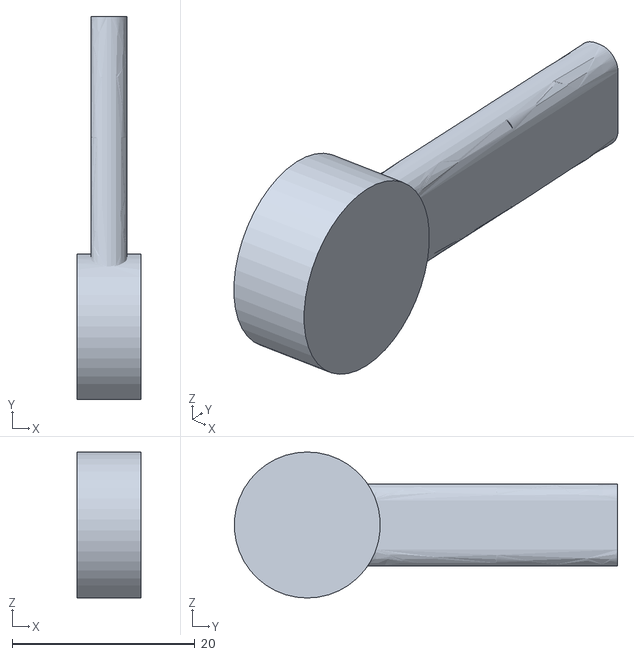
[picture p60: CAD file, 2026-10-22]
cad/stl/knee_guide_l.stl
7.00 x 42.0 x 16.0
