nicedreamzapp/sitka/cad/stl/belt_buckle.stl

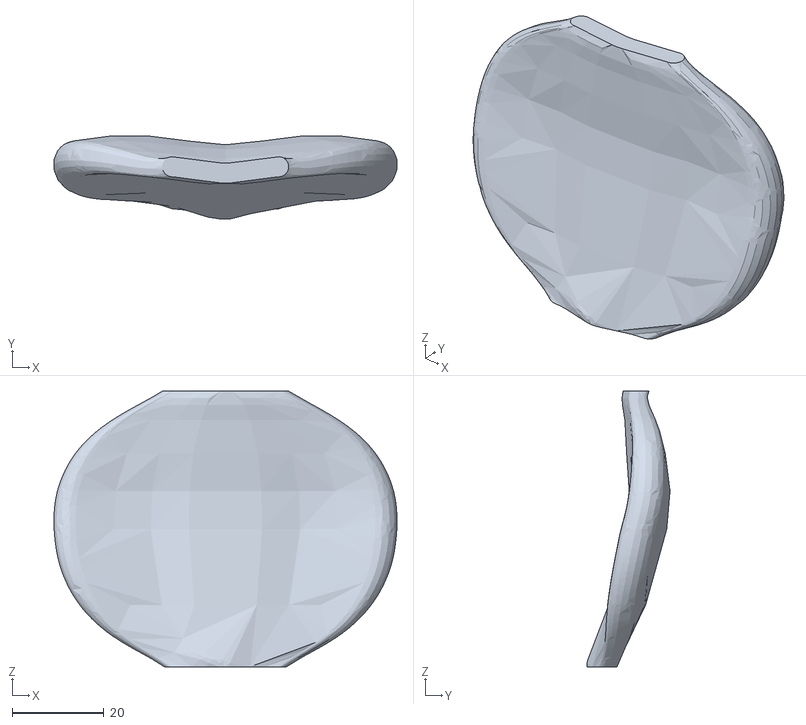
[picture p61: CAD file, 2026-10-22]
cad/stl/belt_buckle.stl
74.6 x 18.1 x 60.0
