nicedreamzapp/sitka/cad/stl/m4_heelclip_l.stl

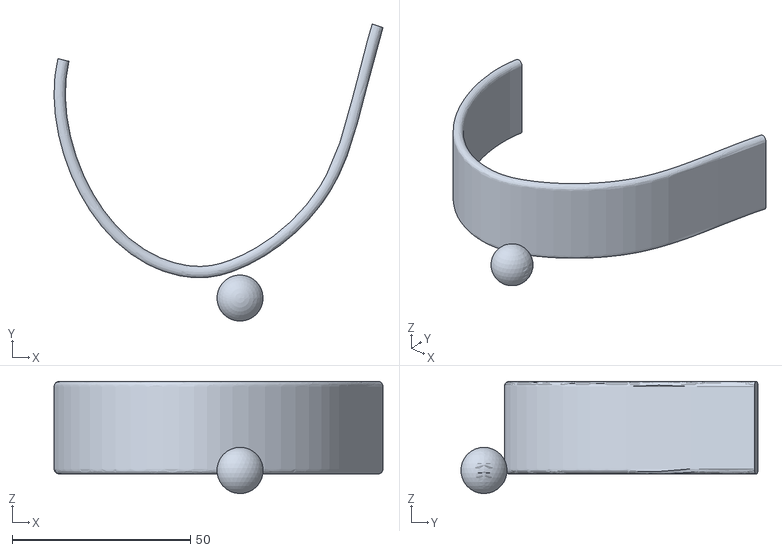
[picture p62: CAD file, 2026-10-22]
cad/stl/m4_heelclip_l.stl
92.4 x 83.4 x 31.5
