nicedreamzapp/sitka/cad/stl/belt_sideclip_r.stl

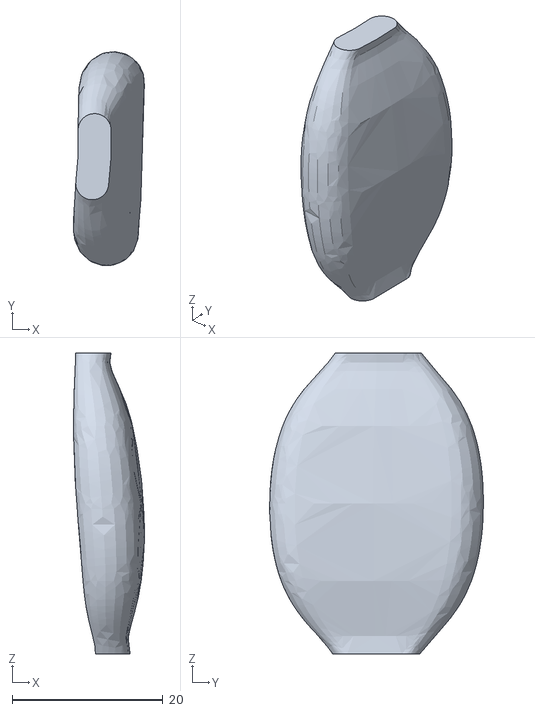
[picture p63: CAD file, 2026-10-22]
cad/stl/belt_sideclip_r.stl
9.40 x 28.4 x 40.0
