nicedreamzapp/sitka/cad/stl/m5_armliner_l.stl

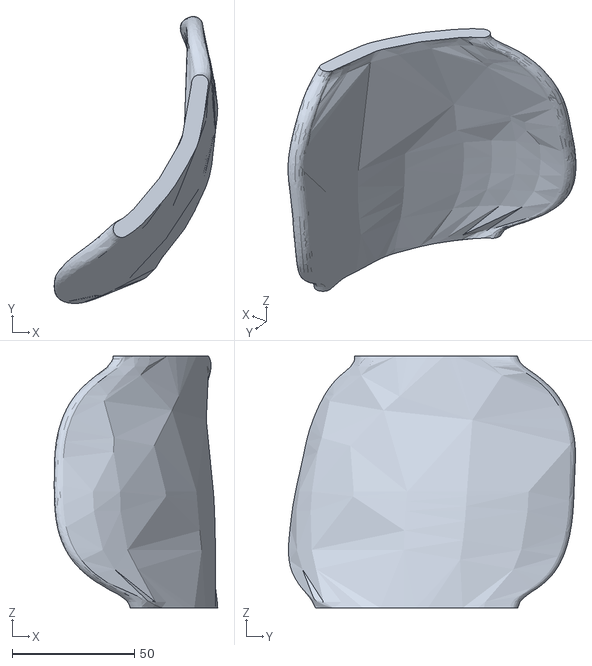
[picture p64: CAD file, 2026-10-22]
cad/stl/m5_armliner_l.stl
66.9 x 117.3 x 103.0
