nicedreamzapp/sitka/cad/stl/m4_clutch_l.stl

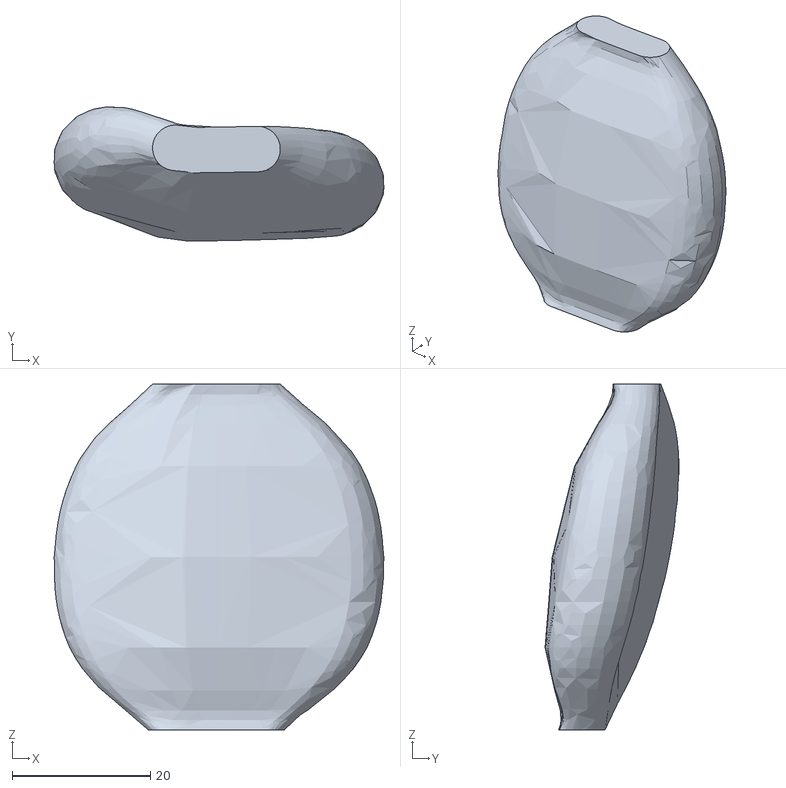
[picture p65: CAD file, 2026-10-22]
cad/stl/m4_clutch_l.stl
47.6 x 19.4 x 50.0
