nicedreamzapp/sitka/cad/stl/tendon_fairlead_r.stl

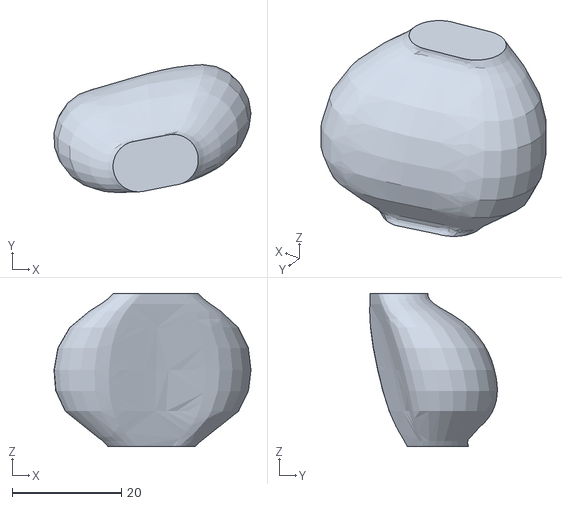
[picture p66: CAD file, 2026-10-22]
cad/stl/tendon_fairlead_r.stl
36.0 x 23.4 x 28.0
