nicedreamzapp/sitka/cad/stl/m2_leaf_root.stl

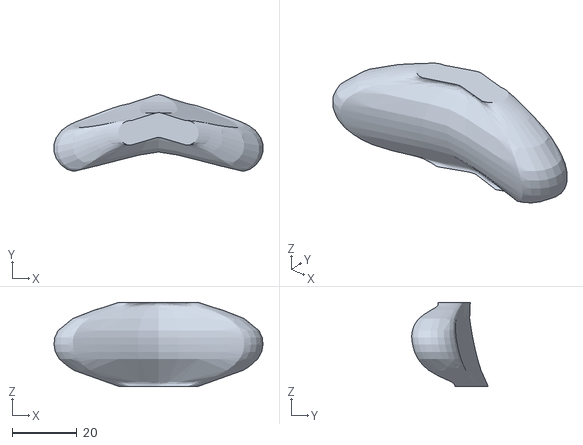
[picture p67: CAD file, 2026-10-22]
cad/stl/m2_leaf_root.stl
64.7 x 23.7 x 26.0
