nicedreamzapp/sitka/cad/stl/lumbar_standoff_l.stl

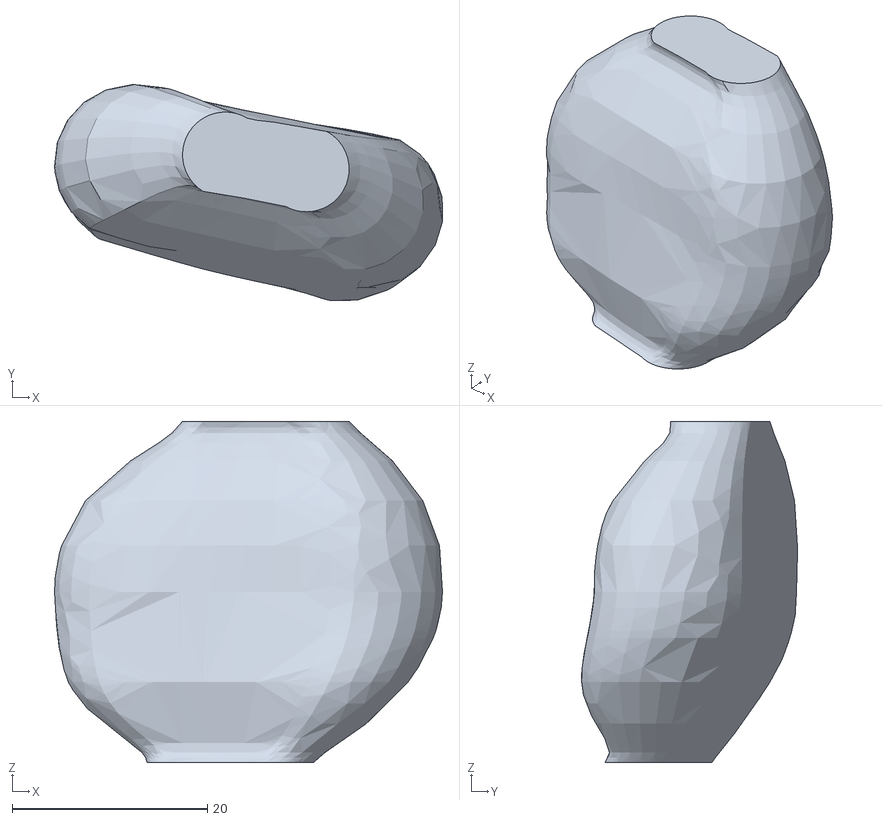
[picture p68: CAD file, 2026-10-22]
cad/stl/lumbar_standoff_l.stl
39.8 x 22.1 x 35.0
