nicedreamzapp/sitka/cad/stl/m4_clutch_r.stl

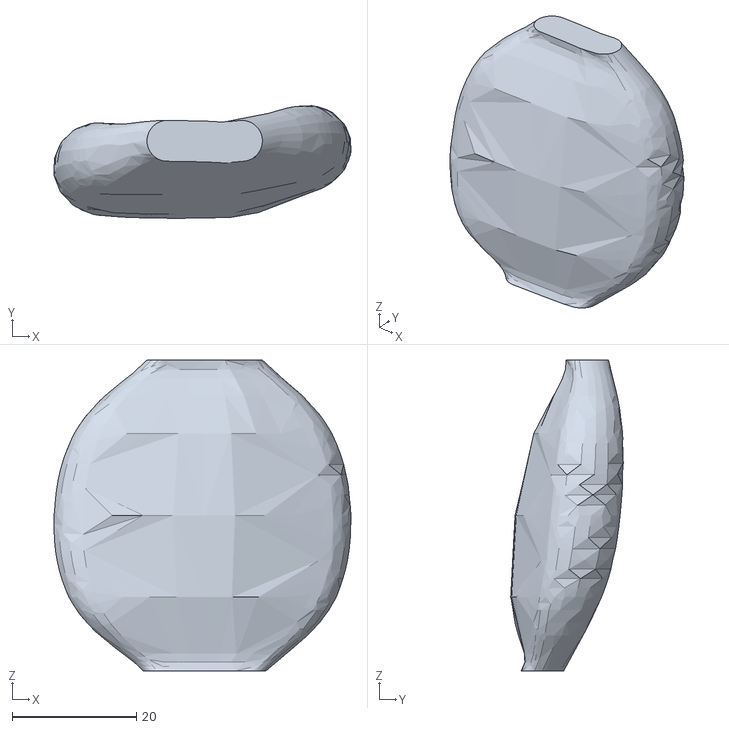
[picture p69: CAD file, 2026-10-22]
cad/stl/m4_clutch_r.stl
47.8 x 18.1 x 50.0
