nicedreamzapp/sitka/cad/stl/m4_heelclip_r.stl

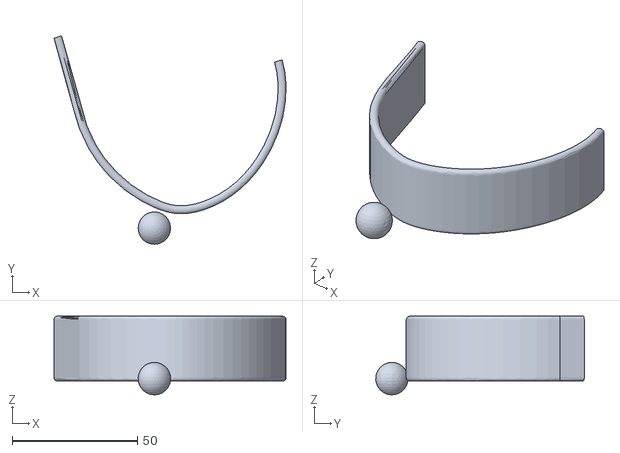
[picture p70: CAD file, 2026-10-22]
cad/stl/m4_heelclip_r.stl
92.8 x 83.4 x 31.5
