nicedreamzapp/sitka/cad/stl/shin_anchor_r.stl

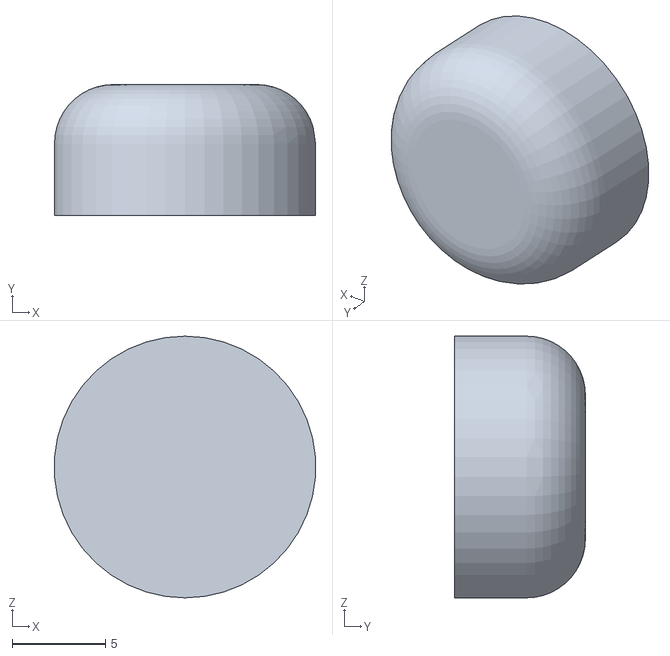
[picture p71: CAD file, 2026-10-22]
cad/stl/shin_anchor_r.stl
14.0 x 7.00 x 14.0
