nicedreamzapp/sitka/cad/stl/dring_ham_calf_l.stl

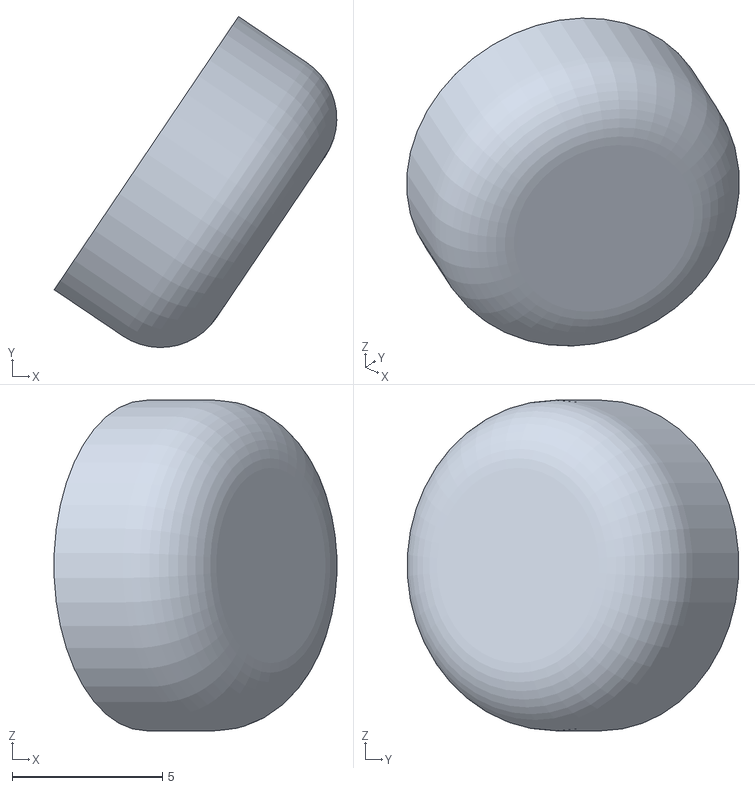
[picture p72: CAD file, 2026-10-22]
cad/stl/dring_ham_calf_l.stl
9.41 x 11.0 x 11.0
