nicedreamzapp/sitka/cad/stl/sit_leaf_root_r.stl

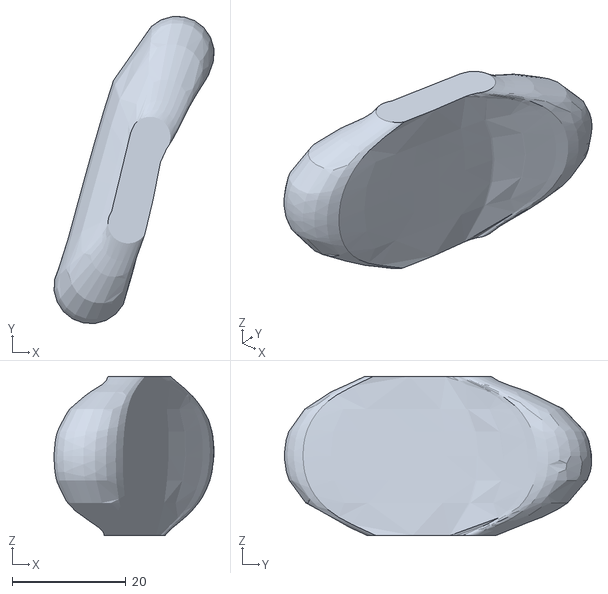
[picture p73: CAD file, 2026-10-22]
cad/stl/sit_leaf_root_r.stl
28.1 x 54.0 x 28.0
