nicedreamzapp/sitka/(list of files, cad)

Other CAD files:
cad/stl/strut_clip_hi_r.stl
cad/stl/dring_calf_r.stl
cad/stl/strut_hingepin_l.stl
cad/stl/m5_cassette_r.stl
cad/stl/thigh_liner_r.stl
cad/stl/port_shoulder_l.stl
cad/stl/dring_m3_l.stl
cad/stl/thigh_cuff_liner_r.stl
cad/stl/dring_t3_l.stl
cad/stl/m3_standoff_l.stl
cad/stl/dring_ham_l.stl
cad/stl/bowden_stop_l.stl
cad/stl/shin_liner_r.stl
cad/stl/dring_cc_r.stl
cad/stl/runband_clip_l.stl
cad/stl/strut_clip_r.stl
cad/stl/glute_guide_l.stl
cad/stl/knee_manifold_l.stl
cad/stl/panel_guide_r.stl
cad/stl/thigh_buckle0_l.stl
cad/stl/tendon_fairlead_l.stl
cad/stl/m5_armcuff_l.stl
cad/stl/port_hip_l.stl
cad/stl/knee_guide_r.stl
cad/stl/port_knee_r.stl
cad/stl/lumbar_standoff_r.stl
cad/stl/sit_leaf_root_l.stl
cad/stl/mode_lever_l.stl
cad/stl/m5_armliner_r.stl
cad/stl/dring_ham_calf_r.stl
cad/stl/port_knee_l.stl
cad/body/sitka_body.blend
