nicedreamzapp/sitka/(commit log)

2026-10-22 Run + Sit Exo: open powered knee exoskeleton with a built-in seat (P1 design)
    Parametric OpenSCAD model with pose parameter and renders, three.js viewer
    with assembly and on-body animations, physics models (seat torque, gait
    assist, energy/regen, mass), BOM with sourced prices, project cost ladder,
    research report, CERN-OHL-S / GPL-3.0 / CC-BY-SA licensing.
    [run_sit_exo.scad]
2026-10-22 Mount the stowed seat pad flush on the thigh rail; add live viewer links and Pages index
    The amber box on the thigh was the stowed seat pad floating 66 mm off the
    rail in battery-pack colours. It is now a charcoal foam cushion with an
    amber trim edge that folds flat against the rail's outer face (viewer and
    OpenSCAD), and sweeps under the thigh on an arc in seat modes. Verified
    both legs carry all 12 exo parts in every frame of the on-body animation.
    README links the live GitHub Pages viewer and embeds every render.
    [run_sit_exo.scad]
2026-10-22 v2 tripod seat: rear legs, free ankle pivot, one-way ratchet, straps and cables
    Viewer + both animations: rear legs (24/20/16 x 1.5 carbon, pivoting foot,
    stowable spike) deploy with the pads and land where the rear foot needs
    mu <= 0.30; live physics overlay (seat load, heel/ball/rear reactions, CoM,
    support polygon red under 0.10 m margin) computed with the same statics as
    seat_torque_model.mjs (matches within 1%); rear-leg toggle shows that only
    Perch survives without them; Perch labelled lean-assist (you balance).
    Suspension straps belt -> rail-top yoke, one sleeved 24 V + CAN cable per
    side, medial bars + bridges, single-axis medial hinge on a dashed axis,
    free ankle pivot joining shin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
    [run_sit_exo.scad]
2026-10-22 Viewer: fix giant chrome sheets; bolt ratchet + dual pawls to the actuator; final math numbers
    - Thigh rail was built with a negative RoundedBoxGeometry height, which clamped the
    corner radius to about -195 mm and turned the 8 x 28 mm rail into huge curved chrome
    sheets around the thighs/hips in every pose. Height is positive now; knee-mount slot
    moved to the rail's bottom end.
    - Suspension straps are now flat 25 mm webbing instead of 6 mm round tubes.
    - Ratchet sector bolted straight to the AK10-9 output flange (hub + 8 x M4 on a 72 mm
    circle); pawl bracket on the actuator case's outboard face with TWO 3-tooth pawls
    half a pitch apart, one latching solenoid + yoke and a mechanical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
    [run_sit_exo.scad]
2026-10-22 Rename to Sitka (after the Sitka spruce on the Trinidad bluffs)
    [run_sit_exo.scad]
2026-10-22 Tendon concept: physics check + side-view sketch
    Strut under the sit bone at 4 deg + 10 deg recline drops the knee to 34 Nm;
    80 mm arc on the knee hinge -> 426 N tendon, ~20 kPa worst pad. Old tripod
    geometry (79 Nm, 988 N, 47 kPa shin) does not close; pure soft exosuit does not close.
2026-10-22 Kinetics-first modular design: passive/quasi-passive tendons, one-motor tier, lift numbers, padding spec
2026-10-22 Retire the rigid v2/v3 CAD, renders and viewer; kinetics-first pivot (KINETICS.md, TENDON_CONCEPT.md)
    [run_sit_exo.scad]
2026-10-22 Sitka render two (1/4): kinetics-first CAD source, STL, docs, README, viewer page
    [back_panel_liner.stl, belt_buckle.stl, belt_sideclip_l.stl, belt_sideclip_r.stl, calf_liner_l.stl, calf_liner_r.stl, condyle_pad_lat_l.stl, condyle_pad_lat_r.stl]
2026-10-22 Viewer: phone-first layout
    Labels off by default with a toggle (major parts only, short names, hug the model);
    controls in a bottom sheet / side card, info as a collapsible bottom sheet with a handle;
    bottom dock with 44px play/pause/scrub/speed/stop; safe-area insets; fit-to-free-area
    camera framing; tap-a-part names it on touch; loading progress; no page zoom or text selection.
2026-10-22 Viewer: guided tour, simple main screen, plain names, cache-busting
    Six-step guided tour on first visit (localStorage; Tour button replays): one plain sentence per step,
    the relevant parts glow and everything else dims, phase chip driven by the same engagement states as
    the animation, Back/Next/Skip, ends with Explore on your own.
    Main screen: Tour / Walk / Sit / Lift big buttons + caption bar; poses, views, modules, explode,
    materials and scrub moved under Advanced. Plain part names in labels, tooltips and Details (technical
    names in small print). Build stamp + ?v= on the bundle and data files, no-cache meta, Labels: off text.
2026-10-22 Parts list and cost for the current design (PARTS_LIST.md, parts.csv)
    [parts.csv]
2026-10-23 Add CMU motion capture for the viewer: retarget module, 4 clips, credits
    cad/mocap/: retarget.py + bvh.py (from the Sitka film), CMU clips 35_01 walk, 35_17 run,
    86_09 sit/stand, 115_01 stoop lift, sequences.py (viewer sequences, grounding calibration,
    planted-foot trims, engagement states) and check_anim.py (frame-by-frame check of the baked data).
    CMU credit in cad/mocap/CREDITS.md, CREDITS.md and the README.
2026-10-23 assemble --anim: pose the viewer animation from mocap (default), --procedural keeps the old poses
    Each mocap frame poses the rig through cad/mocap/sequences.py and returns its grounded location;
    the output format and states semantics are unchanged, plus a per-sequence fps. Stowed struts carry
    their roll in the thigh frame (no 150-deg roll flips when a leg passes vertical). CHK log lines
    report sole, foot pitch and strut tip heights per frame.
2026-10-23 Rebuild sitka_anim.js from motion capture (152 frames: walk 27, run 24, sit 36, stand 28, lift 37)
2026-10-30 Smart brain: tiny mode model on simulated IMU + insole sensors, safety layer, live readout in the viewer; build 20261030-0246
    SMART_BRAIN.md describes the smart tier's on-board model: 2 IMUs per leg, a hub IMU and
    pressure insoles call STAND / WALK / RUN / SIT / LIFT 50 times a second, and plain-code rules
    decide every clutch and the motor. brain/ holds the shared sensor + model + rules code, a
    reproducible numpy trainer on CMU motion capture (held-out clips 85.6% per 20 ms step), and
    the viewer card that shows mode, confidence, clutches, motor, seat lock and safety vetoes.
2026-10-30 Fix the knee buckle at the end of the Lift; anatomy gate on every baked frame; build 20261030-0334
    The knee IK took its bend direction from the mocap knee's offset off the hip-ankle line. CMU 115_01's
    right leg is 1.5% shorter than the left (which sets the scale), so the Sitka right leg had to bend
    about 19 deg while the subject's was locked straight, and the bend direction came from a few mm of
    marker noise: the knee bent backwards (26-29 deg hyperextension), bowed out 12 deg and flipped frame
    to frame as he stood back up. Walk and run swing knees flared out 15-35 deg the same way.
    - retarget: the knee bends in the leg's own forward plane (pelvis heading, turned toward a flat
    foot's head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
2026-10-30 Strut hinge under the sit bone, laced seat cups, spine links, connection gate; build 20261030-0530
    - Strut hinge: fork + pin straight under the sit bone, rod-end eye on the tube, 5-section strut that stows down the back of the thigh in a clip at each end (clears the running calf)
    - Seat cup laced to the thigh cuff and tabbed to the shell; cup strap and panel straps removed
    - Two short rigid spine links panel to belt; the panel pose is solved on them each frame
    - Attachment fixes: strut hinge/clip animated with the thigh, knee side pads, shin/calf pads under the arms, whiffletree, lift tendon, calf band, Bowden, shoulder cassettes, belt edge, strut feet on the floor
    - Physics first: seat_sitb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
    [back_panel_liner.stl, bowden_stop_l.stl, bowden_stop_r.stl, calf_liner_l.stl, calf_liner_r.stl, condyle_pad_lat_l.stl, condyle_pad_lat_r.stl, condyle_pad_med_l.stl]
